karthiksing05/robot-as-a-verifier/docs/README.md

# Docs

| Page | Read it when |
|---|---|
| [Product](product.md) | You want what we're building and how the demo goes |
| [System 1 and System 2](system-boundary.md) | **You're about to add code.** Which system it belongs to, and what may cross between them |
| [Architecture](architecture.md) | You want how the parts fit, and the words we use for them |
| [Integration](integration.md) | You're connecting two parts, especially Joseph's sim to the server |
| [Hotspot and Vultr deployment](../deploy/vultr/README.md) | You're setting up the robot, Arduino readouts, remote harness, or hosted console |
| [Appliance sensor setup](appliance-sensor-setup.md) | You want the MC-6 and MW-1 readings in System 1, step by step |
| [Decisions](decisions.md) | Two sources disagree, or you want to know what's still open |
| [Sources](sources.md) | You want to know what's in the Google Doc, Kanban and artifacts |

Docs about one system stay with its code: [`system-1/sim/docs`](../system-1/sim/docs), and each folder's README. The pitch is in [`pitch`](pitch).
