karthiksing05/robot-as-a-verifier/docs/pitch/README.md

# Pitch

Owner: Karthik. The story and the claims are in [`docs/product.md`](../product.md).

| Here | What it is |
|---|---|
| `demo-script.md` | The three-minute script. To write (Kanban: Write the 3-minute demo script) |
| [`films/`](films) | Two 2-minute sim films, safe to show as backup. Label them as simulated |

Numbers to quote, as of Nov 6: 119 of 122 tests passed on 16 devices the sim wasn't tuned on, 0 false failures, simulation only. [Limits to state with them](../../system-1/sim/README.md#the-3-minute-version).

Sponsor angles: Midcentury Labs (labeled failure data), BotBlox (a reliable network for cameras and sensors), Clarapath (documented, repeatable procedures).
