karthiksing05/robot-as-a-verifier/docs/decisions.md

# Decisions

Where our sources disagreed, what this repo goes with, and why. Sources: the [Google Doc](https://docs.google.com/document/d/1fRen3rUlAyUSO0AACiKA1Zz-LrHpg4sqn350Y-rfYi0/edit), [Kanban](https://claude.ai/artifact/9Dm3x26boTyvHhrqAyEpaV), Joseph's code (`system-1/sim`), the [mockup](https://claude.ai/artifact/2wY8eCvh5VkNb8QSE98Sum), and the Nov 6 product brief.

**Rule used:** a newer source beats an older one, and tested code beats a plan. Anything that needed a judgment call is marked *please confirm*. Reopen any of these by editing this file and telling the team.

## Needs a team decision

| # | Question | Why it matters | Default until decided | Who |
|---|---|---|---|---|
| Q1 | How does the real survey get depth? See R1 | Blocks real perception | None yet | Joseph, Bayan |
| Q2 | What does a real verdict read: the Pico only, or camera too? See D10 | Sets what the pitch can claim | Pico for the demo | Joseph, Karthik |
| Q3 | What stack for the Console? See D14 | Frontend started on the default; the only server so far is the local sim bridge | FastAPI plus a Vite React app | Karthik, Bayan |
| Q5 | Does MakeCU allow pre-printed parts and pre-written code? | This repo is pre-written code | Assume yes, and confirm before hacking starts | Karthik (Kanban `l-rules`) |
| Q6 | Which track, healthcare or environmental? | Sets the pitch | Decide once tracks are posted | Karthik |
| Q7 | Which model does System 2 use, and which of the tools in D28 does it see? See D27 | Sets what the trace records and what can be rejected as the model's error | The trace logs any tool name. The sim logs `robot.run_step`, `perception.*`, `touch.*` and `plan.rules` | Karthik |

## Open risks

| # | Risk | Detail | Next step |
|---|---|---|---|
| R1 | **The real survey has no depth path on a Mac** (closed: the team dropped the iPhone, and `rgbperceive.survey_wrist` surveys with the wrist camera) | Joseph's survey uses iPhone LiDAR. The Doc's stack uses Continuity Camera, which is color only, and dropped Record3D because it has no macOS wheel. Nov 6: PyPI has no macOS wheel, but `record3d` 1.4.1 builds from source and imports on an Apple Silicon Mac (Python 3.12, CMake). `real_cameras.PhoneCamera` reads it. Not yet tried with a phone plugged in | Run `tools/cam_check.py lidar` with the iPhone on USB. If it fails: Record3D on the Windows laptop, or the panel plane from the ChArUco board plus a wrist scan. Kanban: *Decide the real survey's depth source* |
| R2 | Nothing has run on the real arm | Every number is from simulation. Glare and real plastic are the largest unknowns | The [bench tests](../system-1/sim/docs/sim-vs-real.md#first-things-to-measure-on-the-real-arm), first thing |
| R3 | Catching a real fault is only proven in sim | `system-1/sim/faults.py` jams `button_2`, and the run correctly fails it as stuck (Nov 6, depth route). Nothing has been tried on the printed Rev A | Rig Rev A and repeat on the real arm |
| R4 | Knobs are never tested | Turning one needs a pinch, so they are always refused | Fine for the demo: our appliance has no knob |
| R5 | Onshape parameter updates are unconfirmed | D23 depends on changing parameters through Onshape's API. Its docs cover Part Studio glTF export, but updating parameters hasn't been tested, and it adds setup risk at the event | **Mostly retired Nov 7.** `system-2/cad/tools/onshape_spike.py --scratch --public` passed 19 of 19 on a throwaway document: create one, add a variable, a sketch and an extrude, branch from a version, change a variable (the parts grew from 10 to 15 mm in the branch's assembly STEP), update, add and delete features, FeatureScript, a shaded view, STEP and glTF export, a version, and the assembly STEP loaded by our checks with its part names. Calls are recorded in `system-2/tests/fixtures/onshape/spike/`. Left: the same run on a copy of the real appliance. **Free Onshape accounts can only create public documents**, so the team's model, the analyst's branches and Rev B are public unless someone has an Education or paid account |

## Resolved

| # | Topic | Sources said | We go with | Why |
|---|---|---|---|---|
| D1 | Framing | Doc Overview: usability documentation on a Keurig. Doc Oct 31 and mockup: self-evolving hardware. Joseph: robot product tester. Brief: verifier for hardware R&D | The brief. Self-evolving is the fix loop, usability is the pitch story | Newest, and it includes the others |
| D2 | Force sensor | Doc stack: tip load cell + HX711. Doc Touch tab: FSRs and a load cell under the product. Joseph: SensX 25 pad + servos, "the team's". Kanban: borrowed sensors, load cell "if needed" | **SensX 25 pad**; load cell is the fallback. *Please confirm* | Tested: 119 of 122 with the pad, 120 of 122 with a load cell. The pads are in hand |
| D3 | Depth for the scan | Doc: Depth-Anything-V2-Small at 14 to 18 cm. Joseph: plane sweep over photo pairs 15 mm apart, at about 12 cm. Kanban: test Depth-Anything | **Plane sweep.** D405 stays the fallback (`--depth`). *Please confirm* | It's what's built and measured. No Depth-Anything code exists |
| D4 | Detector | Doc: OWLv2 or Grounding DINO, plus DINOv3. Joseph: OWLv2 + SAM 2.1 tiny | OWLv2 + SAM 2.1 tiny | Built and measured |
| D5 | Classifying parts | Doc and mockup: the model says what each part is. Joseph: rules on measured shape | Rules first. The model may add labels and manual matching | Works without a network, and keeps System 2 out of the measurements |
| D6 | IK | Doc: own `ik.py` on placo 0.10.2 | **Drop placo.** Use `robot.IK` | Tested Nov 6: `lerobot==0.6.1` and `placo==0.10.2` can't install together (numpy `<2.3` against `>=2.3,<2.4`). `robot.IK` exists and is what the results used |
| D7 | Install | Doc's command fails on D6 | `uv sync` extras in each system's `pyproject.toml`, one lockfile per system (D28). Only `opencv-contrib-python` is installed | Tested on Apple Silicon. lerobot's headless OpenCV would overwrite the `cv2` that has ChArUco |
| D8 | Skills | Doc: press, press_hold, push_latch, hook_pull. Older tab: press, turn, pull, lift and others. Joseph: press, flip, slide, turn, push_latch | Joseph's five are the closed list today. `press_hold` and `hook_pull` are planned | Built |
| D9 | Verdict words | Joseph: PASS, FAIL, MISSED, REFUSED, ABORTED. Mockup: passed, failed, observed, skipped, plus nine failure labels | Contract uses the mockup's. [Mapping](integration.md#units-and-vocabulary) | The sim's words stay in the sim. MISSED is kept apart from FAIL, so the robot's failures aren't blamed on the device |
| D10 | What decides a verdict | Mockup: camera and force only, wires are an independent check. Joseph and Kanban: the device's readout. Sim docs: reading a real device isn't built | Demo: the Pico readout decides, with force as evidence. Camera reading is the path to unwired products. *See Q2* | Most recent and matches the code |
| D11 | Concept memory thresholds | Older Doc tab and part of the mockup: 5 interactions. Doc stack: ancestor with at least 20 | 20 for expectations; below that, use the ranges table | The stack tab records a tested reason: small leaves gave biased means |
| D12 | Size check | Doc loop tab and Joseph's page: from depth. Doc stack and mockup: CAD kernel | CAD kernel bounding box | Stack tab is later, and it's exact |
| D13 | CAD format | Mockup: `testbox.scad`. Doc: OpenSCAD or CadQuery, then CadQuery | A JSON parameter patch behind `CadBackend`. The engine is now Onshape, see D23 | Patch format settled Oct 31. CadQuery was the engine until D23 |
| D14 | Front end | Doc: Rerun plus a static Jinja report; Streamlit and Gradio dropped. Kanban: editable graph, approvals. Brief: chat and steering | A web Console. Rerun stays for live force traces and the report stays HTML | A static page can't do chat or steering. *Stack is Q3* |
| D15 | Steering | Brief: steer at any time. Doc: model calls only between steps | Commands apply at the next step boundary. E-stop is immediate | Meets both |
| D16 | Owners | Doc tabs differ from each other. Kanban updated Nov 6 | Kanban | Newest |
| D17 | Demo machine | Doc: Karthik's MacBook. Kanban: Bayan's device. Joseph develops on Windows with an NVIDIA GPU | **System 1 runs on Joseph's Windows laptop. System 2 runs there too, or on Karthik's Mac.** Code stays cross-platform, except the wrist camera driver: `real_wrist.py` is the only one, as Joseph's PR #5 proposed | Karthik, Nov 6. The arm, cameras and GPU are on one machine, and System 2 may reach them over the network. `real_wrist.py` is Windows only, which fits |
| D18 | Localization route | Doc and mockup: unfamiliar device is the headline, CAD is the backup. Brief: CAD optional | The same. `register_cad` isn't built, so the backup today is taught poses | Consistent across sources |
| D19 | Demo length | Mockup check page: 90 seconds. Kanban and Doc: 3 minutes | 3 minutes | Newer |
| D20 | Servo voltage | Doc: open, 7.4 V or 12 V. Sim docs: the team's RobiServo-01, a 12 V clone | 12 V. *Please confirm* | Joseph's scripts assume it |
| D21 | Force caps | Mockup examples: 8 N. Code: 5 to 6 N per skill, 14 N the most a step may ask for, 15 N hard cap | Code values, until the day-1 scale test | Tested in sim |
| D22 | Console style | Mockup: Barlow Condensed and IBM Plex. Karthik, Nov 6: industrial, minimalist, serif plus technical fonts | Graphite and amber in a dark theme that isn't too dark, with a light theme available. Source Serif, JetBrains Mono, and Michroma for high-level moments only, with seamless motion leading. [Style study](https://claude.ai/artifact/Wmmtfsv3LoUoZ2ENZ3Dup7) | Karthik's choice. The Coverage Console mockup is dropped |
| D23 | CAD in the Console | Brief and D13: CadQuery, MCP optional. Karthik, Nov 6: Onshape, all within the application | Onshape as the engine, shown in our own viewer with parameters and an agent activity feed. Whether CadQuery stays as a fallback is undecided. See R5 | Confirmed by Karthik, Nov 6. Onshape's headers block iframes from our app, checked Nov 6 |
| D24 | Who approves | Plan: a teammate approves. Brief: a person approves before the arm moves or a patch prints | Karthik, Joseph, Max and Bayan approve. Judges can steer but can't approve or enter Prod. A CAD patch needs someone other than its author | Confirmed by Karthik, Nov 6. The Console applies this in the browser until a server does. With D25 anyone can change who they're acting as, so it's a courtesy for now |
| D25 | Entering the Console | Karthik, Nov 6 first asked for a light account and password system, then for a Go button replacing all logins | No login. Choose Demo or Prod, then GO. The top bar sets who you're acting as. Staging is dropped | Karthik's choice. Demo is the sim. Prod is where we do real interfacing, with the real arm and real CAD, and it's empty until those connect. Local only: real accounts belong on a server before this leaves localhost |
| D26 | Watching a run | Doc: Rerun for live force traces. Karthik, Nov 6: cameras and flowchart updating in real time, inside the Console, from Joseph's MuJoCo code. Revisit a run in one click, no tabs | `system-2/console/server/live_sim.py` runs `explore.py` unchanged, 4x by default. The browser draws the main view from streamed body poses, and the other cameras stream as pictures. Each run saves its poses, the other cameras and a timeline, and replays in the same 3D view. One page per run | Server-rendered pictures looked slow and capped at 30 fps, though the physics alone runs at 36x real time. Speed changes the pace of sim time on screen, not the physics. Stdlib HTTP for now, see Q3 |
| D27 | Diagnosing a run | Karthik, Nov 6: a frontier model will operate the robot as if it were an MCP server, with tool calls throughout, so logs must separate LLM failures from pipeline failures | `model_turn` and `tool_call` events in the run log, shown in the stage pane. Each failure is filed under Model, Pipeline, Robot or Device. [How it works](integration.md#the-model-trace) | The kind of error is recorded where it happens. Sensors still decide verdicts: a model's claim is only checked against them. See Q7 |
| D28 | System 1 and System 2 | Earlier docs: System 2 is only the model, and packages share contracts. Karthik, Nov 6: two root folders, one for the robot and one for the harness and Console, with as little traffic between them as possible, MCP-style by default and open to alternatives | [`system-1/`, `system-2/` and a shared `docs/`](system-boundary.md). MCP for control, with no motor or joint tool; separate one-way telemetry for the Console. A clean FAIL always wakes System 2. Start with frequent deferral and scale back from measurements. Amended plans get [priority levels](system-boundary.md#approving-an-amended-plan), so not every one needs a person | Karthik chose these Nov 6, including routines-only writes, so low-level control stays in System 1 |
| D29 | How the analyst fixes the CAD | D13 and the Doc: a one-parameter JSON patch. Bayan, Nov 7: the analyst has the robot's evidence, so it should CAD the fix itself, in Onshape, where the team's models are | The analyst edits the real Onshape model on a **branch of its own** made from the tested version, through the `rav-cad` MCP tools (features, variables, measure, render, check, submit). Generic robot-centred checks judge the exported STEP: scope (one control's reprintable parts), no overlap, free motion, fit clearance, fingertip reach and a hookable pull. A person approves; the backend makes the Rev B version and exports only the changed parts. CadQuery stays as the offline fallback (settles D23's open question) | Branches keep the tested version untouched, and checks on any product's geometry, not our parametric code, make it work beyond the planted faults. Waits on R5. Built by Bayan, Nov 7 |
| D30 | Who can run the sim | Karthik, Nov 7: optimize the SO-101 sim so anyone can work on it, kept to the front end | `sample-sim`, a real recorded run, replays in 3D with only `npm install`. A `live-depth` install runs the bridge without PyTorch. The viewer lowers its own quality to keep up | Read as: any teammate, on any laptop, with no sim setup. System 1 is untouched. Results were identical with the server's render on and off, at 1x, 4x and 8x. Tried on one Mac only, so Windows and Linux are unproven |
| D31 | System 1 for an outside caller | `system-1/HANDOFF.md`'s suggestions, Karthik's to Joseph, Nov 7. Joseph hasn't answered yet, so **each is a default Joseph can overrule** | A new device means restarting the server, with no reset tool. Plans are validated from the contract alone (`check_steps`), so no robot or worker thread is involved, and what depends on where a part will be stays a refusal at run time. A failed `Step.check` is reported beside the verdict and wakes System 2 as `unexpected_response`, without changing the verdict. The force limit a step may ask for is 14 N, and above that it's rejected rather than clamped. Test devices: preset C and generated seeds | Built by Karthik's side, Nov 7, because the model integration needed it. Verdict rules and `plan_tests` are unchanged |
| D32 | Force sensing with servos only, at stretched poses. **For Joseph to review and measure** | The real arm is a stock SO-101 with nothing added, so force comes only from the servos' own estimate (`sensing="current"`). In the sim, low and far poses near the test devices' dials and toggles (tip z about 20–30 mm, about 250 mm out) read 6–13 N with about 0–4 N really on the tip, always along one direction | **The 15 N hard cap is unchanged and still reads the plain estimate.** Skills only stop trusting it where it can't be right: a descent needs the pad to stall before it counts as landed, and the side-force and pushed-off checks scale the estimate by how well the joints feel each direction (`ArmBase.weighted_force_vec`). Two cap changes were tried and **backed out**: a free-air baseline pass (the drift appears with contact, not in free air: 1.5 N in the pass, 12 N in the push) and fitting the force at the fingertip's contact point (no change). Stock-gripper turns there still stop at the cap, so they're reported as not working rather than worked around | The cap protects the arm and devices, so it isn't changed without a measurement. The errors lie along the Jacobian's weakest direction: its smallest singular value falls to 0.045–0.06 m there, against 0.11–0.13 m on the default rig, and that direction is about the probe's own axis on the slanted panels. **Whether this is real or a sim artifact can't be told from the sim.** The sim's estimator ignores the gear friction the sim itself models (Rhoban BAM fit, about 0.28–0.43 × load), and friction divided by a small singular value would give this pattern. A real rig's estimator has the same blind spot unless it models friction. To measure on the raw arm: hold the tip over a dial at the centrifuge pose (tip about 250 mm out, 20–30 mm up, tool 45° down), move 15 mm slowly in free air, then press a kitchen scale with about 3 N, and log the estimate both times. Under about 2 N of error means it's the sim |
| D33 | Free-form geometry offline | D29: Onshape is the only path where the model designs new geometry; CadQuery only changes built-in parameters. Bayan, Nov 7: let the model generate new geometry with CadQuery too | The analyst writes CadQuery code that makes a new solid for a reprintable part, in a local workspace per finding (`rav-cad-local` tools), run in a separate process with an import allowlist and a time limit. The same generic checks judge it, and `apply` writes the changed parts' STLs, the assembly and the code. Works on any product we have as a STEP assembly, and on our box | No Onshape quota (we hit a 20-hour per-endpoint lock; free accounts get 2,500 calls a year), no network, and the blind centrifuge test can be repeated for comparison. The sandbox guards against mistakes, not attacks. Built by Bayan, Nov 7 |
| D34 | Merging main (PRs #4–#10) into the frontier branch. **Joseph can overrule any of it** | Both sides changed the same lines in `affordances.py`, `main.py`, `sim_rig.py` and `HANDOFF.md`, and both added a D31 | Joseph's toggle fix, lost-readout back-off and counted-steps rule are kept as he wrote them. `turned_deg` comes from the skill's `turned` (the swept angle where the turn measures it, else travel over radius), which already agrees with his. `rav-server --robot real` gets telemetry like the sim, served after the torque gate; shutdown is engine, then torque off, then telemetry. Our `pipeline_error` stop wraps a scan's unknown errors, but an error raised once the real arm's torque is off (Ctrl+C) stays a `safety_abort`, as Joseph's `test_real_backend.py` requires. `make_rig` takes `device`, `rev`, `effector`, `mounts` and `driver` together; `effector="stock"` through `driver="real"` is untested. `HANDOFF.md` stays deleted and its real-arm list, with Joseph's Pico and hand-eye updates, is in the [server README](../system-1/server/README.md). A new, dated [`HANDOFF.md`](../system-1/HANDOFF.md) covers what changed since. Bayan's D31 is now D33 | Keep both sides' features, and leave verdict and safety logic as Joseph has it. The 15 N cap is unchanged |
| D35 | How a pinch-turn knows how far the dial went. **For Joseph to review** | The stock gripper's pinch-turn holds the knob at about 18 N, well inside friction, yet in the sim the knob lags the wrist in proportion to the dial's friction. On centrifuge v7's 0.015 N·m pot it turned 50° for 59° of the wrist; at 0 N·m it turned 54.6° for 55.9°. That is MuJoCo's soft-contact creep, and printed jaws on a real knob may creep or slip too | **The fix is in the skill, not the sim.** impratio, cones and noslip are unchanged; noslip made it worse because it also stiffens the knob joint's own friction. `_pinch_turn` grips again for whatever is left, up to 6 grips, until it is within 4° of the request. It does this too when the wrist roll's range ends a grip, so large turns reach the end stops. Each grip's angle comes from the robot's own measure. With a wrist camera, that is the fin's line seen before and after the grip (`perceive.refine` now sets `meta.seen_x`); without one, it is the wrist's turn while the jaws held the knob. **Never the device's reading:** a dead pot or a wrong mapping must still show as a fault | Open: from the pinch's look poses, the camera route doesn't find these dials (the gripper hides them), so the loop falls back to the wrist and still misses the creep. The next step is a look pose that sees the fin, or a dial rule that works through the jaws |
| D36 | Closing the CAD loop from a real run, and retesting a fix in the sim | The CAD analyst only ran from `rav mock` or from a recorded run whose findings already used CAD names; the Snowflake agent's runs ended at the report, and the sim set a button's travel from the revision letter, so no CAD change could reach a retest. | `rav fix` / `rav eval --fix`: a run's findings are matched to CAD controls by place (the device's pose from where its controls are, `match.py`), go to the local CadQuery analyst with tags generated from the device file (`rav_cad/appliance.py`), are applied when approved (automatic and recorded in the sim, `--approve NAME` otherwise), and on an authored appliance the same model reruns on a patched device. **Fit model:** a sliding fit under 0.3 mm per side binds and travels 0.1 mm, else its full travel; it reproduces every authored button travel (interval timer, label printer, wall thermostat, Rev A and B), so a patched device derives travel from its geometry. One line in `cad_device.py`: a device file's own `params` win over its revision's. Sliding buttons only so far. | Bayan, Nov 8 |
| D37 | Current physical appliance firmware | Earlier MC-6/MW-1 snapshots are stored beside each appliance | The standalone Uno R4 WiFi project lives in [`firmware/`](../firmware/README.md), with PlatformIO targets, operator tools and calibration records. Older snapshots and simulation definitions remain in place; the two systems' imports and control interfaces are unchanged | Max requested this top-level folder on Nov 8 |

## Not updated, on purpose

The mockup and Joseph's page are still accurate as what they are: a vision walkthrough and a results page. They mention older choices (Depth-Anything, load cell, `testbox.scad` in the mockup; "fits its size from depth" on Joseph's page). This table overrides them.
