karthiksing05/robot-as-a-verifier/docs/sources.md

# Sources

## The living ones

| Source | Use it for | Keep it current by |
|---|---|---|
| [Kanban](https://claude.ai/artifact/9Dm3x26boTyvHhrqAyEpaV) | Tasks, owners, status | Moving your card |
| [System 1 and System 2](https://claude.ai/artifact/6d9gQhE7LqDb9xUeMPYPDa) | The split, to share with people outside the code | Republishing it when [the design](system-boundary.md) changes |
| This repo | Architecture, interfaces, decisions | Changing it in the same commit as the code |

## The references

| Source | What's in it |
|---|---|
| [Google Doc: MakeCU-2026 Prep](https://docs.google.com/document/d/1fRen3rUlAyUSO0AACiKA1Zz-LrHpg4sqn350Y-rfYi0/edit) | Why decisions were made. Start at its **Current State** tab |
| [Self-Evolving Hardware mockup](https://claude.ai/artifact/2wY8eCvh5VkNb8QSE98Sum) | The end-product vision: case studies, fix loop, data objects, stage-by-stage check |
| [Self-Evolving Robots](https://claude.ai/artifact/VxmRPoiAXK3pCHxKmjgRv6) | Karthik's harness development in simulation, and the lessons for MakeCU |
| [Robot Product Tester](https://claude.ai/artifact/Fia1Xqk11wDS5uwNQLh3ci) | Joseph's results page |

## Google Doc tabs still worth reading

| You want | Tab |
|---|---|
| Parts and prices | Hardware > Parts and BOM, Sensors and Add-ons |
| Arm build, printing | Hardware > Arm and Mount, CAD Scope |
| Reasons for the stack | Final Plan > Software Stack (final), with the changes in [decisions](decisions.md) |
| Posture and budgets | Final Plan > Software Stack (final), sections 7 and 8 |
| Self-evolving tool ideas | Final Plan > Self-Evolving Robot (concept) |
| Concept memory data | Final Plan > Concept Memory (Cobweb) |
| Related work | Lit Review, Vibe-CAD and CAD Agents |
| CAD MCP options | Vibe-CAD and CAD Agents, section 5 |

The Overview, Software, Pitch and Planning tabs record the earlier usability framing and are kept for history.
