karthiksing05/robot-as-a-verifier/appliances/centrifuge/source/electronics/grove_ports.png

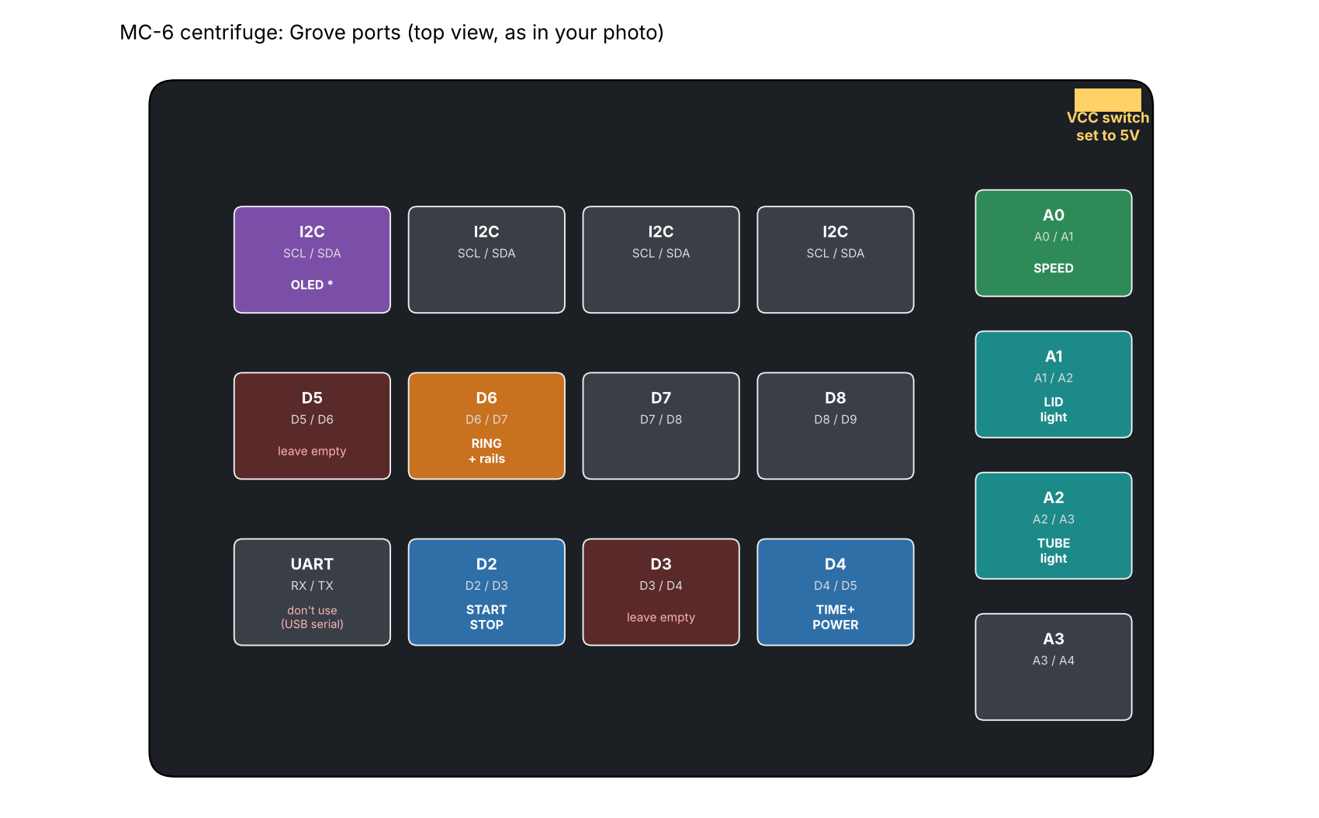
appliances/centrifuge/source/electronics/grove_ports.png
