karthiksing05/robot-as-a-verifier/appliances/centrifuge/source/electronics/schematic.png

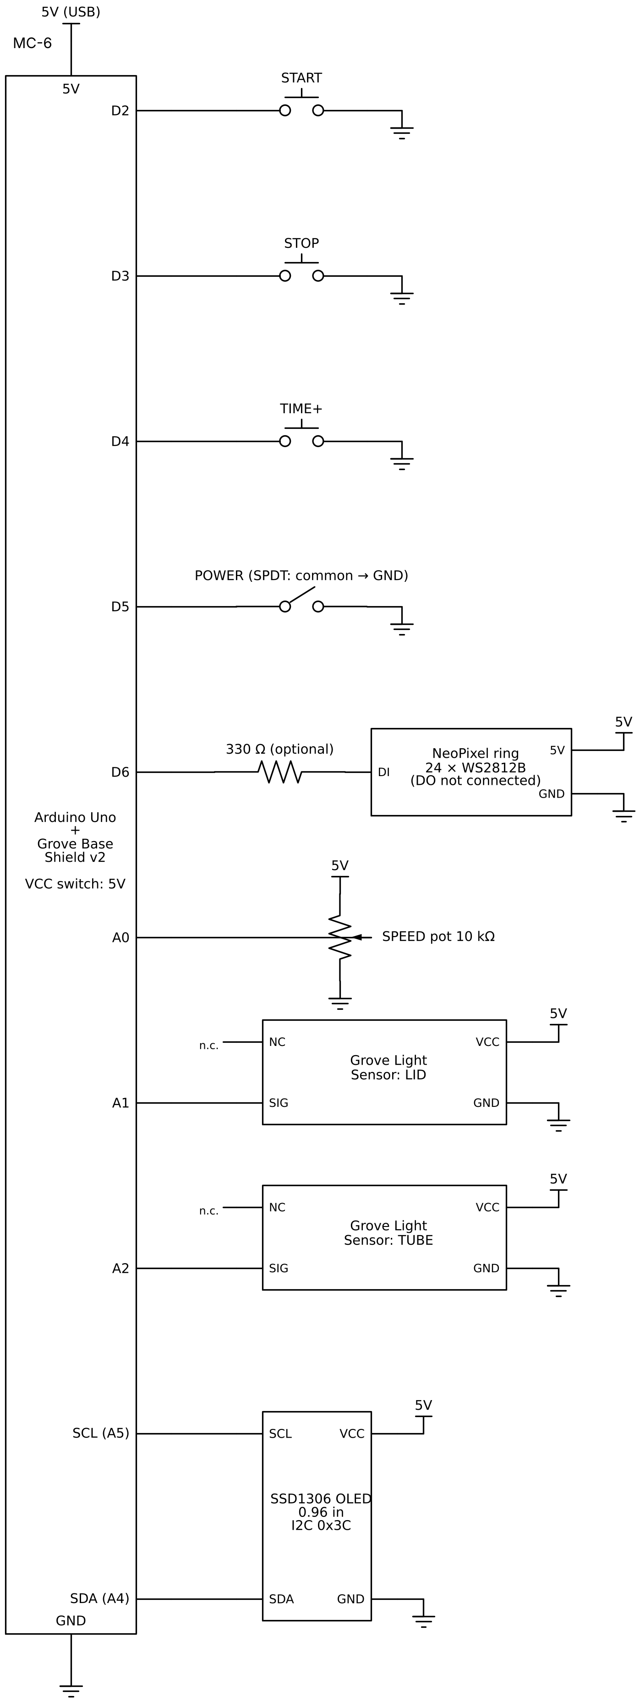
appliances/centrifuge/source/electronics/schematic.png
