karthiksing05/robot-as-a-verifier/appliances/centrifuge/source/laser/2_nested_sheets_kerf_applied/acrylic_3mm_clear_sheet1_600x300_preview.png

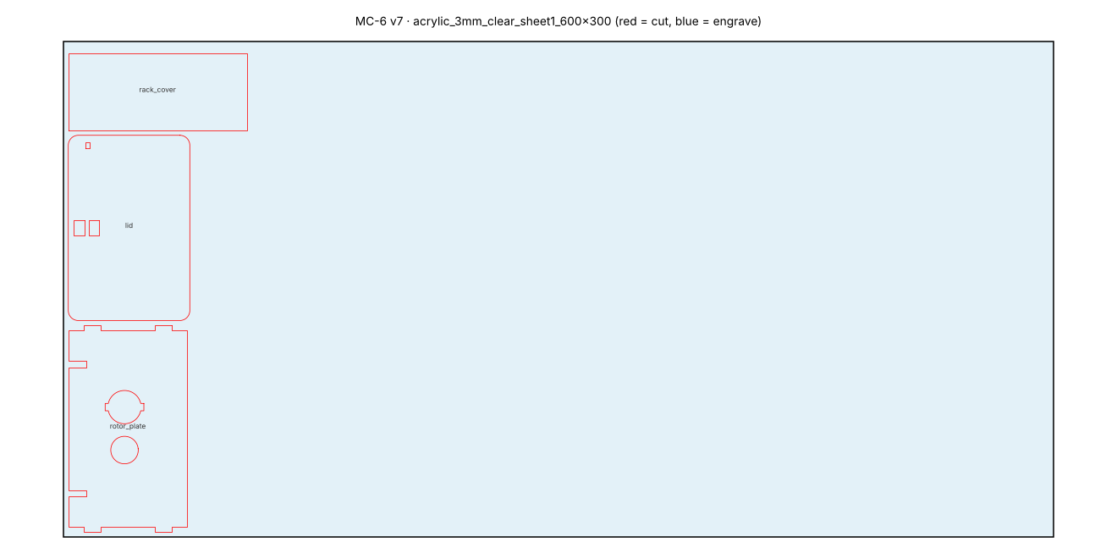
appliances/centrifuge/source/laser/2_nested_sheets_kerf_applied/acrylic_3mm_clear_sheet1_600x300_preview.png
