karthiksing05/robot-as-a-verifier/appliances/centrifuge/source/photos/control_face_panel16_preview.png

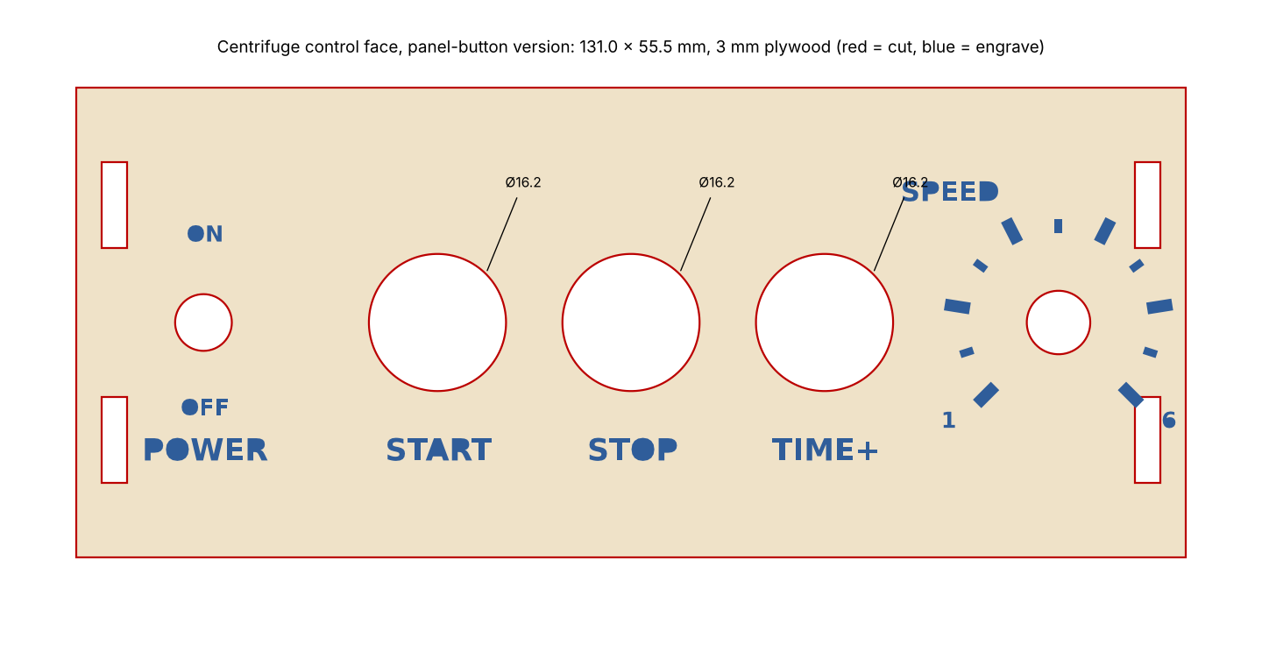
appliances/centrifuge/source/photos/control_face_panel16_preview.png
