karthiksing05/robot-as-a-verifier/appliances/centrifuge/source/photos/fig_centrifuge.png

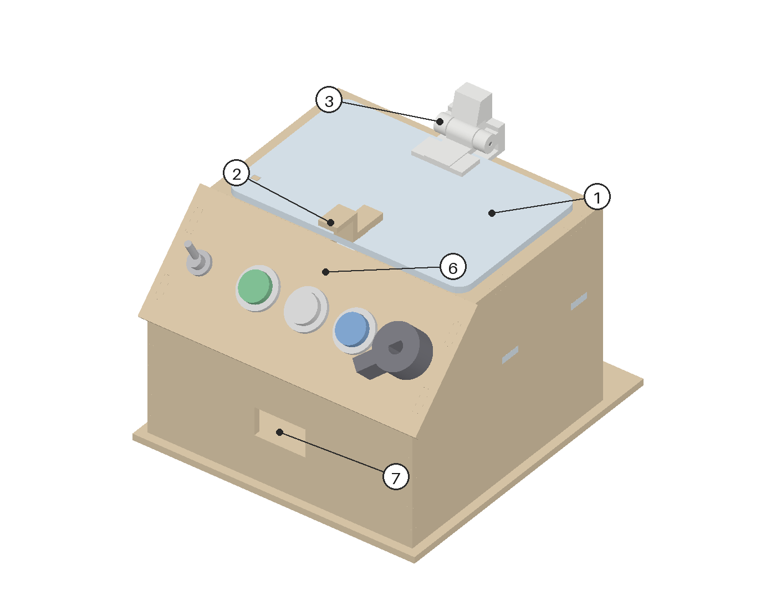
appliances/centrifuge/source/photos/fig_centrifuge.png
