karthiksing05/robot-as-a-verifier/appliances/centrifuge/source/photos/fig_panel.png

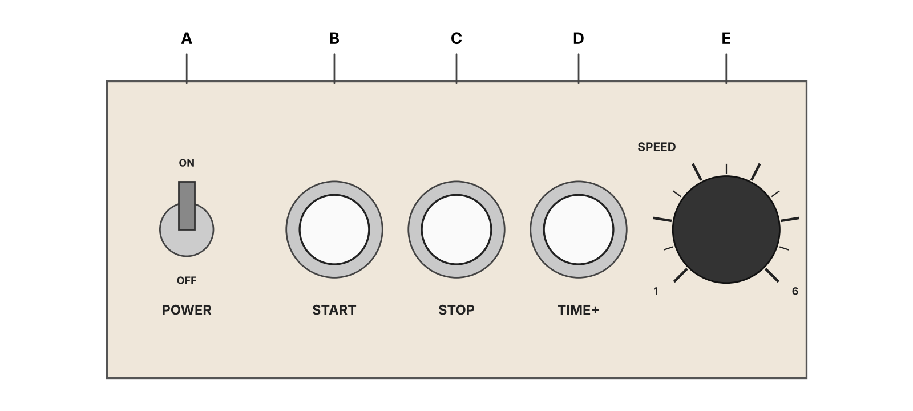
appliances/centrifuge/source/photos/fig_panel.png
