karthiksing05/robot-as-a-verifier/appliances/centrifuge/source/photos/fig_rack.png

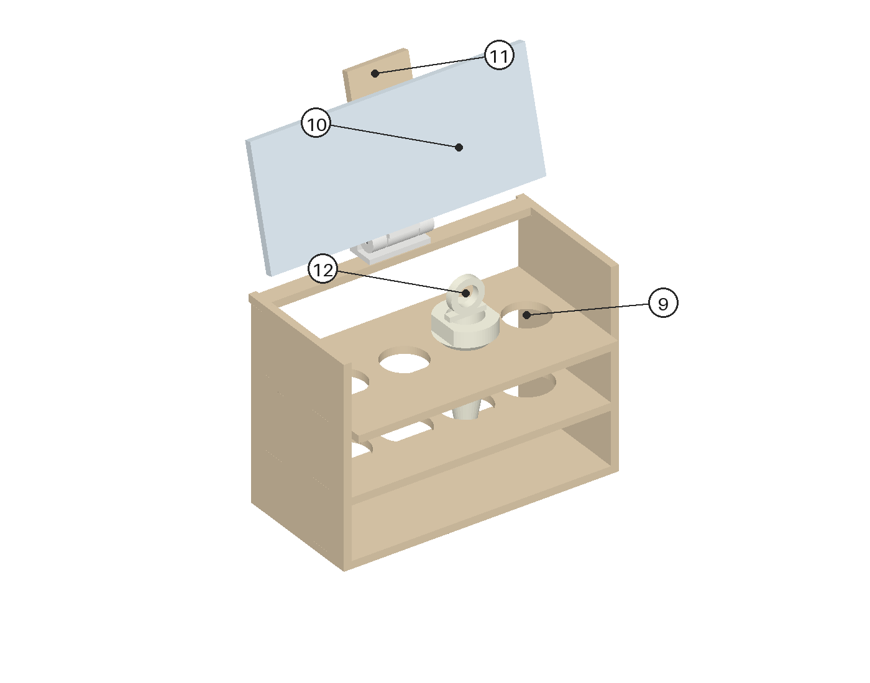
appliances/centrifuge/source/photos/fig_rack.png
