karthiksing05/robot-as-a-verifier/appliances/centrifuge/source/photos/fig_wells.png

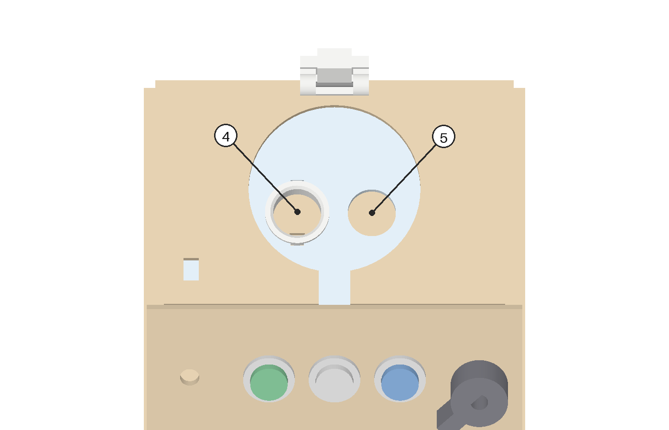
appliances/centrifuge/source/photos/fig_wells.png
