karthiksing05/robot-as-a-verifier/appliances/microwave/source/electronics/grove_ports.png

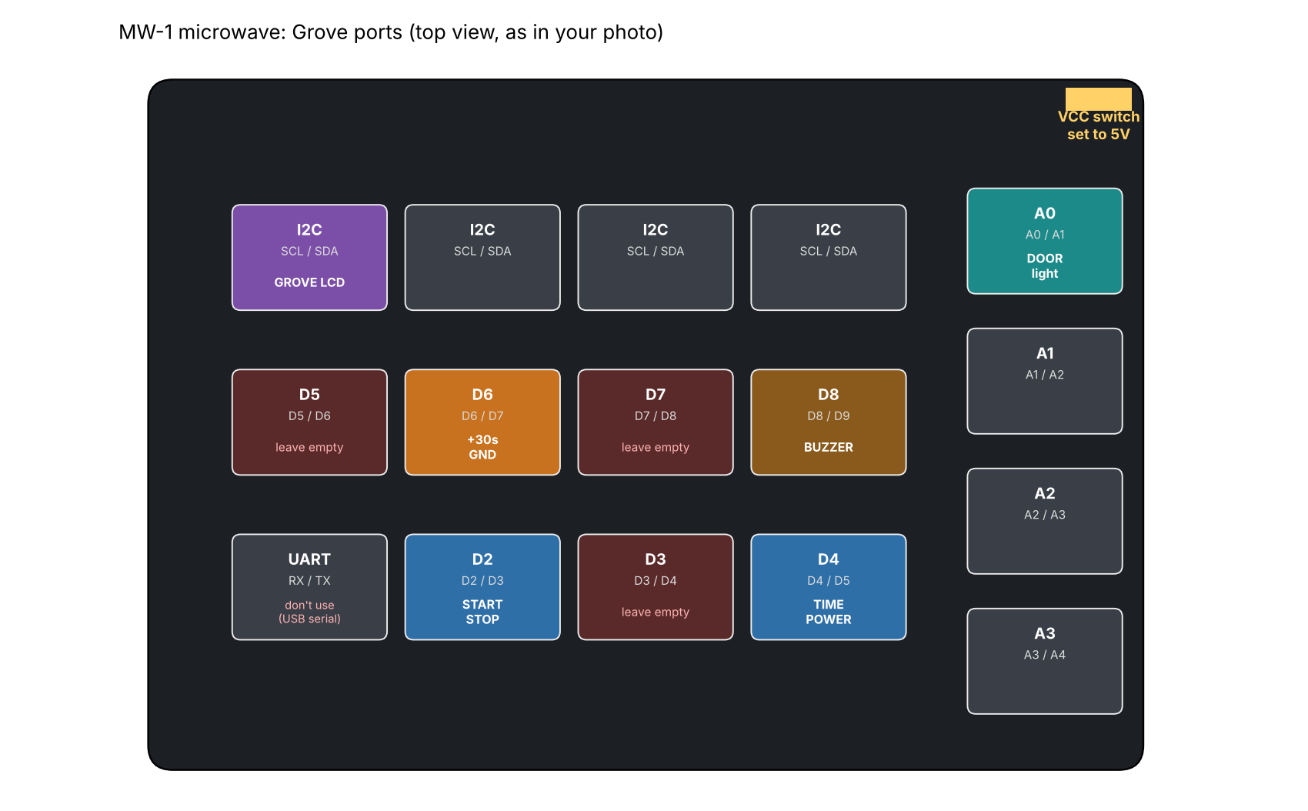
appliances/microwave/source/electronics/grove_ports.png
