karthiksing05/robot-as-a-verifier/appliances/microwave/source/electronics/schematic.png

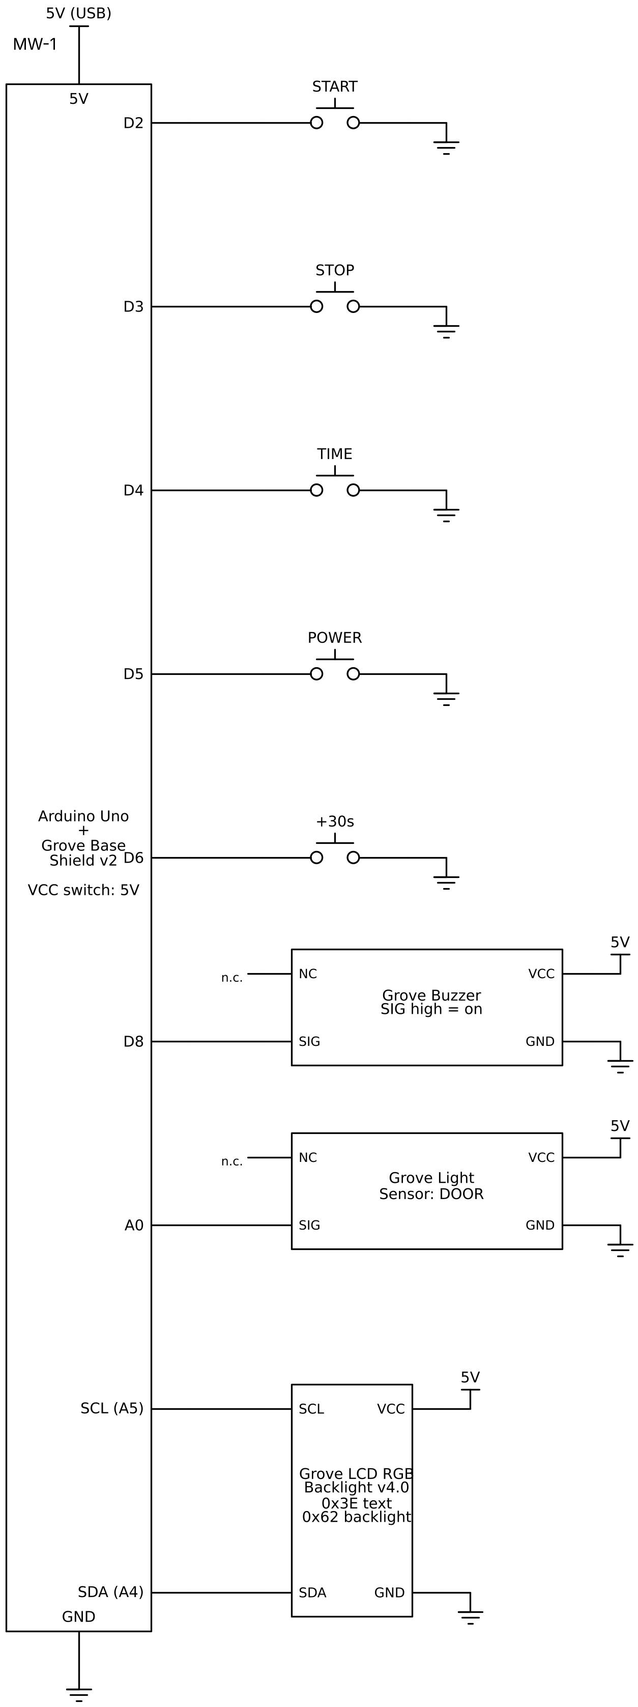
appliances/microwave/source/electronics/schematic.png
