karthiksing05/robot-as-a-verifier/appliances/microwave/source/laser/2_nested_sheets_kerf_applied/plywood_3mm_sheet2_600x300_preview.png

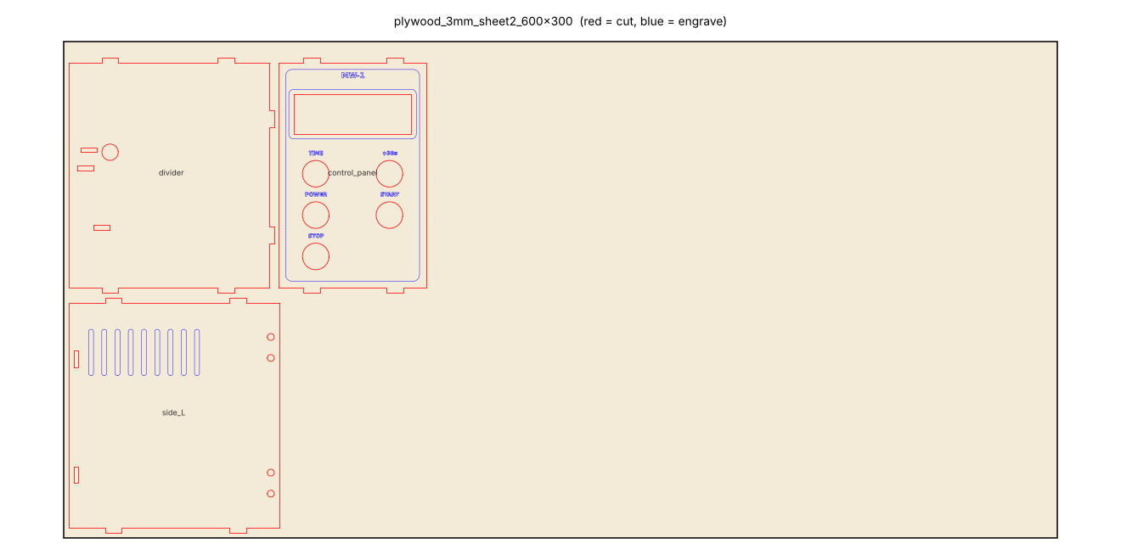
appliances/microwave/source/laser/2_nested_sheets_kerf_applied/plywood_3mm_sheet2_600x300_preview.png
