karthiksing05/robot-as-a-verifier/appliances/microwave/source/photos/01_closed.png

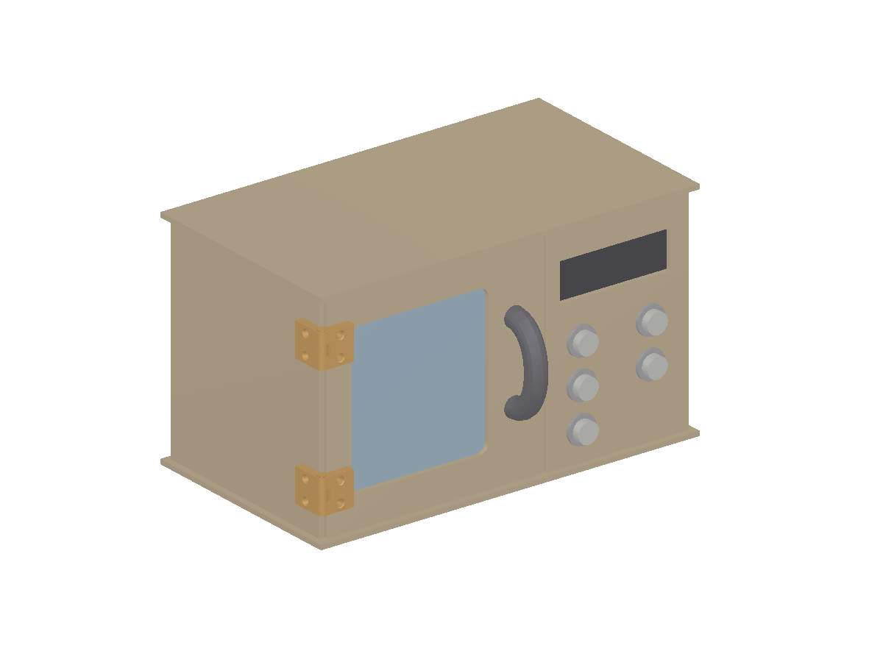
appliances/microwave/source/photos/01_closed.png
