karthiksing05/robot-as-a-verifier/appliances/microwave/source/photos/02_door_open.png

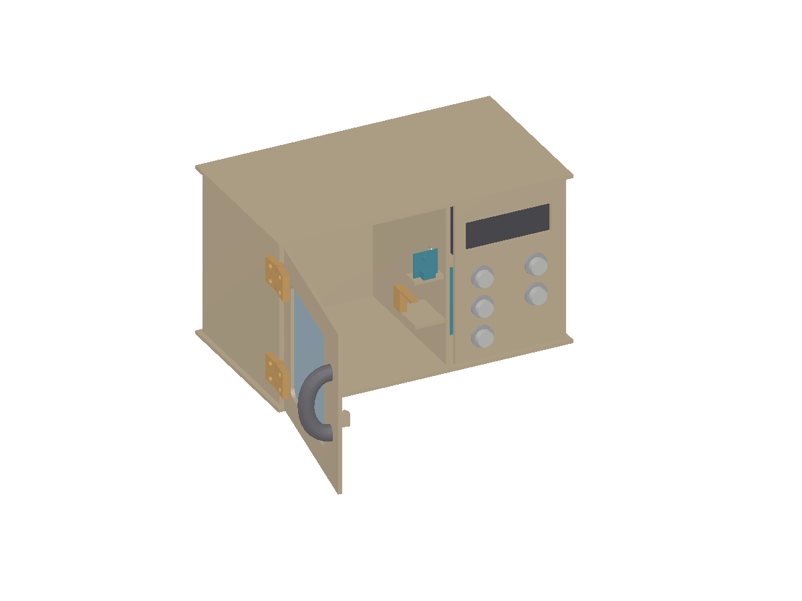
appliances/microwave/source/photos/02_door_open.png
