karthiksing05/robot-as-a-verifier/appliances/microwave/source/photos/03_inside.png

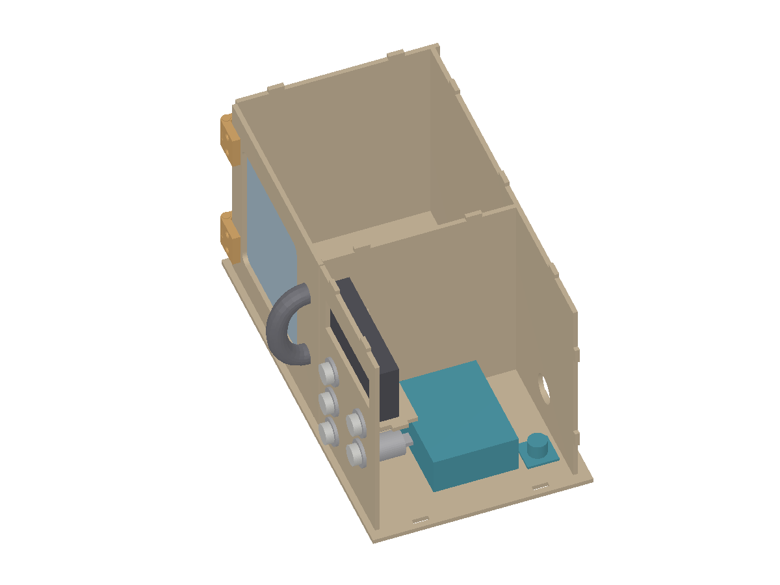
appliances/microwave/source/photos/03_inside.png
