karthiksing05/robot-as-a-verifier/appliances/microwave/source/photos/04_bay_and_latch.png

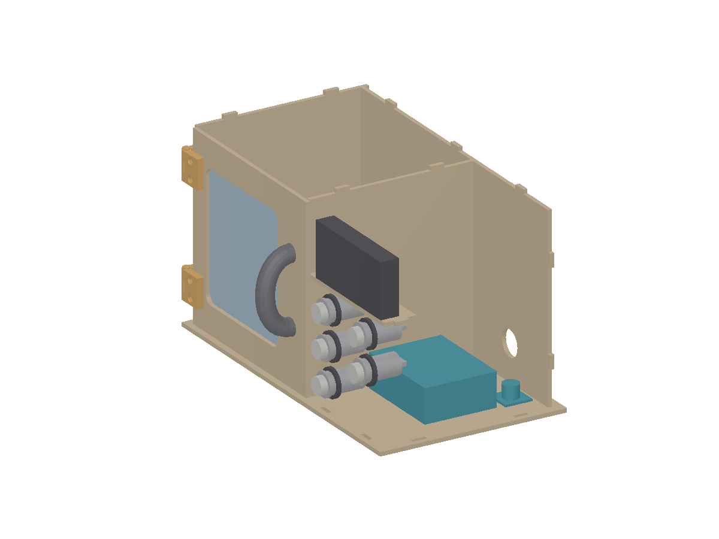
appliances/microwave/source/photos/04_bay_and_latch.png
