karthiksing05/robot-as-a-verifier/appliances/microwave/source/photos/05_front.png

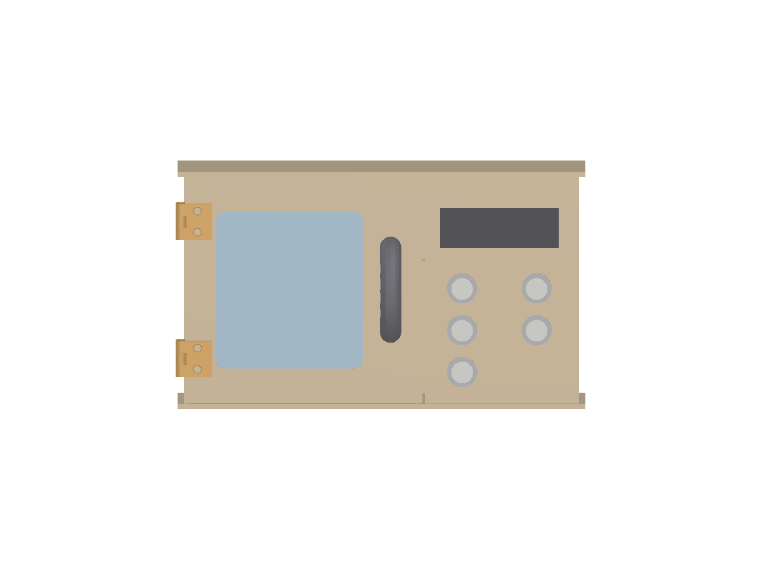
appliances/microwave/source/photos/05_front.png
