karthiksing05/robot-as-a-verifier/appliances/microwave/source/photos/06_front_engraving.png

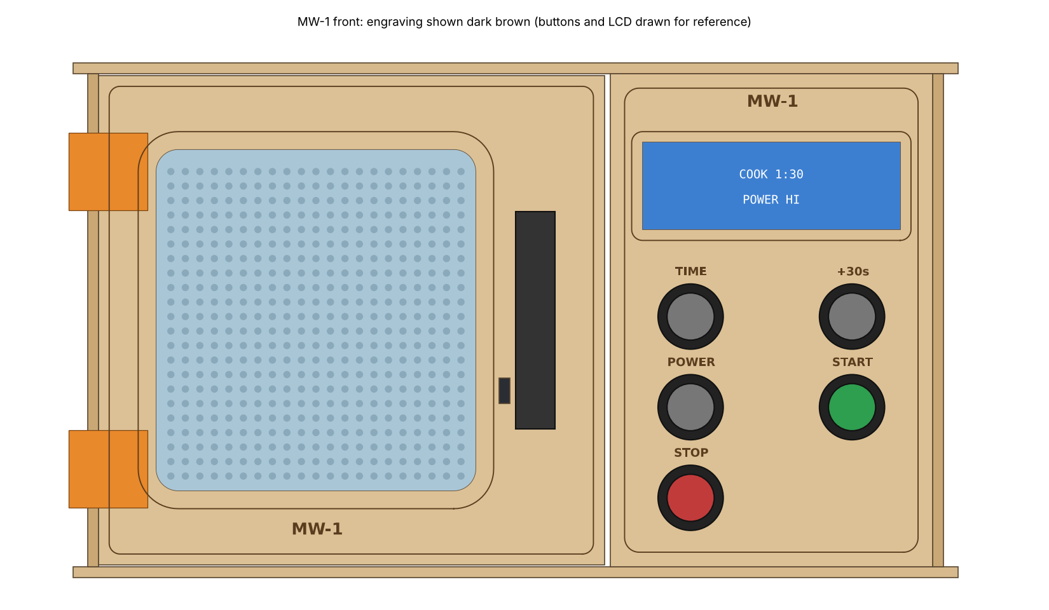
appliances/microwave/source/photos/06_front_engraving.png
