karthiksing05/robot-as-a-verifier/docs/pitch/slides/img/raav_hand.png

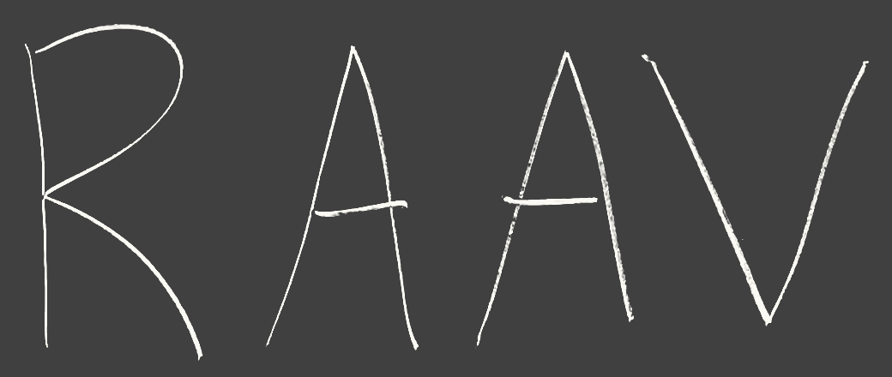
docs/pitch/slides/img/raav_hand.png
