karthiksing05/robot-as-a-verifier/docs/pitch/slides/slide_01.png

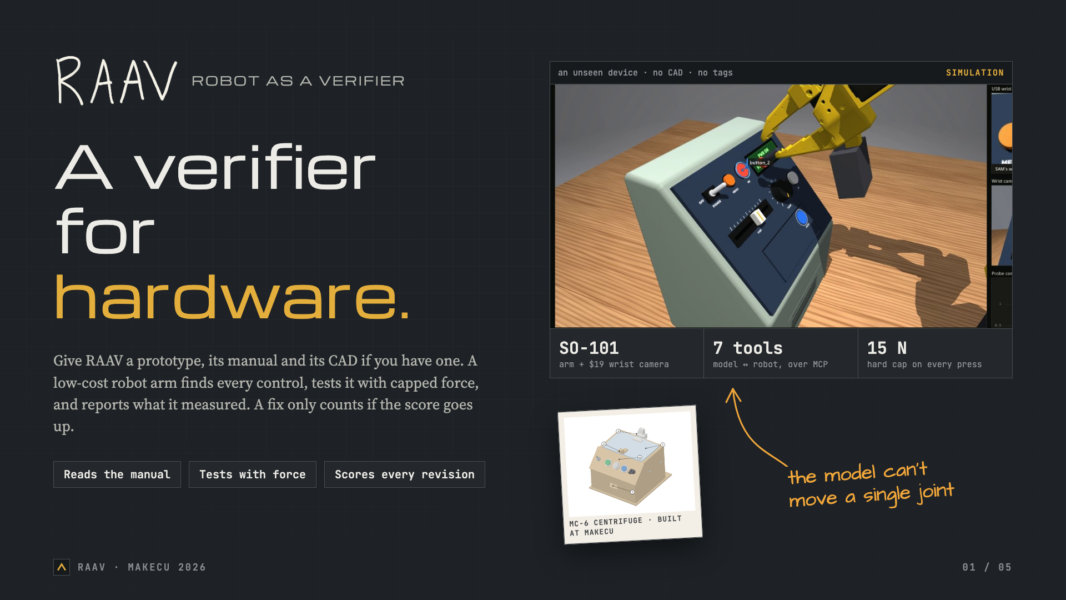
docs/pitch/slides/slide_01.png
