karthiksing05/robot-as-a-verifier/docs/pitch/slides/slide_02.png

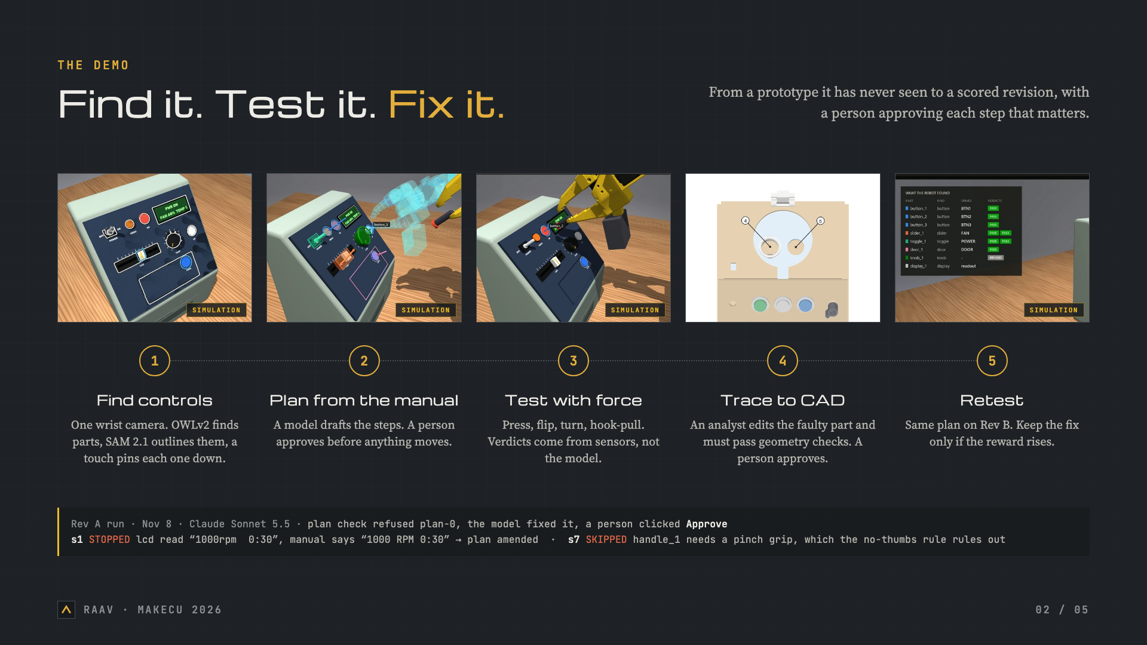
docs/pitch/slides/slide_02.png
