karthiksing05/robot-as-a-verifier/docs/pitch/slides/slide_03.png

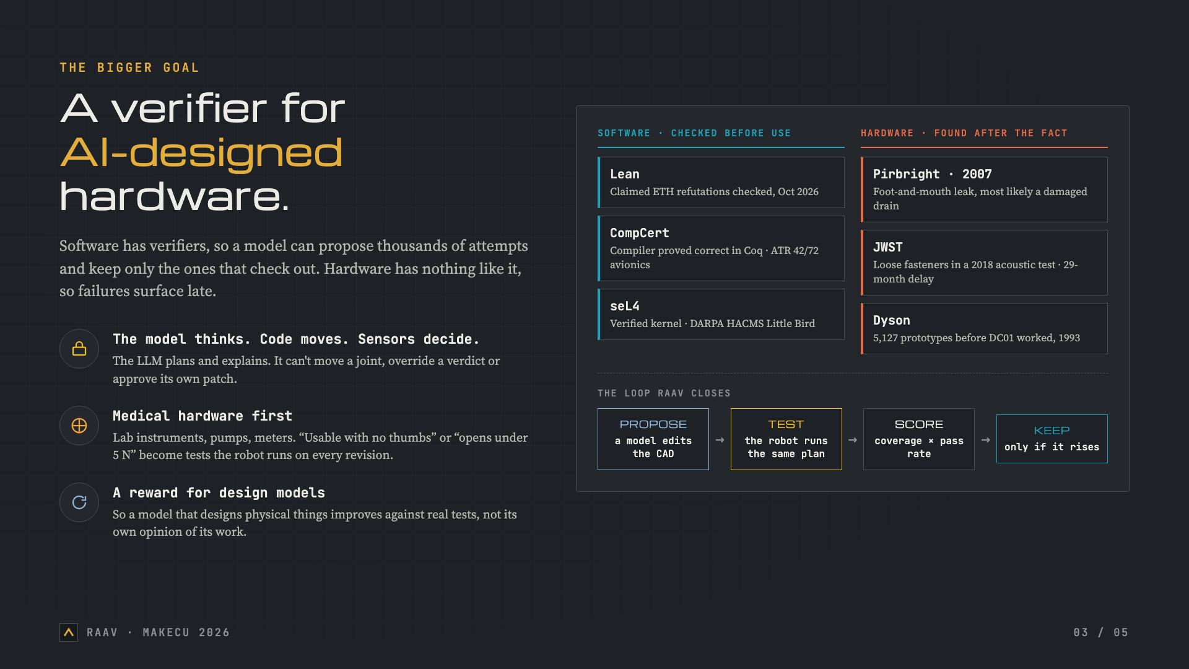
docs/pitch/slides/slide_03.png
