karthiksing05/robot-as-a-verifier/docs/pitch/slides/slide_04.png

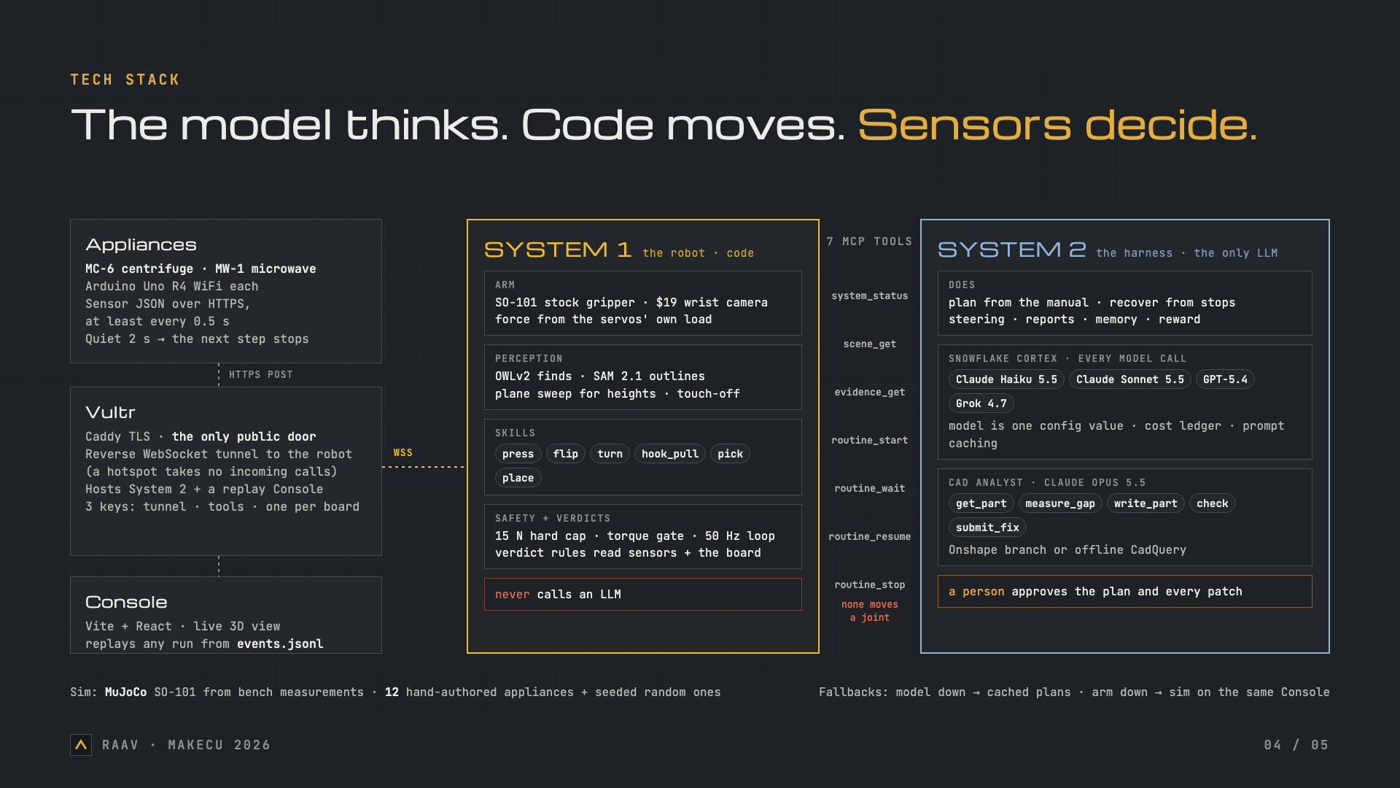
docs/pitch/slides/slide_04.png
