karthiksing05/robot-as-a-verifier/docs/pitch/slides/slide_05.png

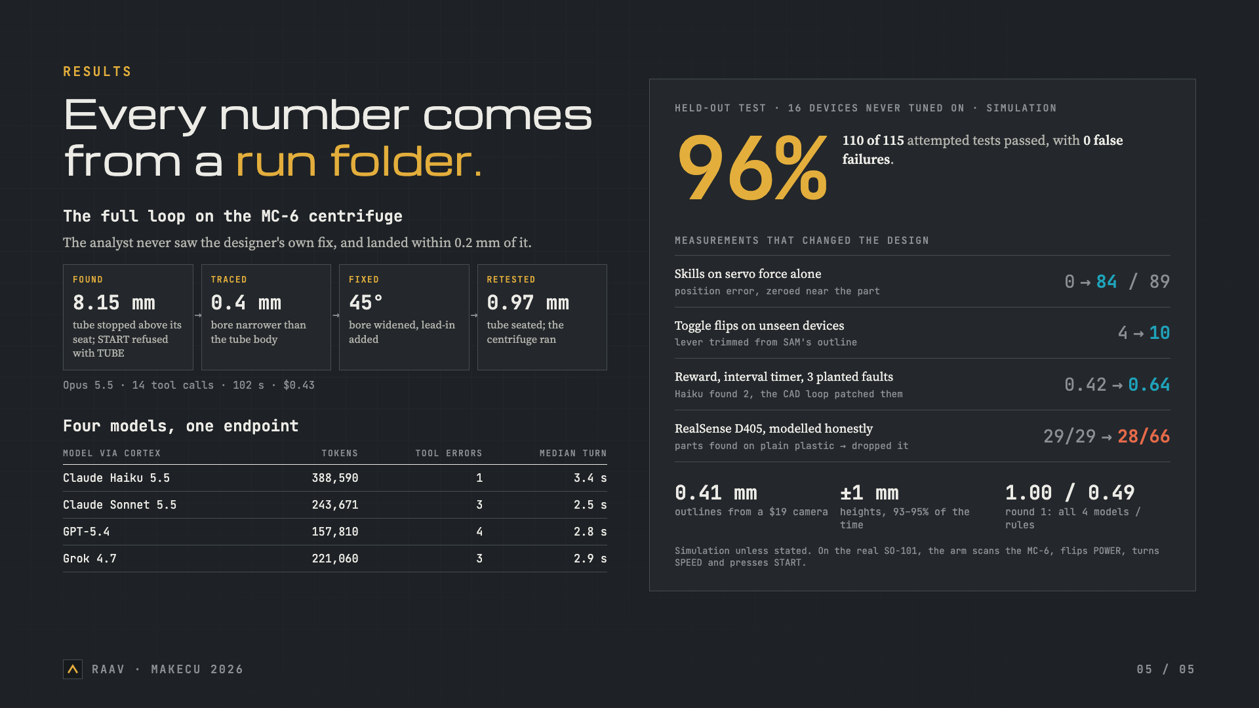
docs/pitch/slides/slide_05.png
