karthiksing05/robot-as-a-verifier/system-1/arm/camera/hand_eye_board_tab_s9fe.png

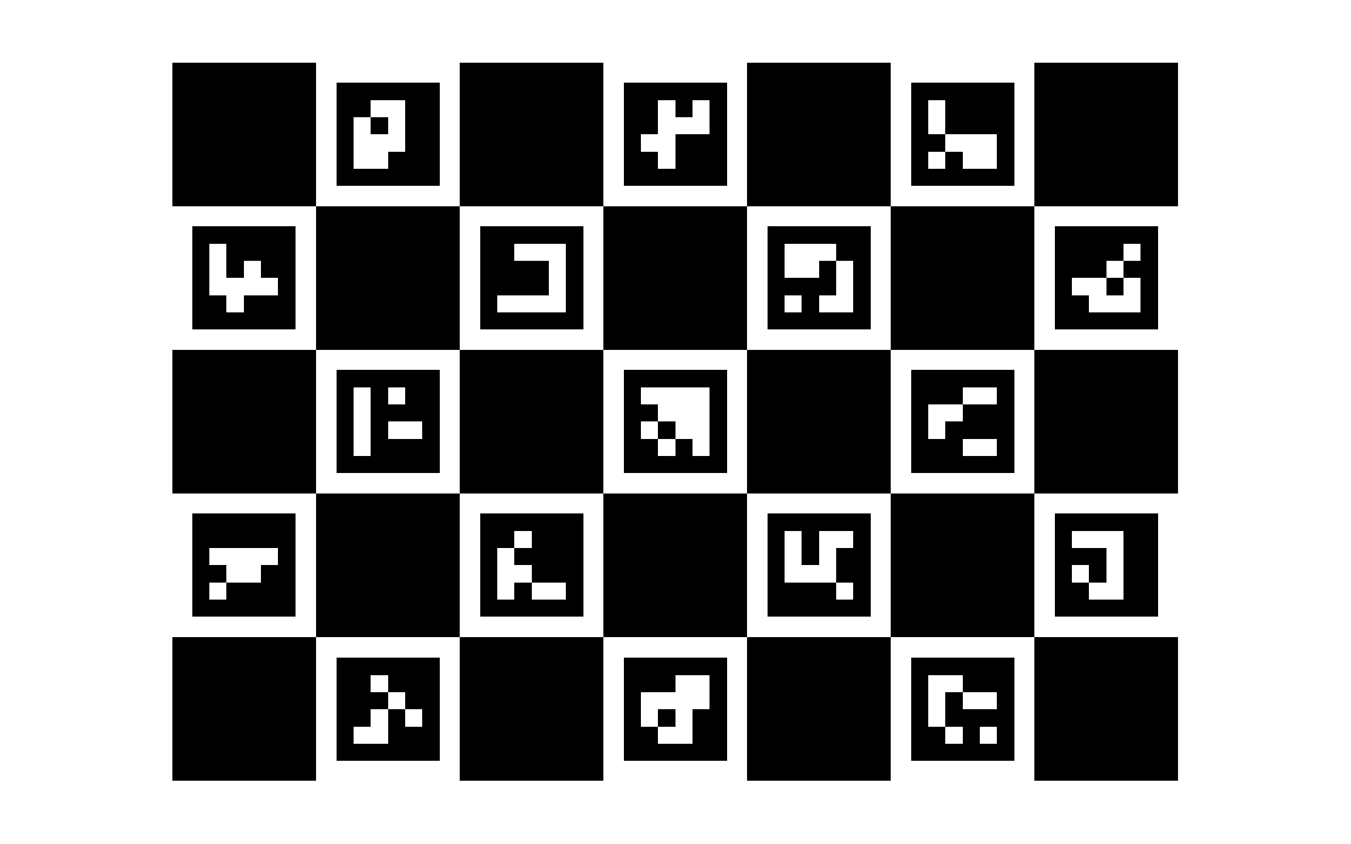
system-1/arm/camera/hand_eye_board_tab_s9fe.png
