karthiksing05/robot-as-a-verifier/system-1/arm/camera/img/calib_report.png

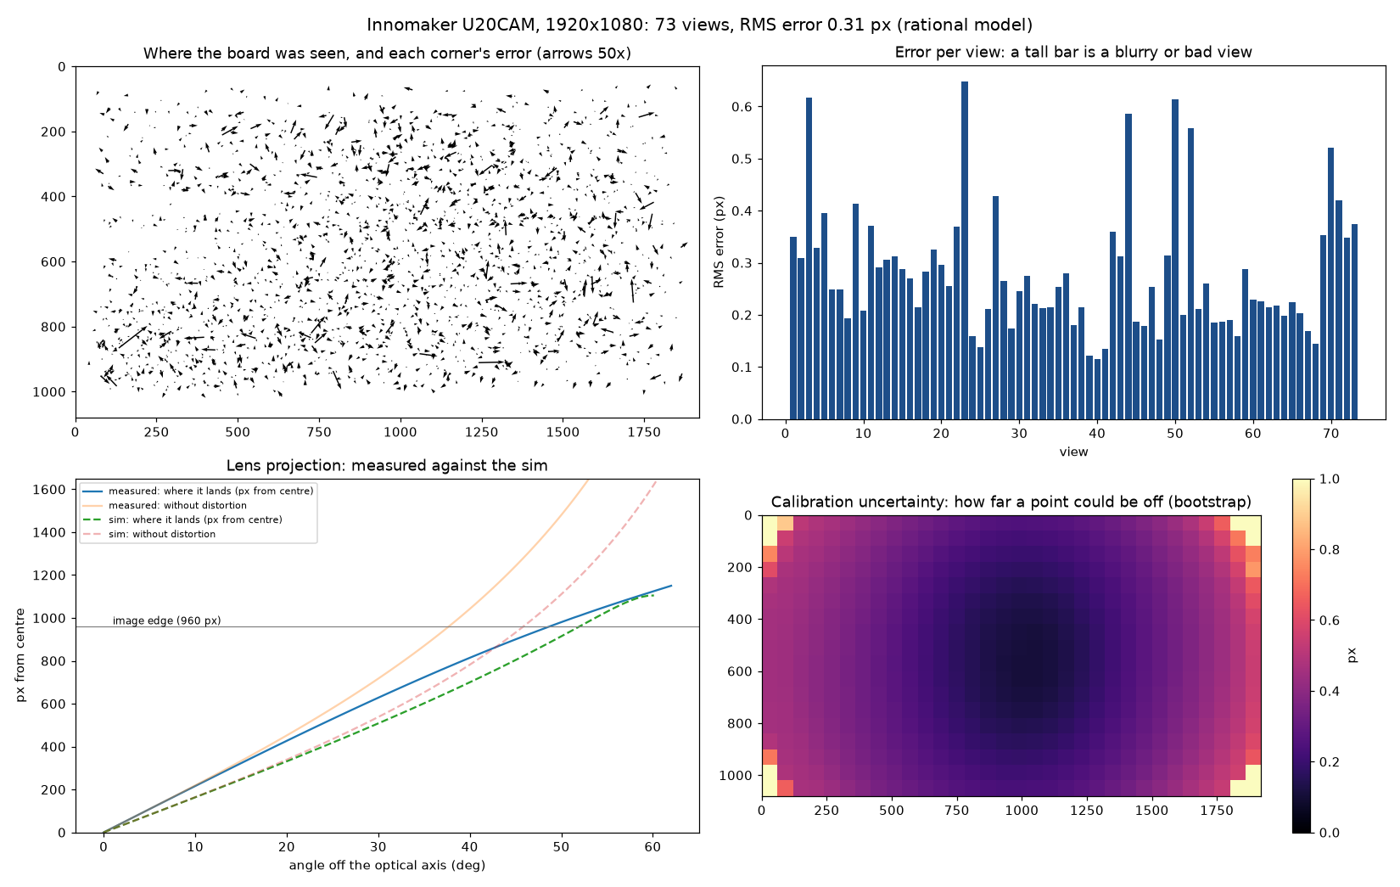
system-1/arm/camera/img/calib_report.png
