karthiksing05/robot-as-a-verifier/system-1/arm/camera/img/calib_report_laptop_attempt1.png

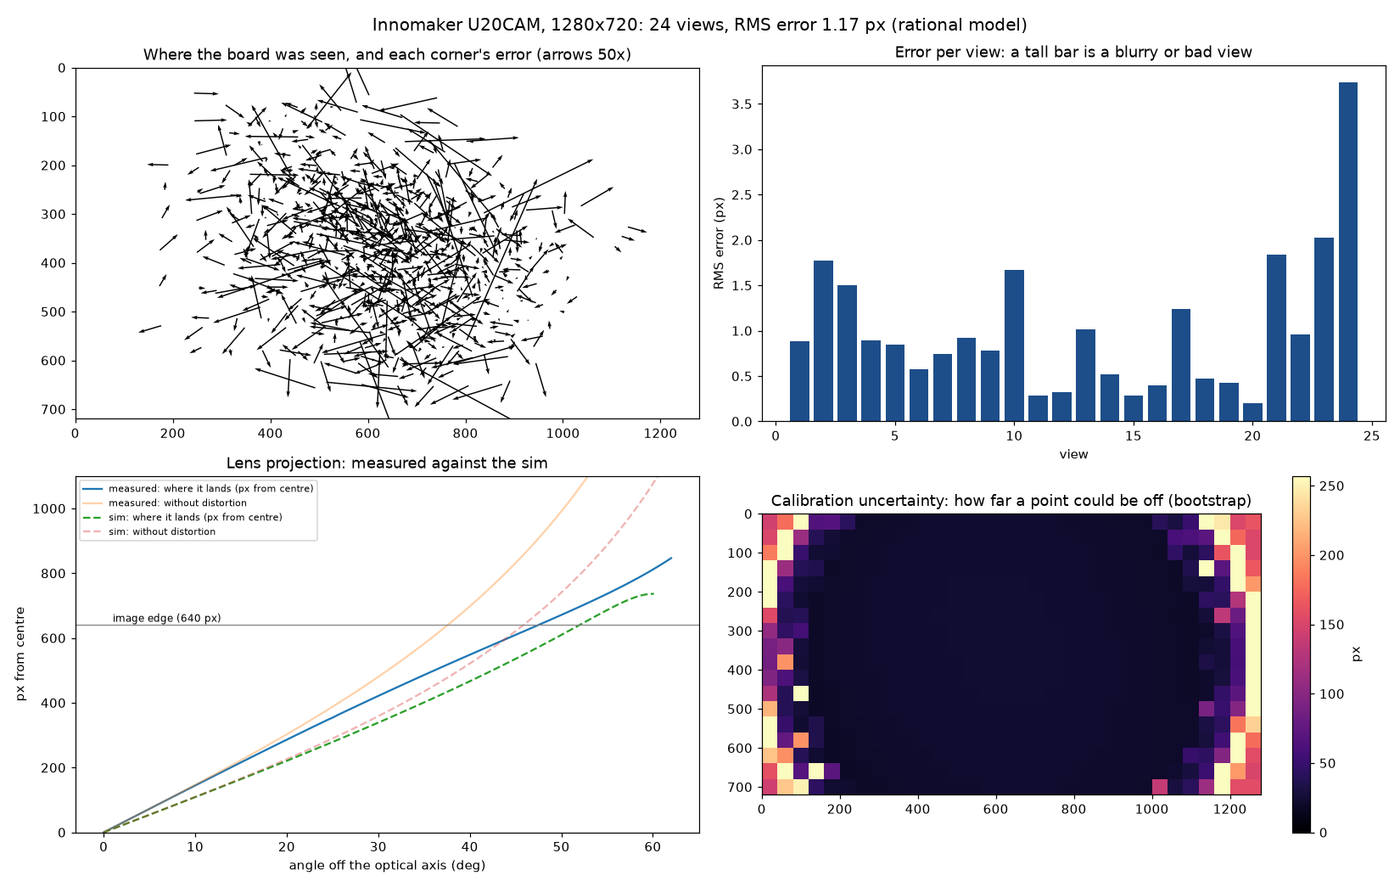
system-1/arm/camera/img/calib_report_laptop_attempt1.png
