karthiksing05/robot-as-a-verifier/system-1/sim/docs/img/stage_1_survey.jpg

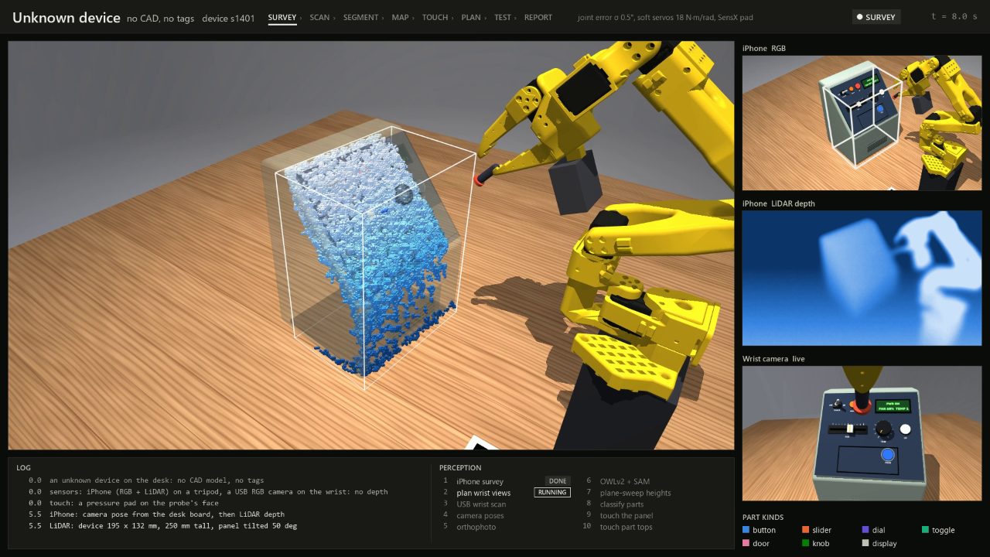
system-1/sim/docs/img/stage_1_survey.jpg
