karthiksing05/robot-as-a-verifier/system-2/fixtures/sample_run/sample-sim/scene/tex/2.jpg

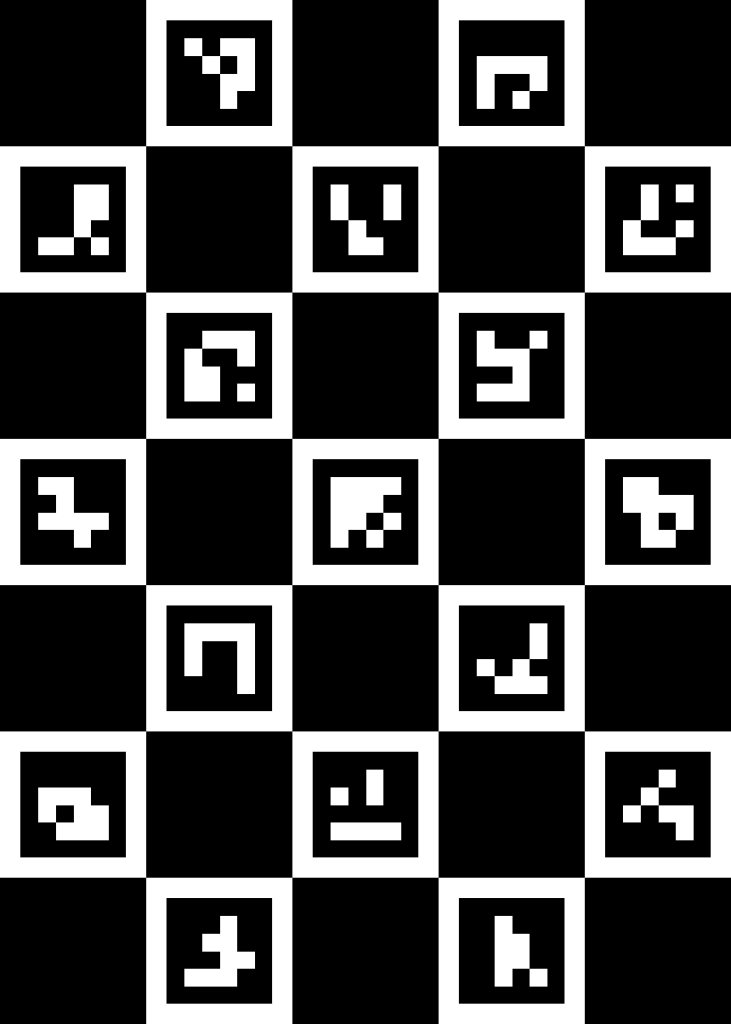
system-2/fixtures/sample_run/sample-sim/scene/tex/2.jpg
