karthiksing05/robot-as-a-verifier/system-2/subjects/appliance/preview.jpg

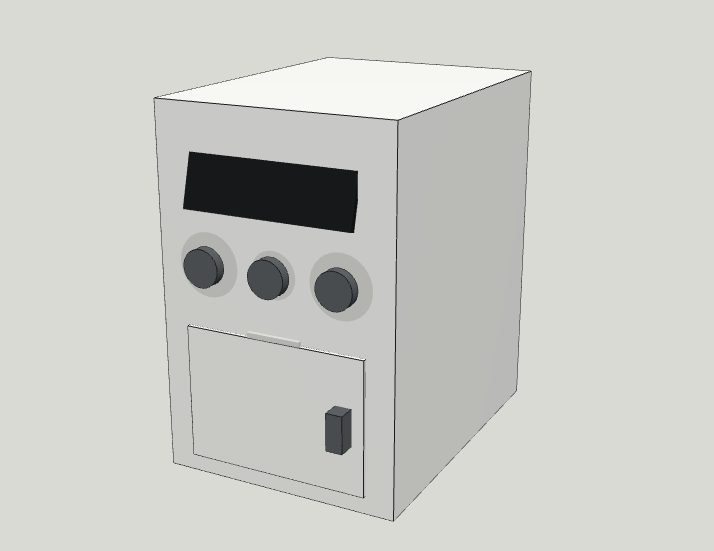
system-2/subjects/appliance/preview.jpg
