karthiksing05/robot-as-a-verifier/system-2/subjects/centrifuge/preview.jpg

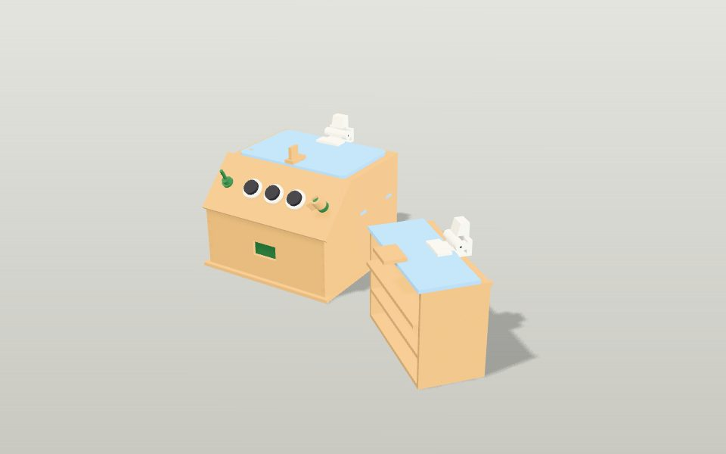
system-2/subjects/centrifuge/preview.jpg
