karthiksing05/robot-as-a-verifier/system-2/subjects/coffee-grinder/preview.jpg

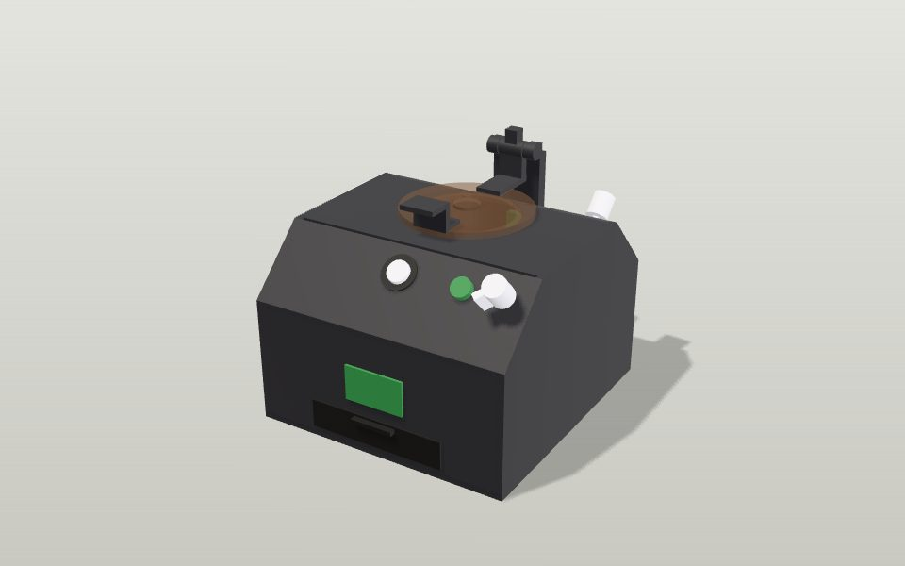
system-2/subjects/coffee-grinder/preview.jpg
