karthiksing05/robot-as-a-verifier/system-2/subjects/cuvette-reader/preview.jpg

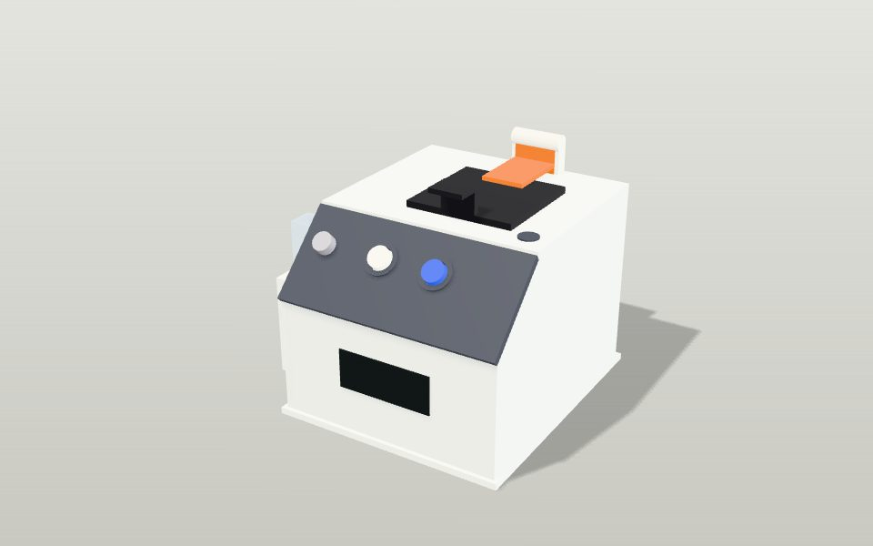
system-2/subjects/cuvette-reader/preview.jpg
