karthiksing05/robot-as-a-verifier/system-2/subjects/hotplate-stirrer/preview.jpg

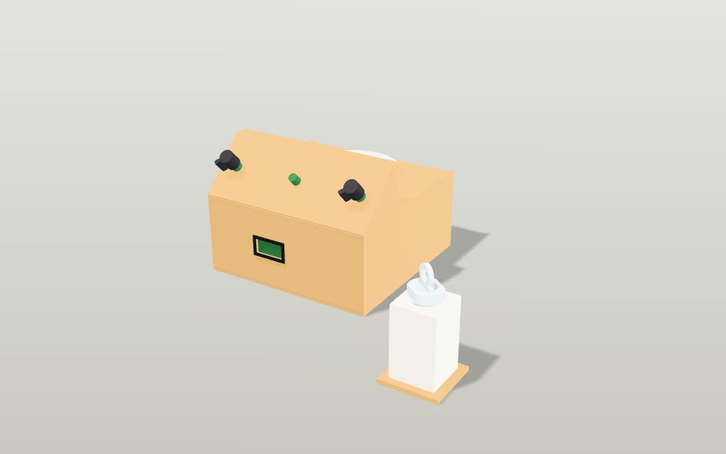
system-2/subjects/hotplate-stirrer/preview.jpg
