karthiksing05/robot-as-a-verifier/system-2/subjects/incubator/preview.jpg

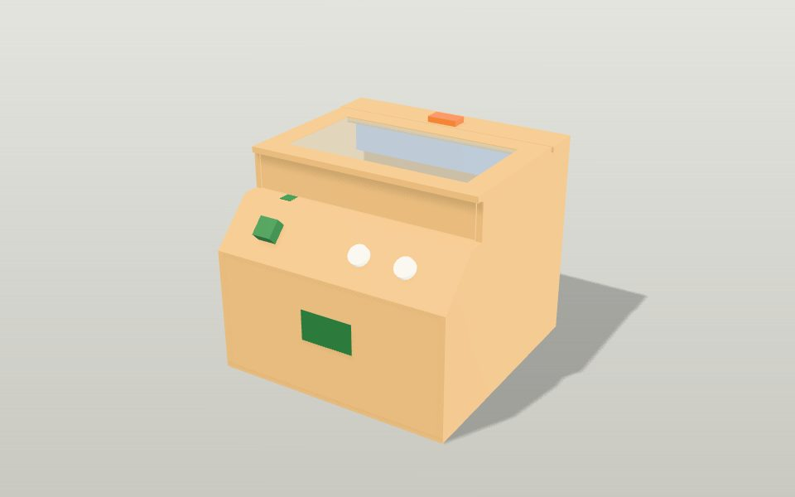
system-2/subjects/incubator/preview.jpg
