karthiksing05/robot-as-a-verifier/system-2/subjects/interval-timer/preview.jpg

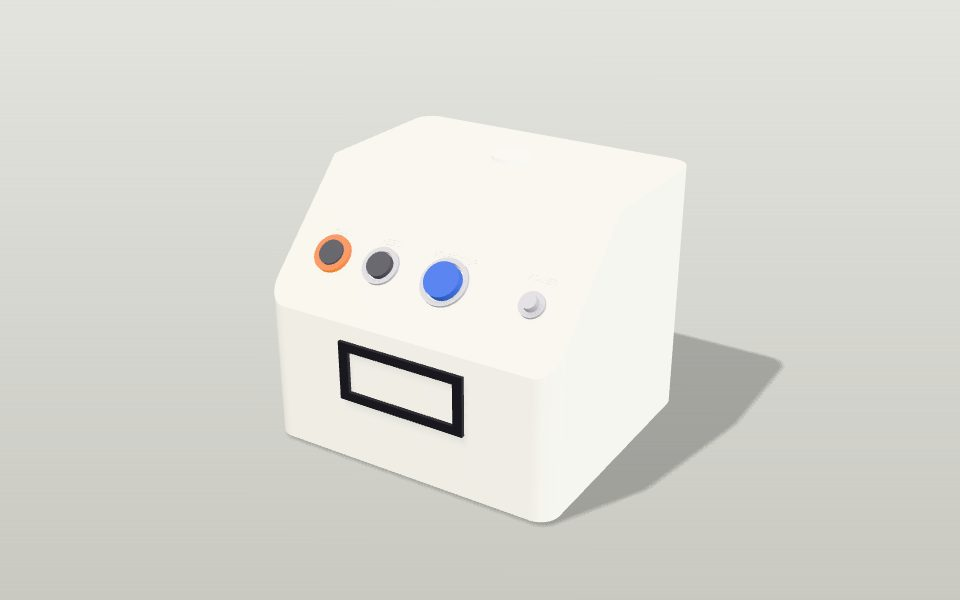
system-2/subjects/interval-timer/preview.jpg
