karthiksing05/robot-as-a-verifier/system-2/subjects/kettle-base/preview.jpg

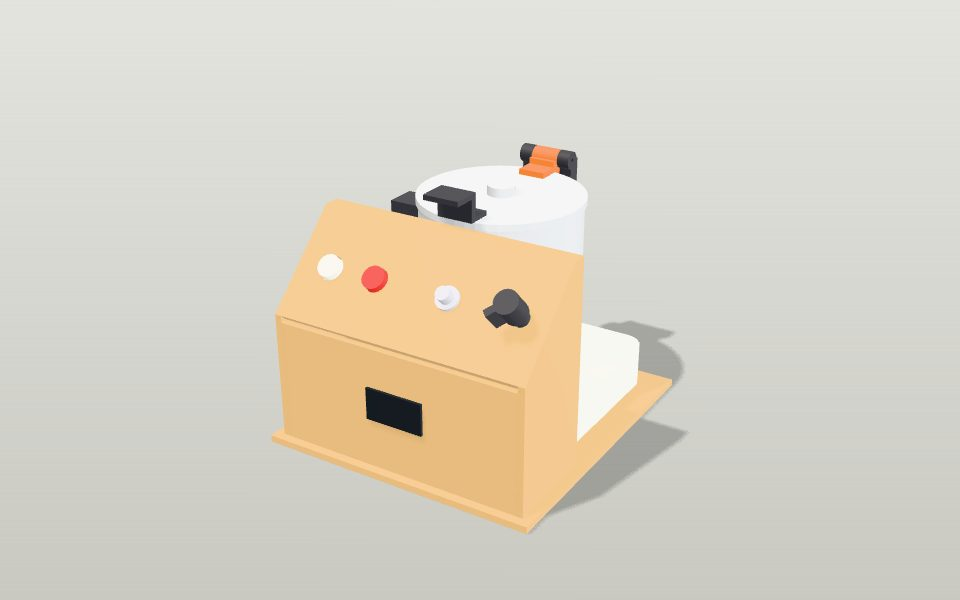
system-2/subjects/kettle-base/preview.jpg
