karthiksing05/robot-as-a-verifier/system-2/subjects/microwave/preview.jpg

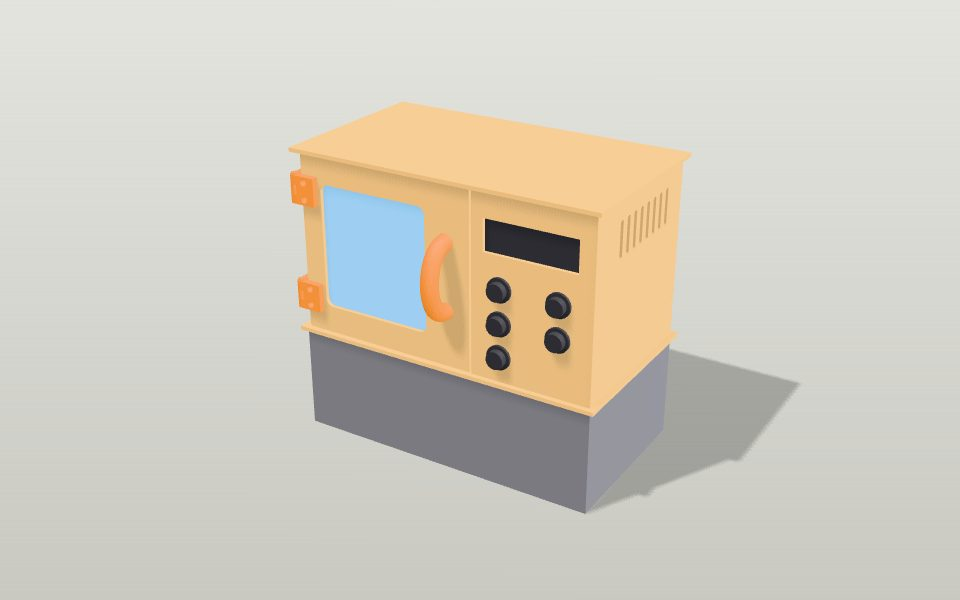
system-2/subjects/microwave/preview.jpg
