karthiksing05/robot-as-a-verifier/system-2/subjects/sim-preset-c/preview.jpg

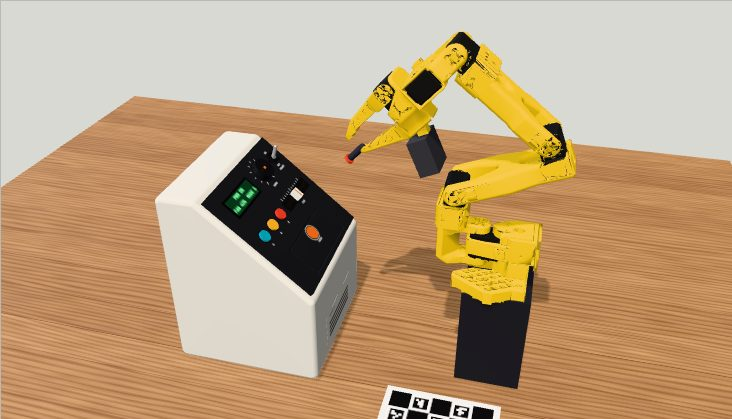
system-2/subjects/sim-preset-c/preview.jpg
