karthiksing05/robot-as-a-verifier/system-2/subjects/tube-sealer/preview.jpg

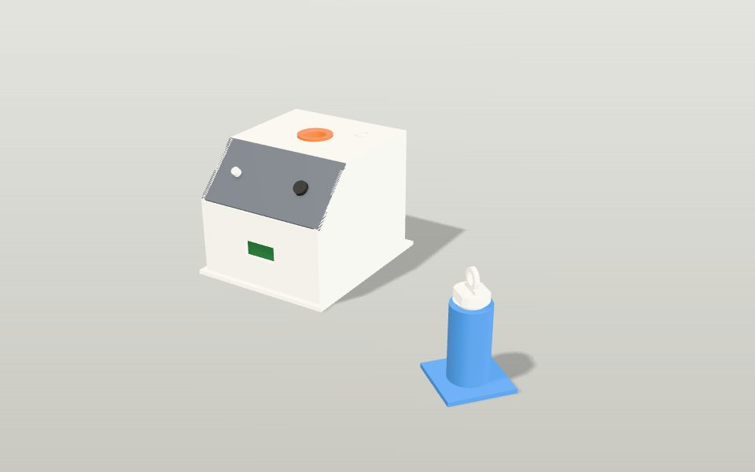
system-2/subjects/tube-sealer/preview.jpg
