karthiksing05/robot-as-a-verifier/system-2/subjects/vortex-mixer/preview.jpg

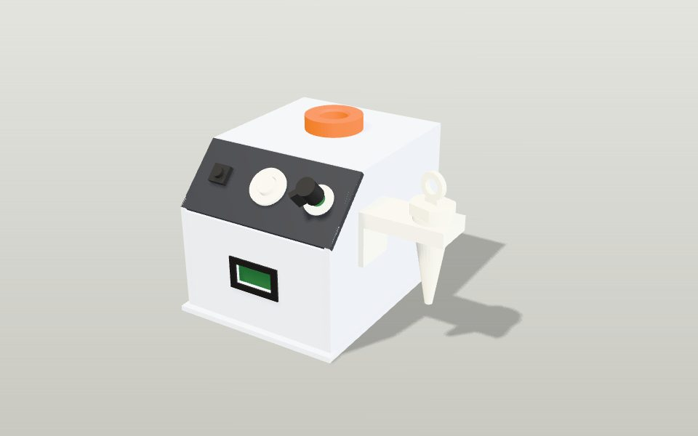
system-2/subjects/vortex-mixer/preview.jpg
