karthiksing05/robot-as-a-verifier/system-2/subjects/wall-thermostat/preview.jpg

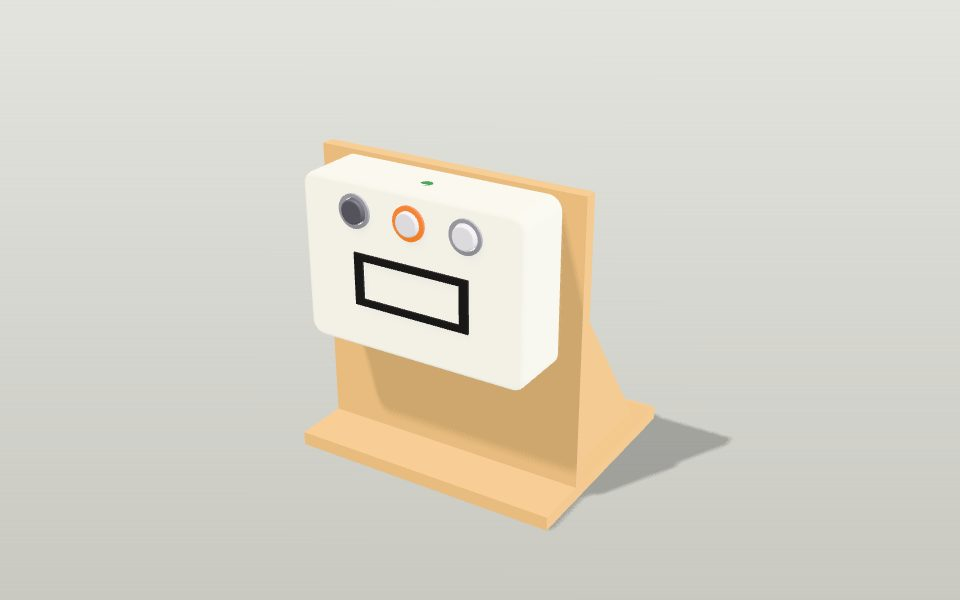
system-2/subjects/wall-thermostat/preview.jpg
