karthiksing05/robot-as-a-verifier/appliances/centrifuge/source/laser/1_single_parts_nominal/acrylic_3mm_clear/centrifuge/rotor_plate.dxf

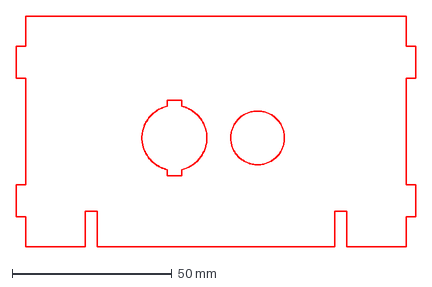
[picture p60: CAD file, 2026-11-08]
appliances/centrifuge/source/laser/1_single_parts_nominal/acrylic_3mm_clear/centrifuge/rotor_plate.dxf
125.0 x 72.0 mm
