karthiksing05/robot-as-a-verifier/appliances/centrifuge/source/laser/1_single_parts_nominal/acrylic_3mm_clear/tube_rack/rack_cover.dxf

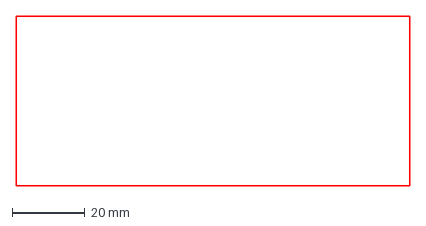
[picture p61: CAD file, 2026-11-08]
appliances/centrifuge/source/laser/1_single_parts_nominal/acrylic_3mm_clear/tube_rack/rack_cover.dxf
108.0 x 46.5 mm
