karthiksing05/robot-as-a-verifier/appliances/centrifuge/source/laser/1_single_parts_nominal/plywood_3mm/centrifuge/gusset_R.dxf

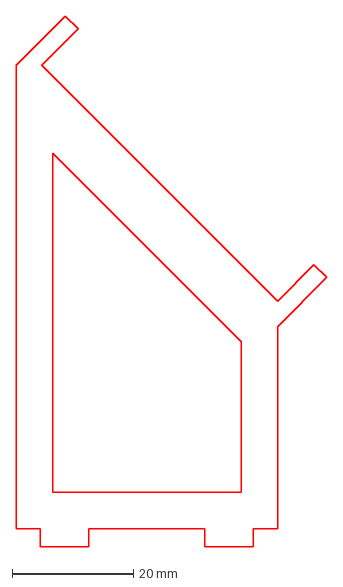
[picture p62: CAD file, 2026-11-08]
appliances/centrifuge/source/laser/1_single_parts_nominal/plywood_3mm/centrifuge/gusset_R.dxf
51.3 x 87.6 mm
