karthiksing05/robot-as-a-verifier/appliances/centrifuge/source/laser/1_single_parts_nominal/plywood_3mm/tube_rack/rack_middle.dxf

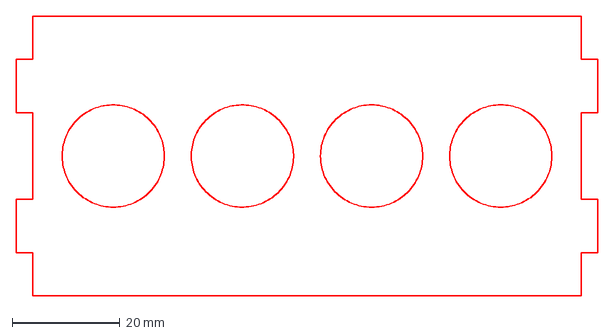
[picture p63: CAD file, 2026-11-08]
appliances/centrifuge/source/laser/1_single_parts_nominal/plywood_3mm/tube_rack/rack_middle.dxf
108.0 x 52.0 mm
