karthiksing05/robot-as-a-verifier/appliances/centrifuge/source/laser/2_nested_sheets_kerf_applied/plywood_3mm_sheet1_600x300.dxf

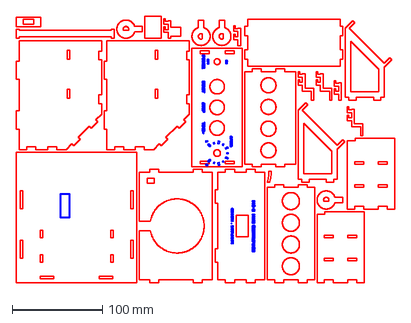
[picture p64: CAD file, 2026-11-08]
appliances/centrifuge/source/laser/2_nested_sheets_kerf_applied/plywood_3mm_sheet1_600x300.dxf
417.9 x 294.1 mm
