karthiksing05/robot-as-a-verifier/appliances/centrifuge/source/print/tube__x2.stl

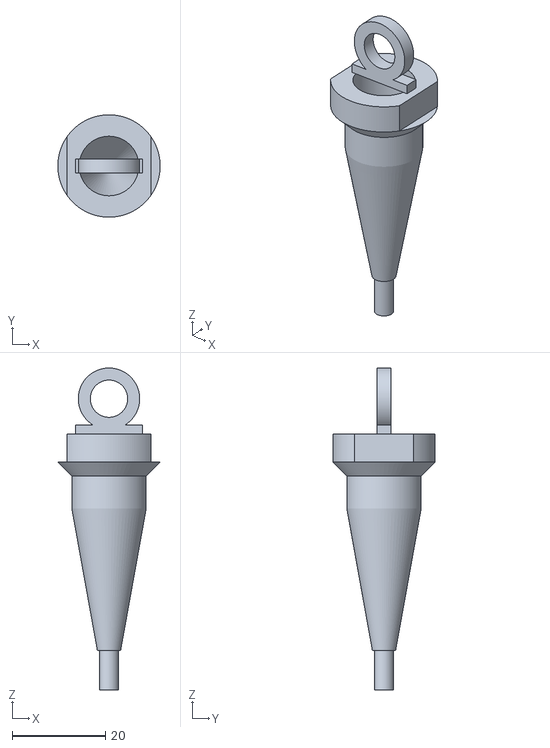
[picture p65: CAD file, 2026-11-08]
appliances/centrifuge/source/print/tube__x2.stl
22.0 x 22.0 x 69.2
