karthiksing05/robot-as-a-verifier/appliances/microwave/source/laser/1_single_parts_nominal/acrylic_3mm_clear/door_window.dxf

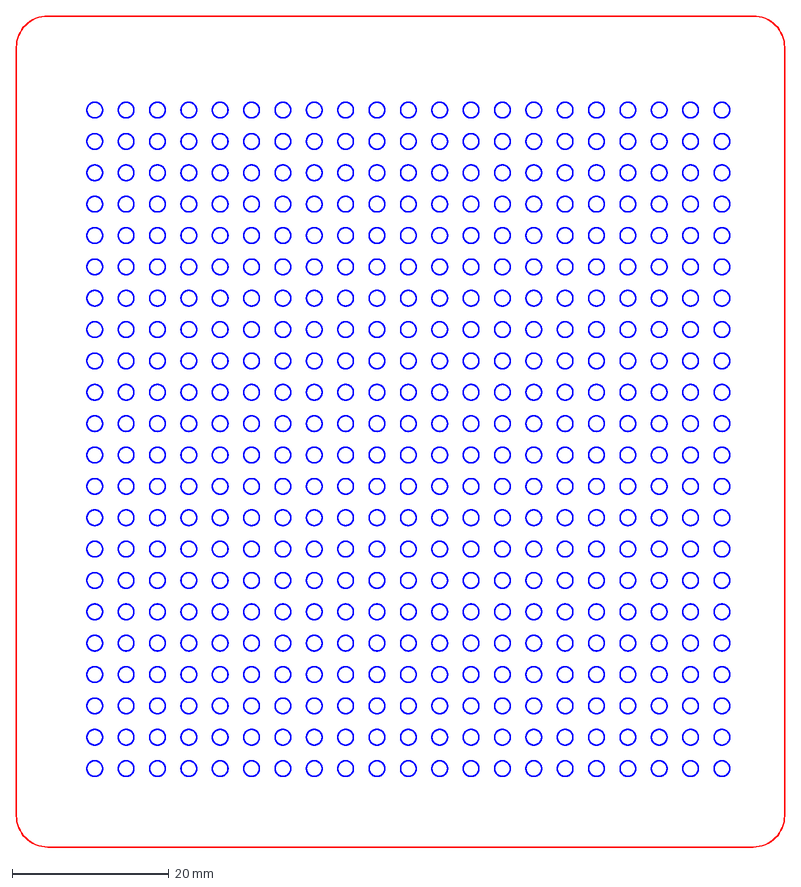
[picture p66: CAD file, 2026-11-08]
appliances/microwave/source/laser/1_single_parts_nominal/acrylic_3mm_clear/door_window.dxf
98.0 x 106.0 mm
