karthiksing05/robot-as-a-verifier/appliances/microwave/source/laser/1_single_parts_nominal/plywood_3mm/back.dxf

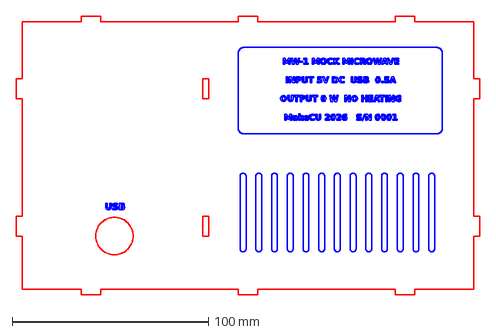
[picture p67: CAD file, 2026-11-08]
appliances/microwave/source/laser/1_single_parts_nominal/plywood_3mm/back.dxf
236.0 x 142.0 mm
