karthiksing05/robot-as-a-verifier/appliances/microwave/source/laser/2_nested_sheets_kerf_applied/plywood_3mm_sheet2_600x300.dxf

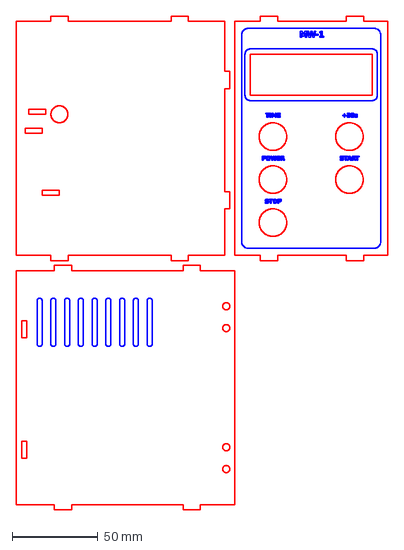
[picture p68: CAD file, 2026-11-08]
appliances/microwave/source/laser/2_nested_sheets_kerf_applied/plywood_3mm_sheet2_600x300.dxf
216.0 x 287.1 mm
