karthiksing05/robot-as-a-verifier/appliances/microwave/source/print/handle.stl

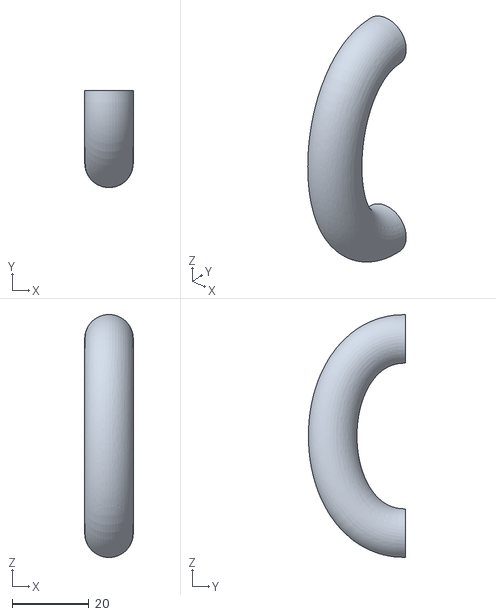
[picture p69: CAD file, 2026-11-08]
appliances/microwave/source/print/handle.stl
12.7 x 25.4 x 63.5
