karthiksing05/robot-as-a-verifier/appliances/microwave/source/step/originals_onshape/Frame.step

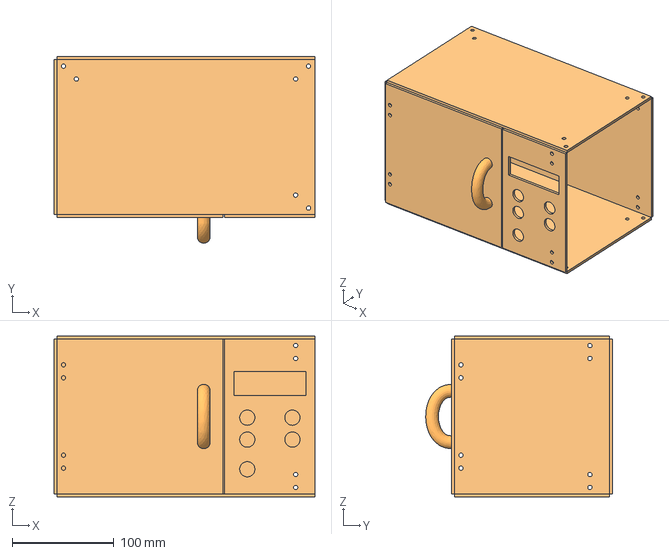
[picture p70: CAD file, 2026-11-08]
appliances/microwave/source/step/originals_onshape/Frame.step
257.0 x 183.8 x 158.4 mm
