karthiksing05/robot-as-a-verifier/system-1/sim/assets/so101/assets/moving_jaw_so101_v1.stl

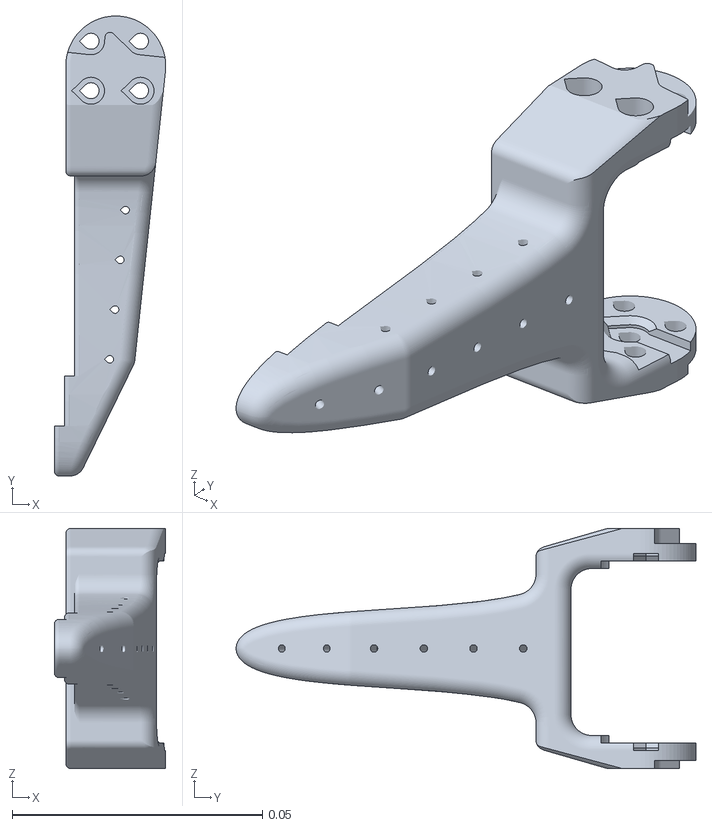
[picture p71: CAD file, 2026-11-07]
system-1/sim/assets/so101/assets/moving_jaw_so101_v1.stl
0.0223 x 0.092 x 0.048
