karthiksing05/robot-as-a-verifier/system-1/sim/assets/so101/jaw_pieces/moving_jaw_so101_v1__c0.stl

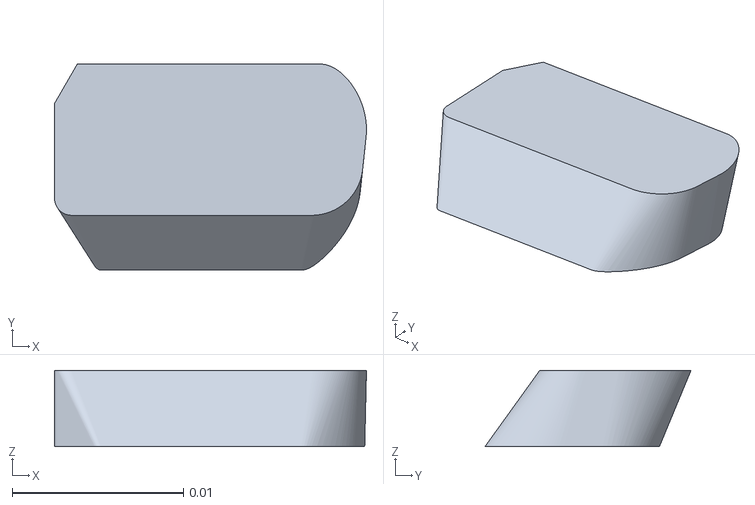
[picture p72: CAD file, 2026-11-08]
system-1/sim/assets/so101/jaw_pieces/moving_jaw_so101_v1__c0.stl
0.0182 x 0.012 x 0.00445
