karthiksing05/robot-as-a-verifier/system-2/subjects/centrifuge/revA.step

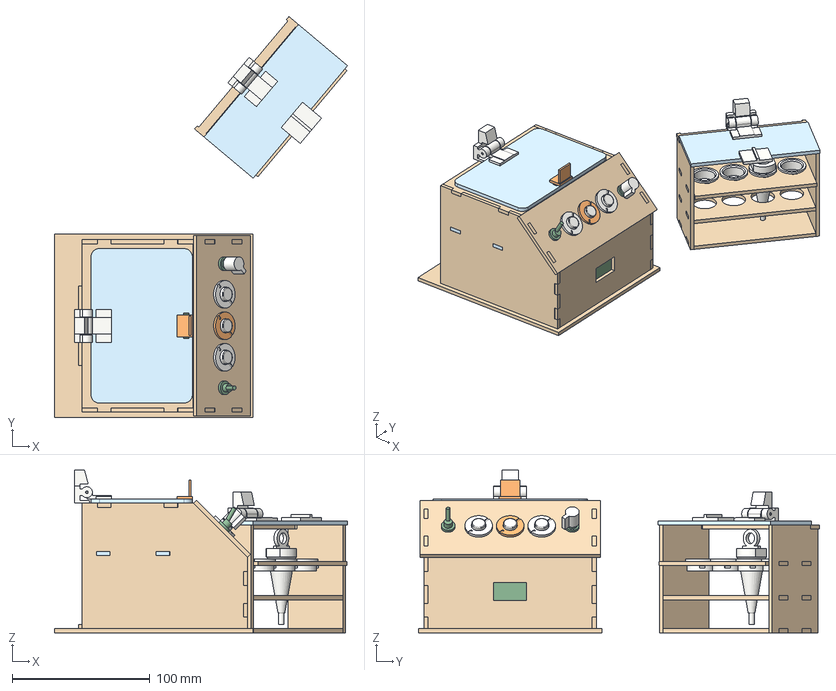
[picture p73: CAD file, 2026-11-08]
system-2/subjects/centrifuge/revA.step
212.5 x 290.8 x 118.0 mm
cap_start
front_panel
well_insert_B
gusset_R
rack_top
control_face
well_insert_A_revA
rack_end_L
side_panel_L
pico_frame
bezel_start
rack_hinge_base
base_plate
lid_sensor_cradle
side_panel_R
rack_insert_4
lid_hinge_leaf
rack_cover
rack_insert_1
top_panel
tube_2
rack_middle
lid_hinge_pin
tube_sensor_stand
bezel_time
lid_hinge_base
cap_time
rotor_plate
rack_end_R
bezel_stop_revA
dial_knob
gusset_L
rack_back_strip
lid_handle_revA
lid
cap_stop
rack_base
lid_sensor_tab
ref_switch_stop
ref_moc_tube
ref_ring
ref_breadboard
ref_switch_start
ref_moc_lid
ref_pot
ref_pico
ref_switch_time
ref_toggle
ref_oled
tube_1
rack_insert_2
rack_cover_lip
rack_insert_3
rack_hinge_pin
rack_hinge_leaf
