karthiksing05/robot-as-a-verifier/appliances/centrifuge/source/laser/1_single_parts_nominal/acrylic_3mm_clear/centrifuge/lid.dxf

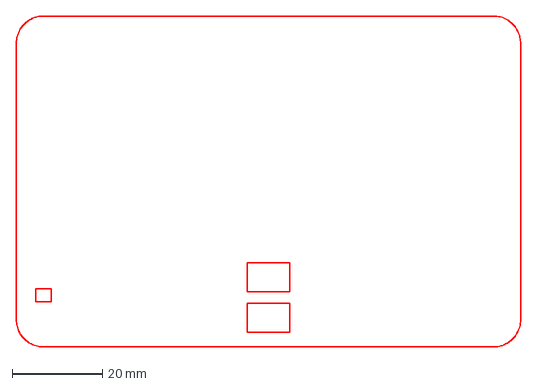
[picture p74: CAD file, 2026-11-08]
appliances/centrifuge/source/laser/1_single_parts_nominal/acrylic_3mm_clear/centrifuge/lid.dxf
112.0 x 73.5 mm
