karthiksing05/robot-as-a-verifier/appliances/centrifuge/source/laser/1_single_parts_nominal/plywood_3mm/centrifuge/base_plate.dxf

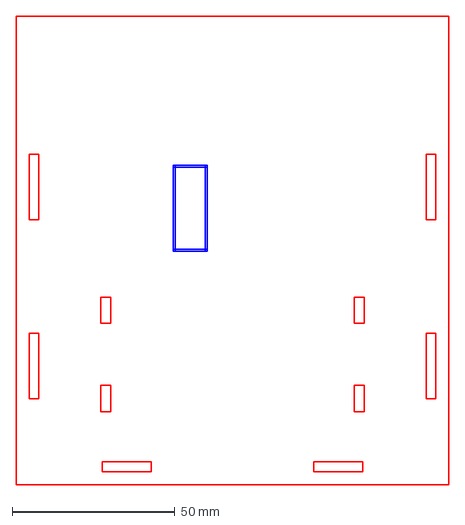
[picture p75: CAD file, 2026-11-08]
appliances/centrifuge/source/laser/1_single_parts_nominal/plywood_3mm/centrifuge/base_plate.dxf
133.0 x 144.0 mm
