karthiksing05/robot-as-a-verifier/appliances/centrifuge/source/laser/1_single_parts_nominal/plywood_3mm/tube_rack/rack_cover_lip.dxf

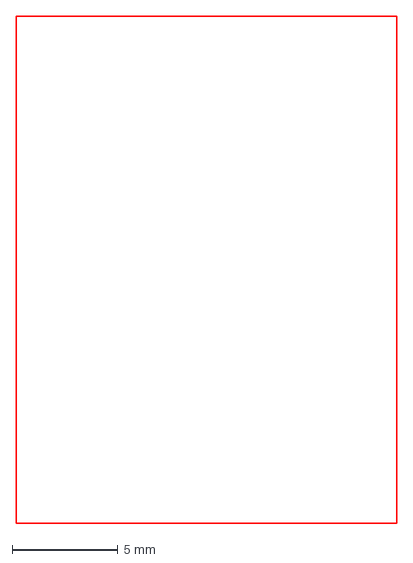
[picture p76: CAD file, 2026-11-08]
appliances/centrifuge/source/laser/1_single_parts_nominal/plywood_3mm/tube_rack/rack_cover_lip.dxf
18.0 x 24.0 mm
