karthiksing05/robot-as-a-verifier/appliances/centrifuge/source/laser/2_nested_sheets_kerf_applied/acrylic_3mm_clear_sheet1_600x300.dxf

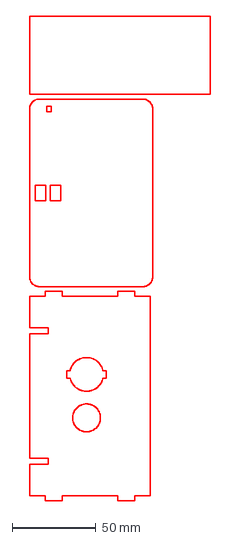
[picture p77: CAD file, 2026-11-08]
appliances/centrifuge/source/laser/2_nested_sheets_kerf_applied/acrylic_3mm_clear_sheet1_600x300.dxf
108.2 x 289.6 mm
