karthiksing05/robot-as-a-verifier/appliances/centrifuge/source/print/rack_hinge_base__x1.stl

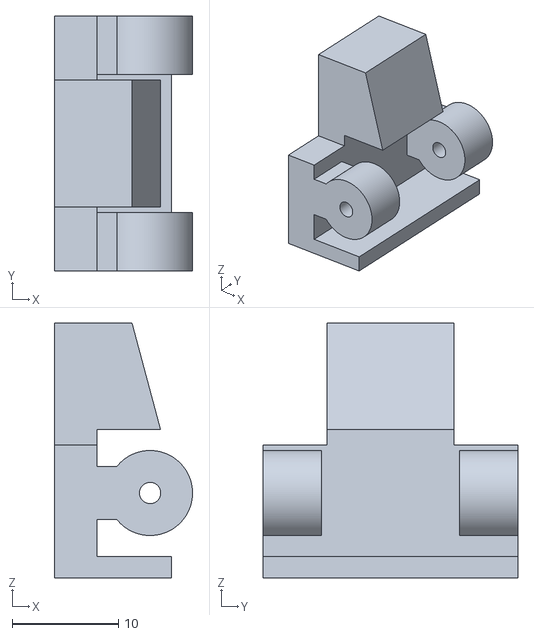
[picture p78: CAD file, 2026-11-08]
appliances/centrifuge/source/print/rack_hinge_base__x1.stl
13.0 x 24.0 x 24.0
