karthiksing05/robot-as-a-verifier/appliances/centrifuge/source/step/mc6_revB.step

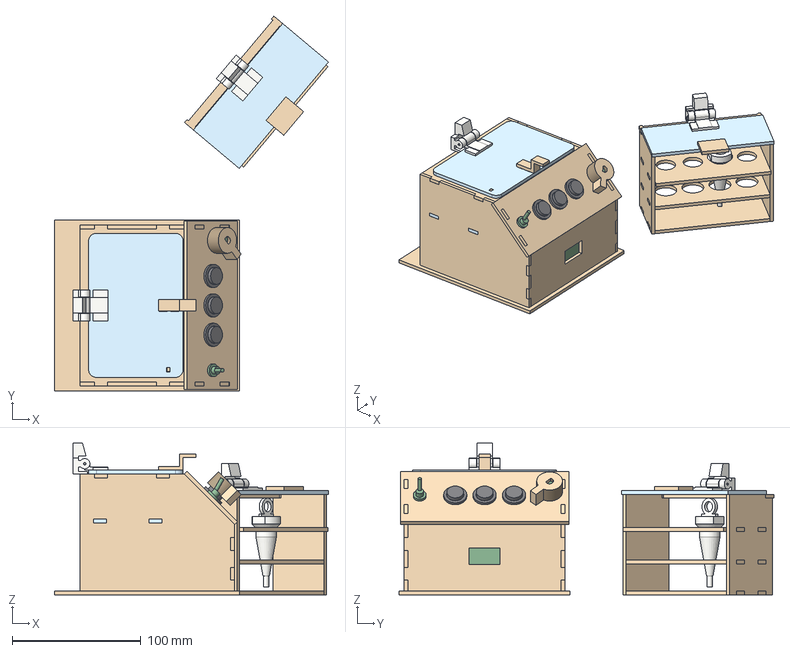
[picture p79: CAD file, 2026-11-08]
appliances/centrifuge/source/step/mc6_revB.step
213.0 x 291.4 x 118.0 mm
front_panel
control_face
top_panel
rotor_plate
side_panel_L
side_panel_R
base_plate
button_start
cap_start
button_stop
cap_stop
button_time
cap_time
dial_knob
well_insert_A_revB
lid_hinge_base
lid_hinge_pin
lid
lid_hinge_leaf
lid_handle_revB
lid_sensor_fin
tube_sensor_riser_1
gusset_L
gusset_R
tube_1_revB
tube_2
rack_base
rack_middle
rack_top
rack_back_strip
rack_end_L
rack_end_R
rack_cover
rack_hinge_base
rack_hinge_leaf
rack_hinge_pin
rack_cover_lip
ref_toggle
ref_toggle_lever
ref_pot
ref_oled
ref_ring
ref_light_lid
ref_light_tube
