karthiksing05/robot-as-a-verifier/appliances/microwave/source/laser/1_single_parts_nominal/plywood_3mm/sensor_shelf.dxf

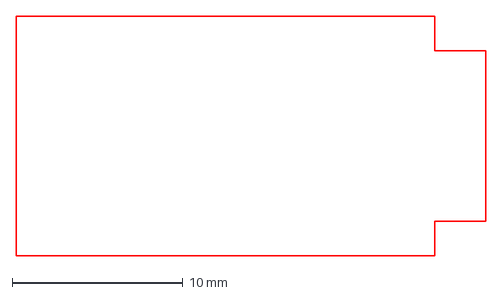
[picture p80: CAD file, 2026-11-08]
appliances/microwave/source/laser/1_single_parts_nominal/plywood_3mm/sensor_shelf.dxf
27.5 x 14.0 mm
