karthiksing05/robot-as-a-verifier/appliances/microwave/source/laser/2_nested_sheets_kerf_applied/plywood_3mm_sheet1_600x300.dxf

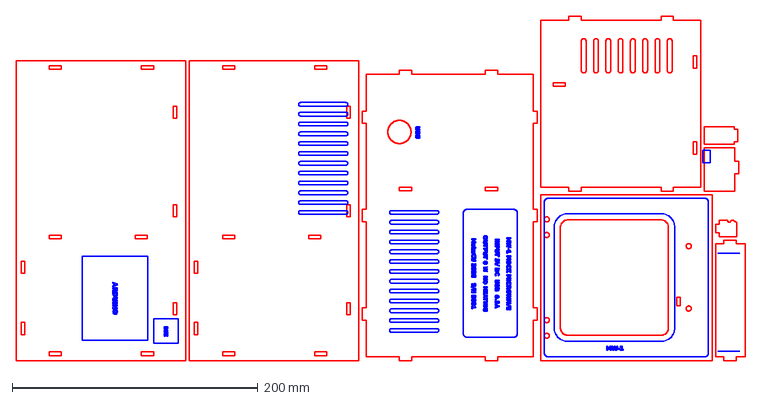
[picture p81: CAD file, 2026-11-08]
appliances/microwave/source/laser/2_nested_sheets_kerf_applied/plywood_3mm_sheet1_600x300.dxf
593.4 x 280.1 mm
