karthiksing05/robot-as-a-verifier/appliances/microwave/source/step/mw1_revB.step

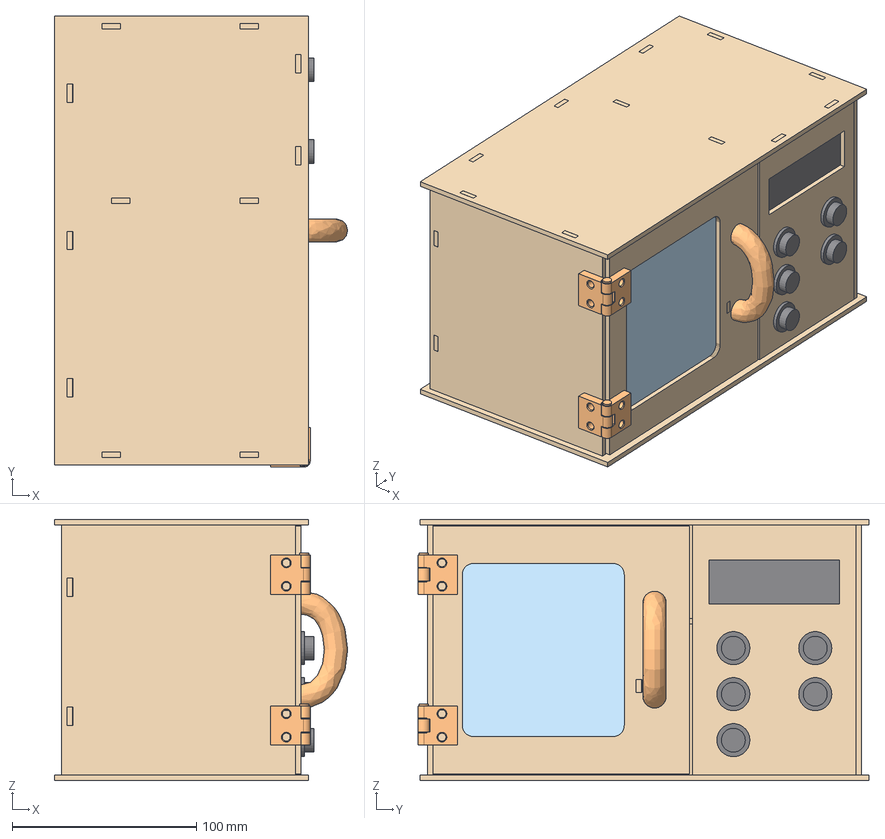
[picture p82: CAD file, 2026-11-08]
appliances/microwave/source/step/mw1_revB.step
159.4 x 245.1 x 142.0 mm
side_L
side_R
back
divider
control_panel
lcd_shelf
base
top
sensor_shelf
catch_shelf
door
door_window
door_strike
hinge1_wall_leaf_revB
hinge1_door_leaf_revB
hinge1_pin_revB
hinge2_wall_leaf_revB
hinge2_door_leaf_revB
hinge2_pin_revB
handle
door_catch
ref_lcd_grove
ref_button_TIME
ref_cap_TIME
ref_nut_TIME
ref_button_POWER
ref_cap_POWER
ref_nut_POWER
ref_button_STOP
ref_cap_STOP
ref_nut_STOP
ref_button_+30s
ref_cap_+30s
ref_nut_+30s
ref_button_START
ref_cap_START
ref_nut_START
ref_light_door
ref_arduino
ref_buzzer
