karthiksing05/robot-as-a-verifier/appliances/microwave/source/step/originals_onshape/Hinge.step

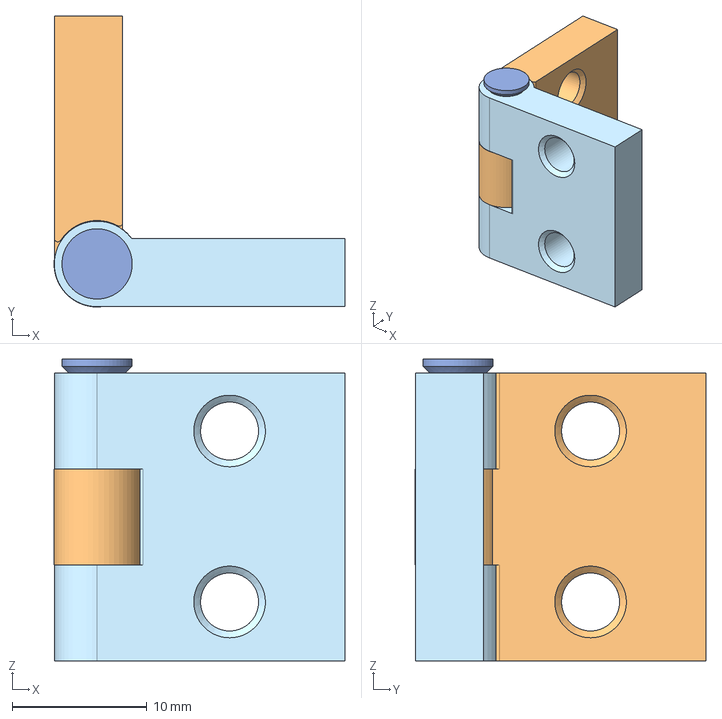
[picture p83: CAD file, 2026-11-08]
appliances/microwave/source/step/originals_onshape/Hinge.step
21.6 x 21.6 x 22.4 mm
