karthiksing05/robot-as-a-verifier/system-1/sim/assets/so101/jaw_pieces/wrist_roll_follower_so101_v1__c7.stl

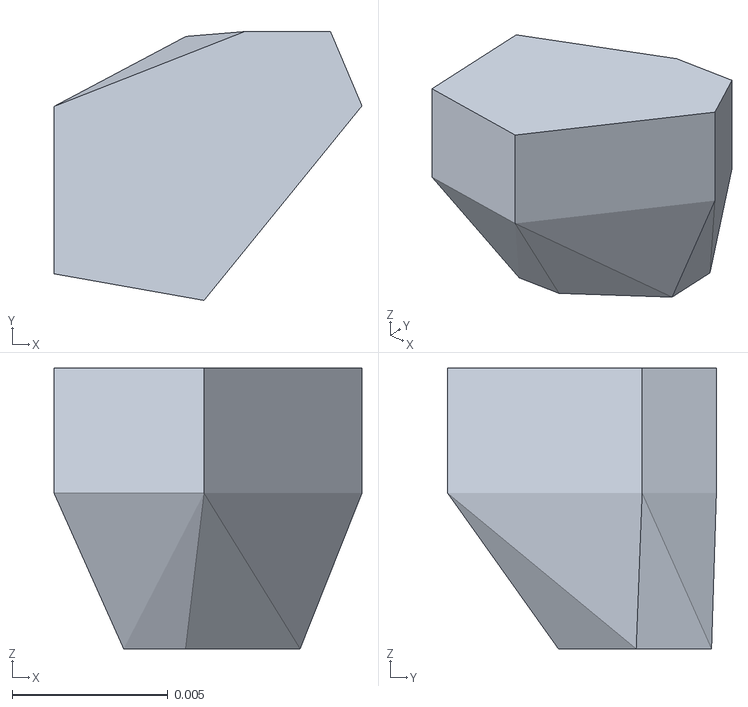
[picture p85: CAD file, 2026-11-08]
system-1/sim/assets/so101/jaw_pieces/wrist_roll_follower_so101_v1__c7.stl
0.00988 x 0.00862 x 0.009
