karthiksing05/robot-as-a-verifier/appliances/centrifuge/source/laser/1_single_parts_nominal/plywood_3mm/centrifuge/control_face.dxf

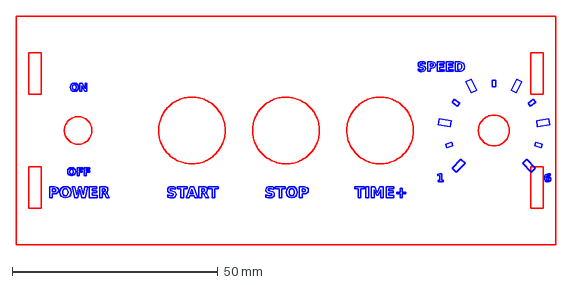
[picture p86: CAD file, 2026-11-08]
appliances/centrifuge/source/laser/1_single_parts_nominal/plywood_3mm/centrifuge/control_face.dxf
131.0 x 55.5 mm
