karthiksing05/robot-as-a-verifier/appliances/centrifuge/source/print/well_insert_A_revB.stl

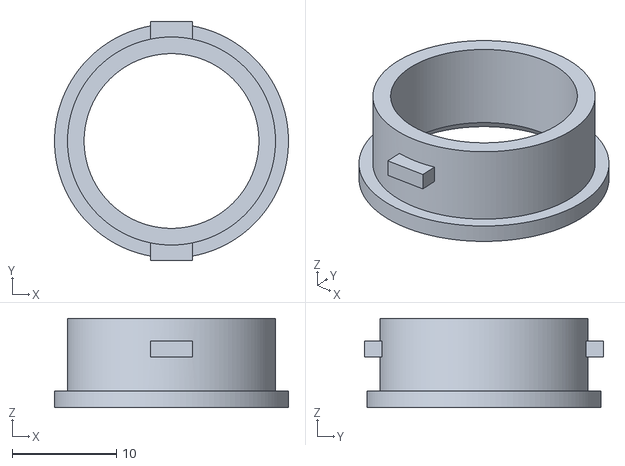
[picture p88: CAD file, 2026-11-08]
appliances/centrifuge/source/print/well_insert_A_revB.stl
22.5 x 23.0 x 8.60
