karthiksing05/robot-as-a-verifier/appliances/microwave/source/laser/1_single_parts_nominal/plywood_3mm/catch_shelf.dxf

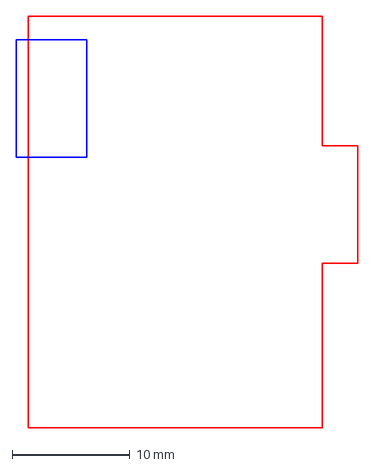
[picture p89: CAD file, 2026-11-08]
appliances/microwave/source/laser/1_single_parts_nominal/plywood_3mm/catch_shelf.dxf
29.0 x 35.0 mm
