karthiksing05/robot-as-a-verifier/appliances/microwave/source/laser/2_nested_sheets_kerf_applied/acrylic_3mm_clear_sheet1_600x300.dxf

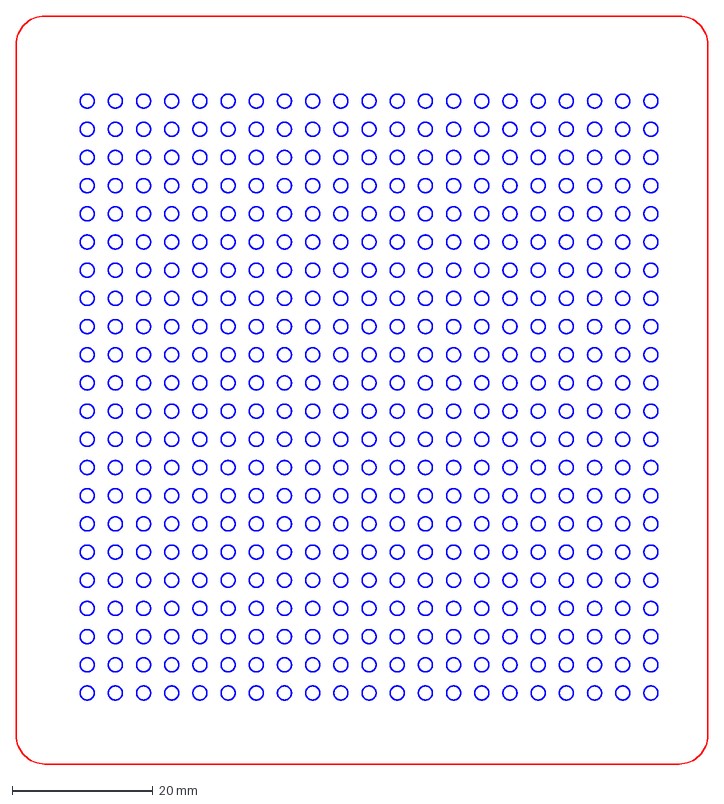
[picture p90: CAD file, 2026-11-08]
appliances/microwave/source/laser/2_nested_sheets_kerf_applied/acrylic_3mm_clear_sheet1_600x300.dxf
98.2 x 106.2 mm
