karthiksing05/robot-as-a-verifier/appliances/microwave/source/print/hinge_wall_leaf_revB__x2.stl

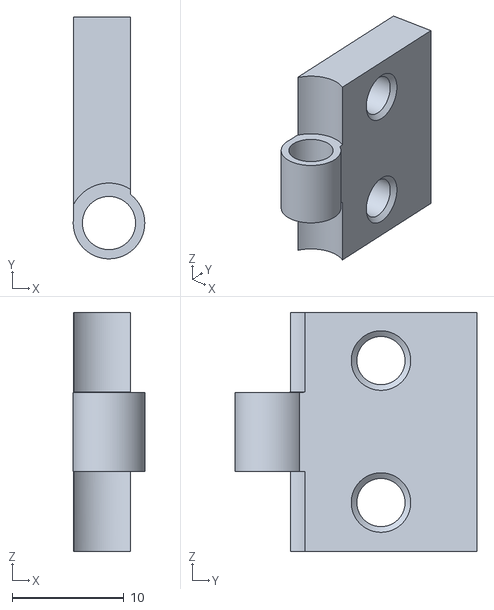
[picture p91: CAD file, 2026-11-08]
appliances/microwave/source/print/hinge_wall_leaf_revB__x2.stl
6.40 x 21.6 x 21.4
