karthiksing05/robot-as-a-verifier/system-1/sim/assets/so101/assets/wrist_roll_follower_so101_v1.stl

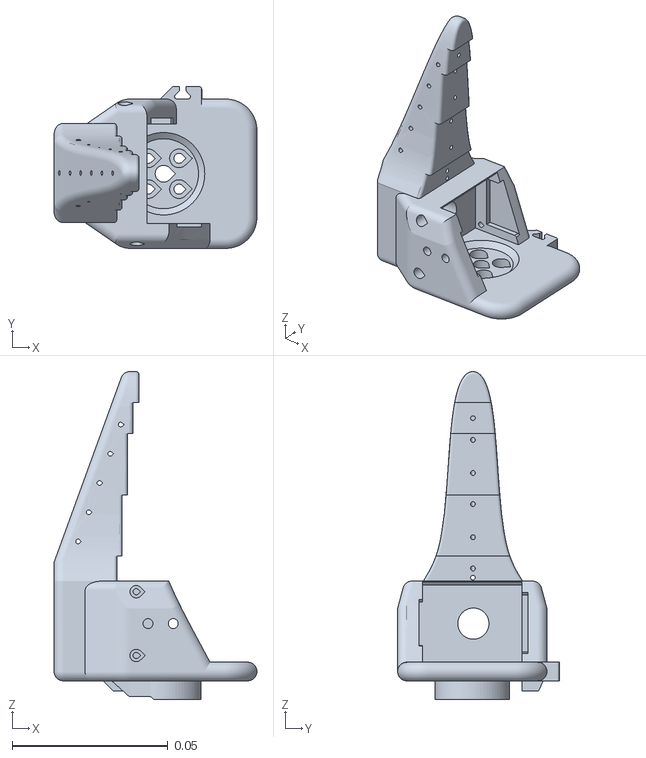
[picture p92: CAD file, 2026-11-07]
system-1/sim/assets/so101/assets/wrist_roll_follower_so101_v1.stl
0.0652 x 0.052 x 0.105
