karthiksing05/robot-as-a-verifier/system-1/sim/assets/so101/jaw_pieces/moving_jaw_so101_v1__c21.stl

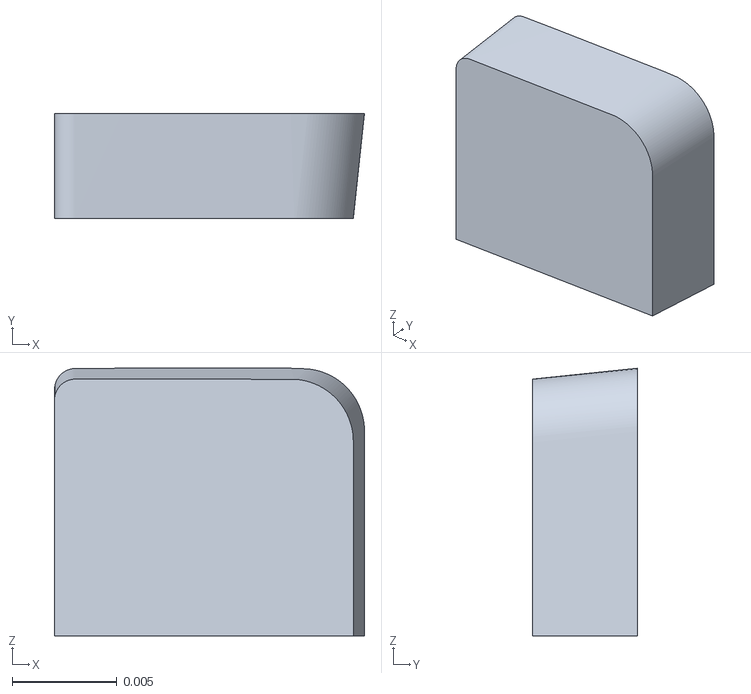
[picture p93: CAD file, 2026-11-08]
system-1/sim/assets/so101/jaw_pieces/moving_jaw_so101_v1__c21.stl
0.0148 x 0.00502 x 0.0128
