karthiksing05/robot-as-a-verifier/appliances/centrifuge/source/laser/1_single_parts_nominal/plywood_3mm/centrifuge/side_panel_R.dxf

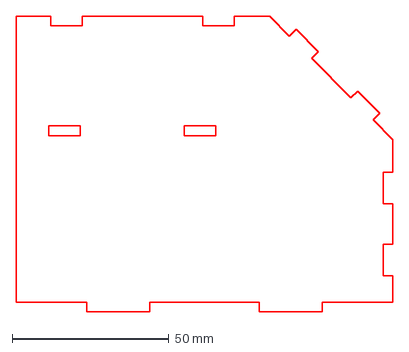
[picture p94: CAD file, 2026-11-08]
appliances/centrifuge/source/laser/1_single_parts_nominal/plywood_3mm/centrifuge/side_panel_R.dxf
120.0 x 94.0 mm
