karthiksing05/robot-as-a-verifier/appliances/microwave/source/laser/1_single_parts_nominal/plywood_3mm/base.dxf

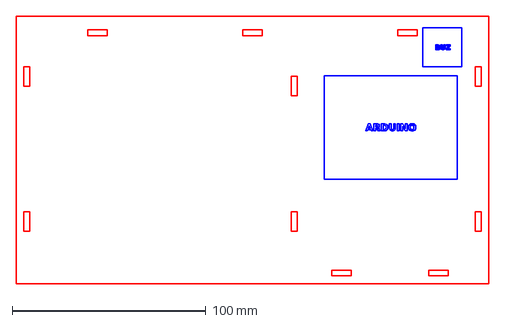
[picture p96: CAD file, 2026-11-08]
appliances/microwave/source/laser/1_single_parts_nominal/plywood_3mm/base.dxf
244.0 x 138.0 mm
