karthiksing05/robot-as-a-verifier/system-1/sim/assets/so101/assets/base_so101_v2.stl

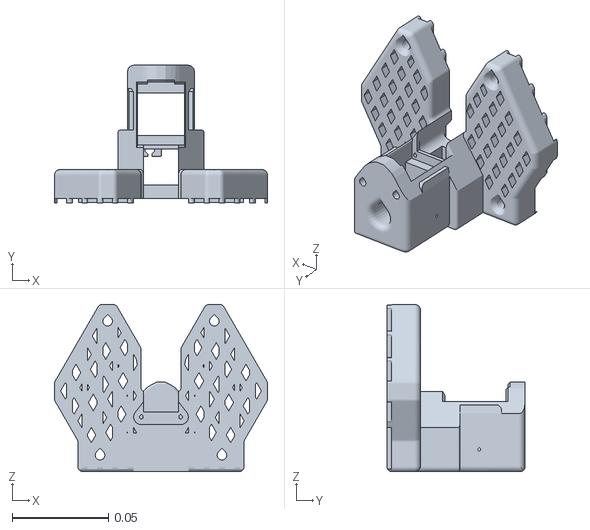
[picture p97: CAD file, 2026-11-07]
system-1/sim/assets/so101/assets/base_so101_v2.stl
0.111 x 0.072 x 0.087
