karthiksing05/robot-as-a-verifier/system-1/sim/assets/so101/jaw_pieces/wrist_roll_follower_so101_v1__c15.stl

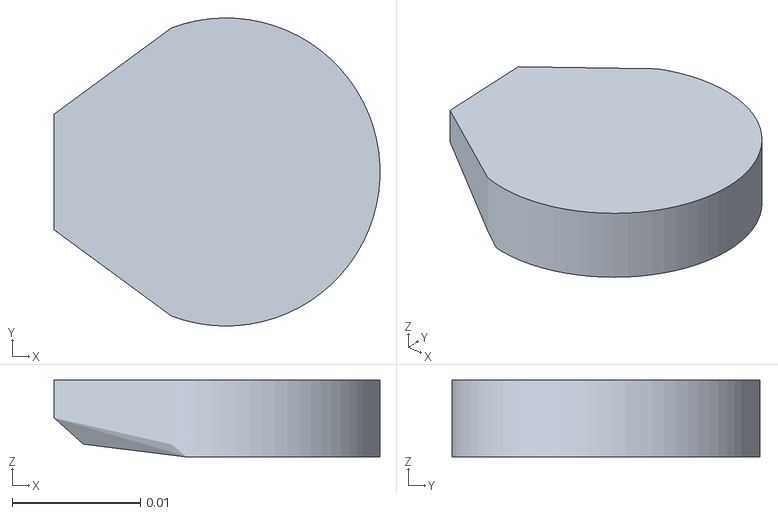
[picture p98: CAD file, 2026-11-08]
system-1/sim/assets/so101/jaw_pieces/wrist_roll_follower_so101_v1__c15.stl
0.0254 x 0.024 x 0.006
