karthiksing05/robot-as-a-verifier/appliances/centrifuge/source/laser/1_single_parts_nominal/plywood_3mm/centrifuge/lid_handle_revB_ply__x3.dxf

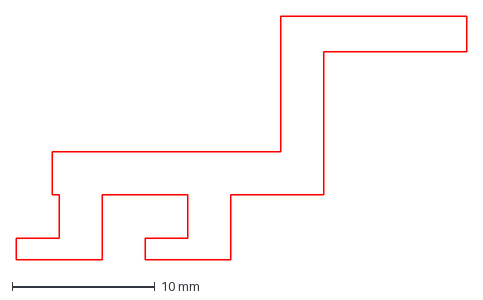
[picture p99: CAD file, 2026-11-08]
appliances/centrifuge/source/laser/1_single_parts_nominal/plywood_3mm/centrifuge/lid_handle_revB_ply__x3.dxf
31.5 x 17.1 mm
