karthiksing05/robot-as-a-verifier/appliances/centrifuge/source/laser/1_single_parts_nominal/plywood_3mm/tube_rack/rack_end_L.dxf

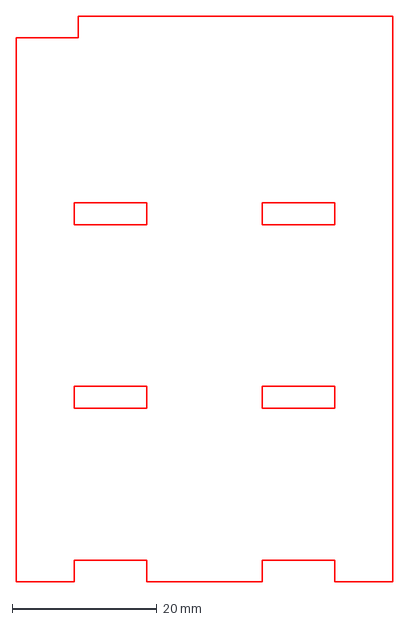
[picture p100: CAD file, 2026-11-08]
appliances/centrifuge/source/laser/1_single_parts_nominal/plywood_3mm/tube_rack/rack_end_L.dxf
52.0 x 78.2 mm
