karthiksing05/robot-as-a-verifier/appliances/centrifuge/source/print/lid_hinge_leaf__x1.stl

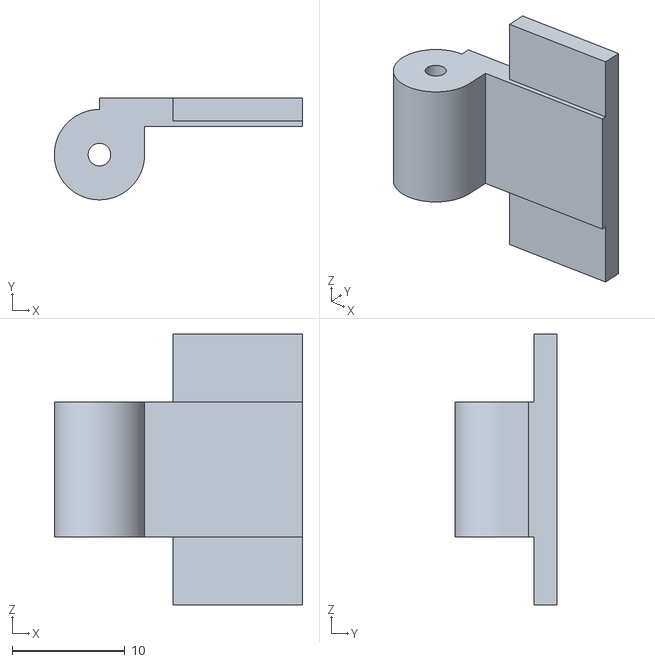
[picture p101: CAD file, 2026-11-08]
appliances/centrifuge/source/print/lid_hinge_leaf__x1.stl
22.0 x 9.00 x 24.0
