karthiksing05/robot-as-a-verifier/appliances/microwave/source/laser/1_single_parts_nominal/plywood_3mm/side_R.dxf

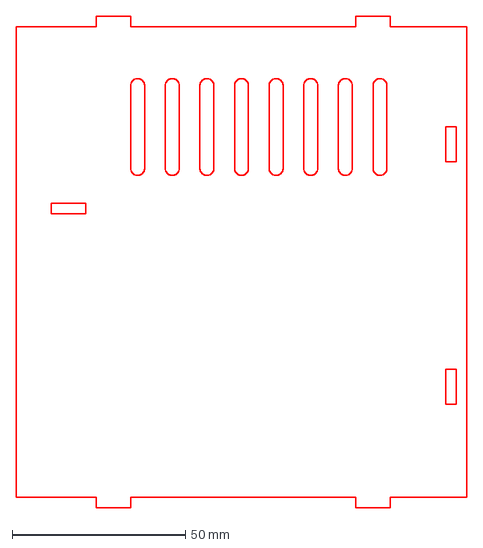
[picture p102: CAD file, 2026-11-08]
appliances/microwave/source/laser/1_single_parts_nominal/plywood_3mm/side_R.dxf
130.0 x 142.0 mm
