karthiksing05/robot-as-a-verifier/appliances/microwave/source/print/door_catch__print_on_its_side.stl

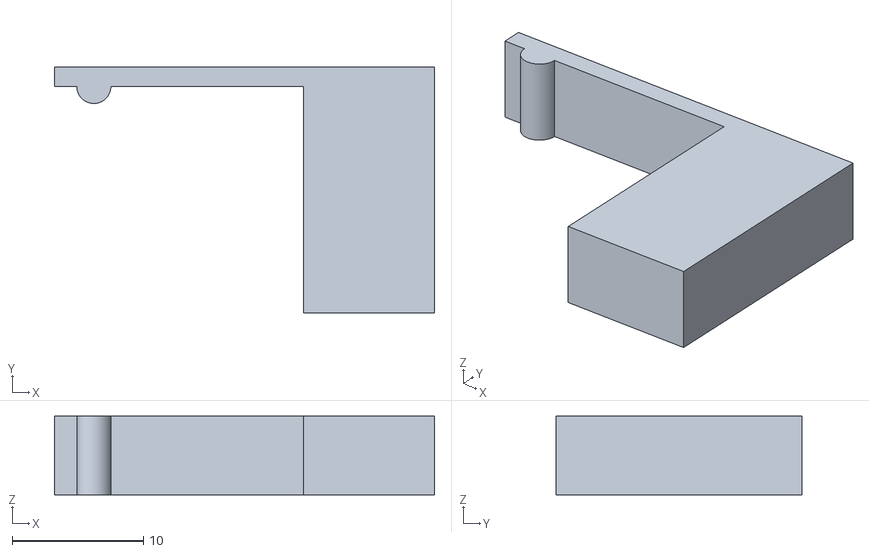
[picture p103: CAD file, 2026-11-08]
appliances/microwave/source/print/door_catch__print_on_its_side.stl
29.0 x 18.8 x 6.00
