karthiksing05/robot-as-a-verifier/system-1/sim/assets/so101/assets/base_motor_holder_so101_v1.stl

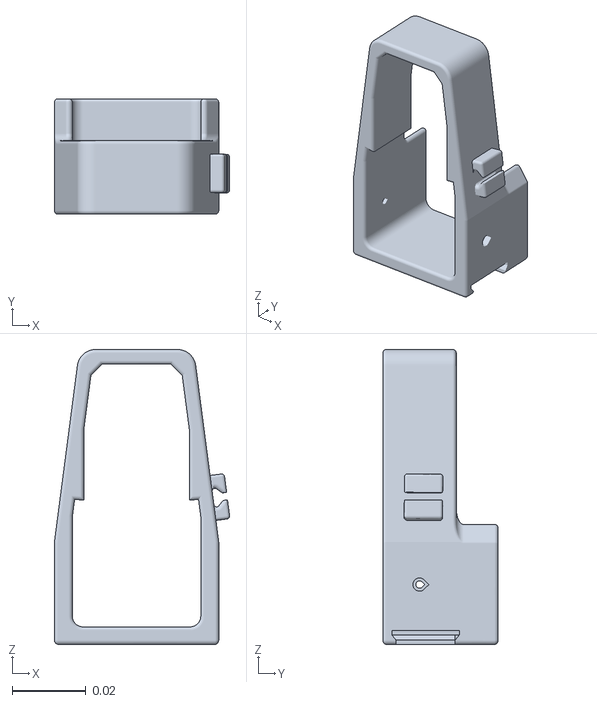
[picture p104: CAD file, 2026-11-07]
system-1/sim/assets/so101/assets/base_motor_holder_so101_v1.stl
0.0476 x 0.0314 x 0.0802
