karthiksing05/robot-as-a-verifier/system-1/sim/assets/so101/jaw_pieces/wrist_roll_follower_so101_v1__c0.stl

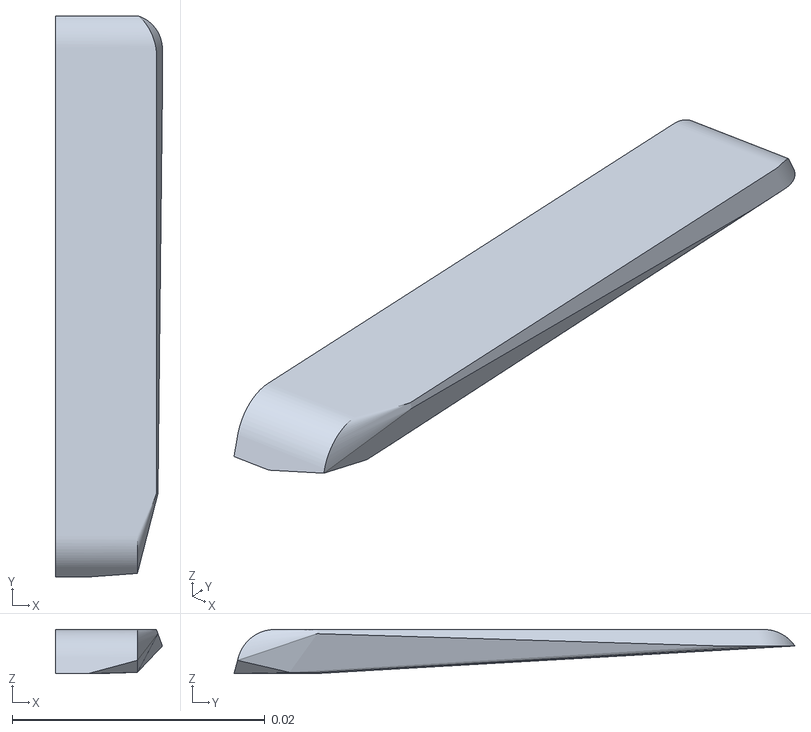
[picture p105: CAD file, 2026-11-08]
system-1/sim/assets/so101/jaw_pieces/wrist_roll_follower_so101_v1__c0.stl
0.00847 x 0.0444 x 0.00349
