karthiksing05/robot-as-a-verifier/appliances/centrifuge/source/laser/1_single_parts_nominal/plywood_3mm/centrifuge/dial_knob_ply__x4.dxf

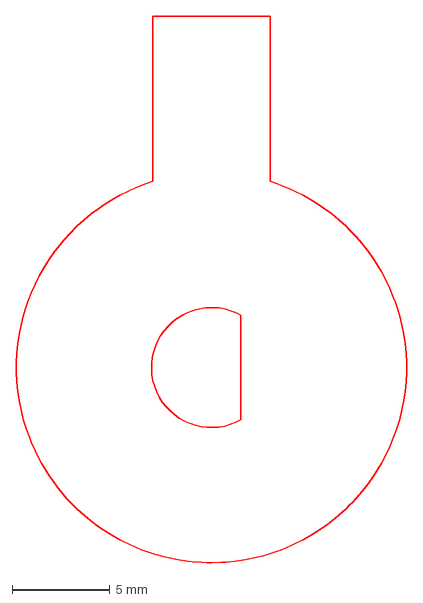
[picture p106: CAD file, 2026-11-08]
appliances/centrifuge/source/laser/1_single_parts_nominal/plywood_3mm/centrifuge/dial_knob_ply__x4.dxf
20.0 x 28.0 mm
