karthiksing05/robot-as-a-verifier/appliances/microwave/source/print/hinge_door_leaf_revB__x2.stl

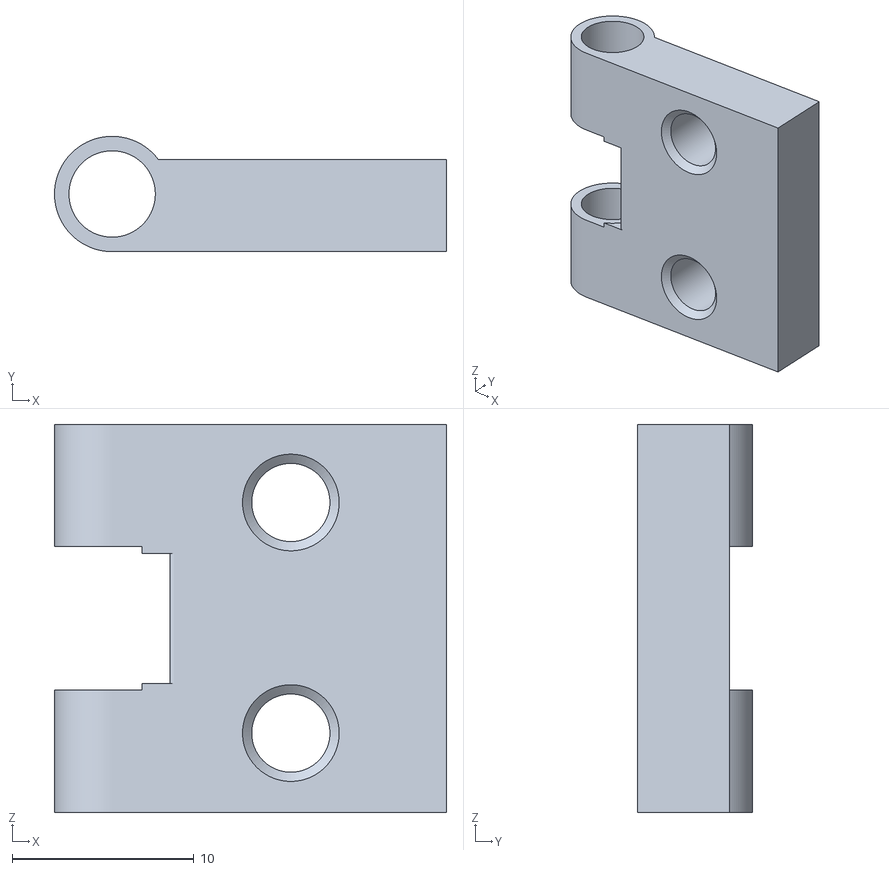
[picture p109: CAD file, 2026-11-08]
appliances/microwave/source/print/hinge_door_leaf_revB__x2.stl
21.6 x 6.35 x 21.4
