karthiksing05/robot-as-a-verifier/system-1/sim/assets/so101/assets/rotation_pitch_so101_v1.stl

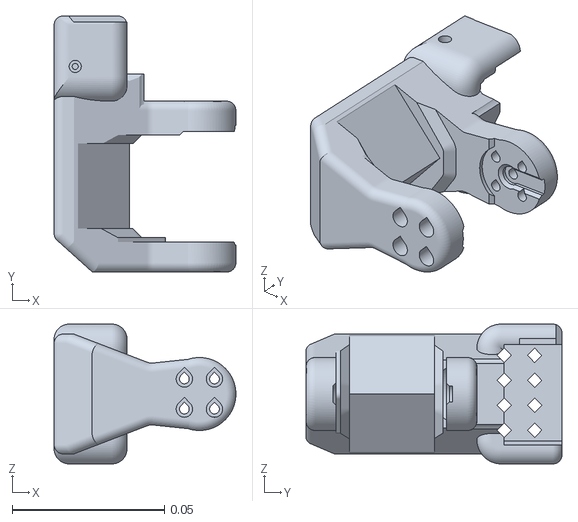
[picture p110: CAD file, 2026-11-07]
system-1/sim/assets/so101/assets/rotation_pitch_so101_v1.stl
0.0598 x 0.0842 x 0.046
