karthiksing05/robot-as-a-verifier/system-1/sim/assets/so101/jaw_pieces/moving_jaw_so101_v1__c9.stl

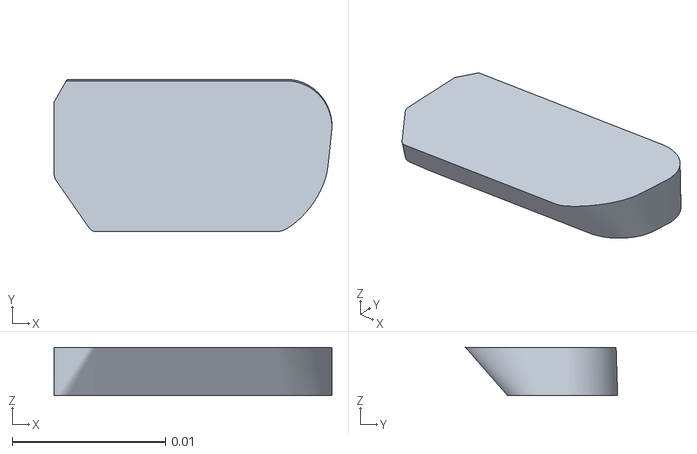
[picture p111: CAD file, 2026-11-08]
system-1/sim/assets/so101/jaw_pieces/moving_jaw_so101_v1__c9.stl
0.0181 x 0.00994 x 0.00316
