karthiksing05/robot-as-a-verifier/appliances/centrifuge/source/laser/1_single_parts_nominal/plywood_3mm/centrifuge/tube_sensor_riser_1.dxf

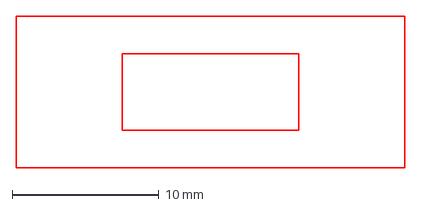
[picture p112: CAD file, 2026-11-08]
appliances/centrifuge/source/laser/1_single_parts_nominal/plywood_3mm/centrifuge/tube_sensor_riser_1.dxf
26.5 x 10.3 mm
