karthiksing05/robot-as-a-verifier/system-1/sim/assets/so101/assets/motor_holder_so101_base_v1.stl

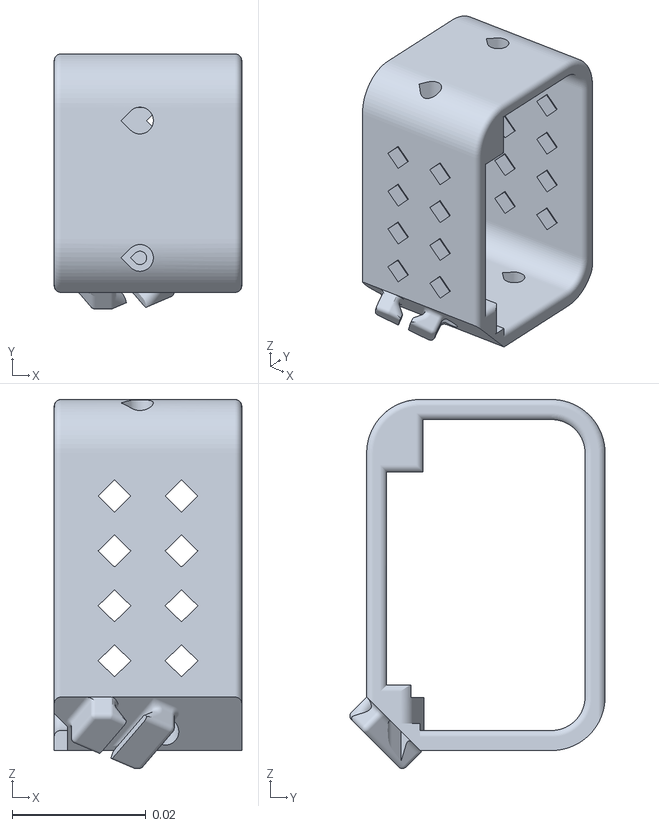
[picture p115: CAD file, 2026-11-07]
system-1/sim/assets/so101/assets/motor_holder_so101_base_v1.stl
0.028 x 0.0381 x 0.0551
