karthiksing05/robot-as-a-verifier/system-1/sim/assets/so101/jaw_pieces/wrist_roll_follower_so101_v1__c18.stl

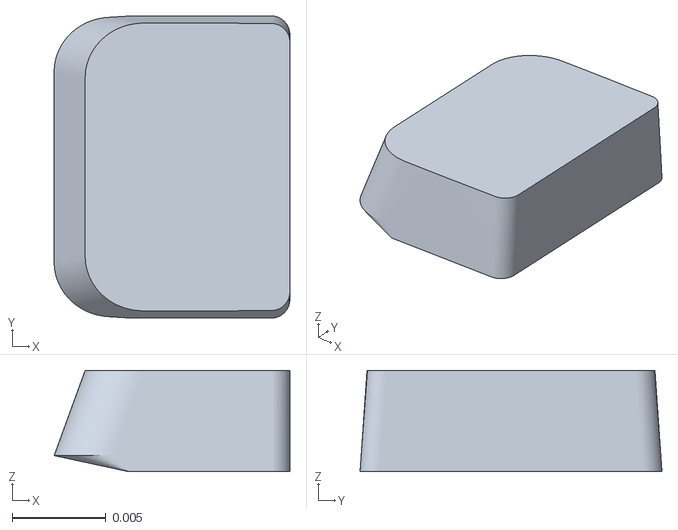
[picture p116: CAD file, 2026-11-08]
system-1/sim/assets/so101/jaw_pieces/wrist_roll_follower_so101_v1__c18.stl
0.0126 x 0.0161 x 0.00542
