karthiksing05/robot-as-a-verifier/appliances/microwave/source/print/hinge_pin_revB__x2.stl

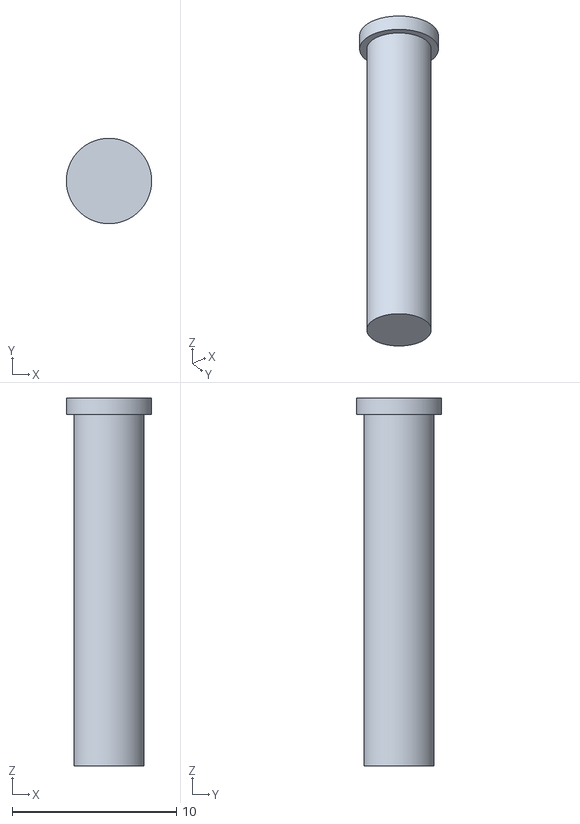
[picture p119: CAD file, 2026-11-08]
appliances/microwave/source/print/hinge_pin_revB__x2.stl
5.20 x 5.20 x 22.4
