karthiksing05/robot-as-a-verifier/system-1/sim/assets/so101/assets/sts3215_03a_no_horn_v1.stl

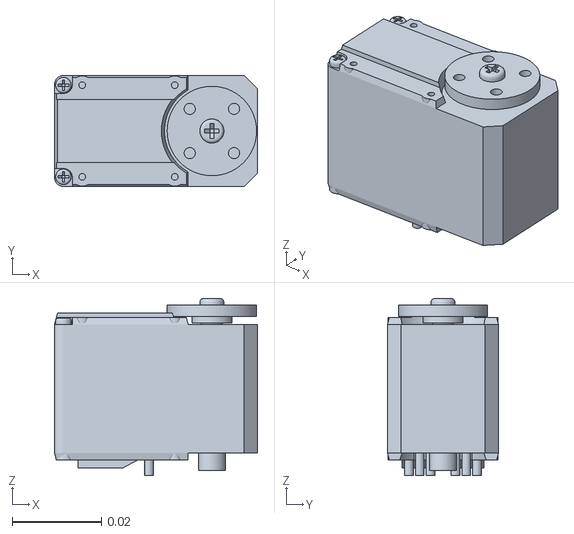
[picture p120: CAD file, 2026-11-07]
system-1/sim/assets/so101/assets/sts3215_03a_no_horn_v1.stl
0.0454 x 0.0248 x 0.0396
