karthiksing05/robot-as-a-verifier/system-1/sim/assets/so101/jaw_pieces/moving_jaw_so101_v1__c10.stl

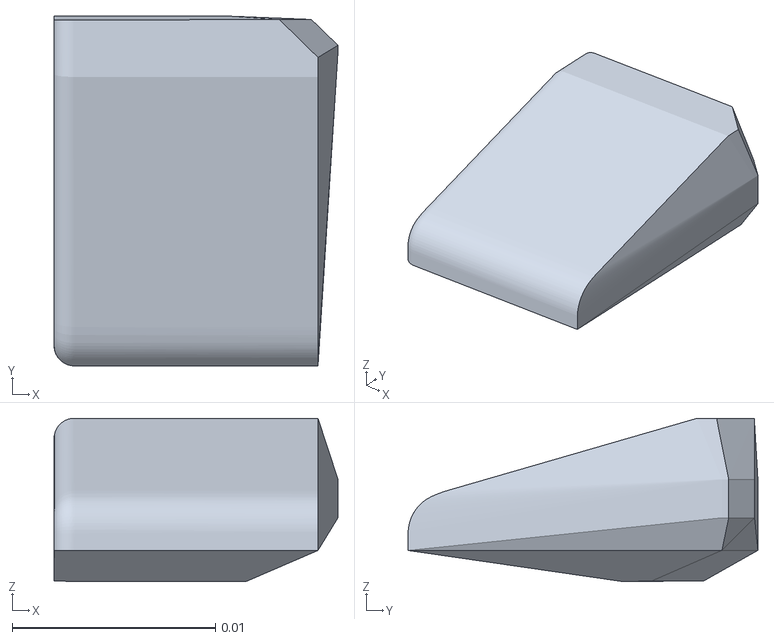
[picture p121: CAD file, 2026-11-08]
system-1/sim/assets/so101/jaw_pieces/moving_jaw_so101_v1__c10.stl
0.014 x 0.0172 x 0.00804
