karthiksing05/robot-as-a-verifier/appliances/centrifuge/source/laser/1_single_parts_nominal/plywood_3mm/centrifuge/lid_handle_revA_outer__x2.dxf

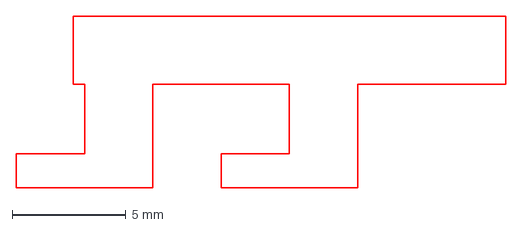
[picture p122: CAD file, 2026-11-08]
appliances/centrifuge/source/laser/1_single_parts_nominal/plywood_3mm/centrifuge/lid_handle_revA_outer__x2.dxf
21.5 x 7.55 mm
