karthiksing05/robot-as-a-verifier/appliances/microwave/source/laser/1_single_parts_nominal/plywood_3mm/lcd_shelf.dxf

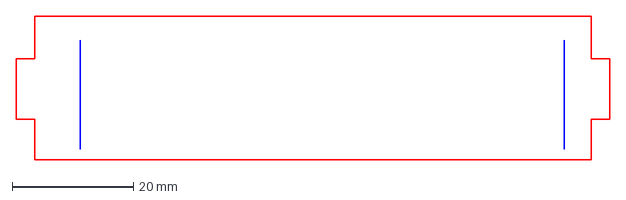
[picture p123: CAD file, 2026-11-08]
appliances/microwave/source/laser/1_single_parts_nominal/plywood_3mm/lcd_shelf.dxf
98.0 x 23.7 mm
