karthiksing05/robot-as-a-verifier/system-1/sim/assets/so101/assets/upper_arm_so101_v1.stl

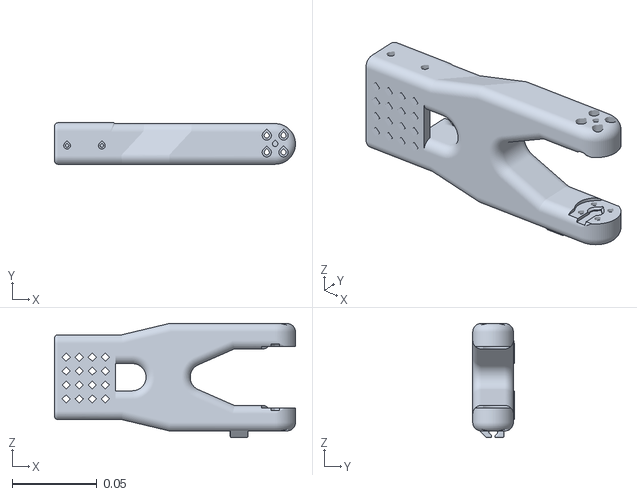
[picture p124: CAD file, 2026-11-07]
system-1/sim/assets/so101/assets/upper_arm_so101_v1.stl
0.142 x 0.0245 x 0.0673
