karthiksing05/robot-as-a-verifier/system-1/sim/assets/so101/jaw_pieces/moving_jaw_so101_v1__c13.stl

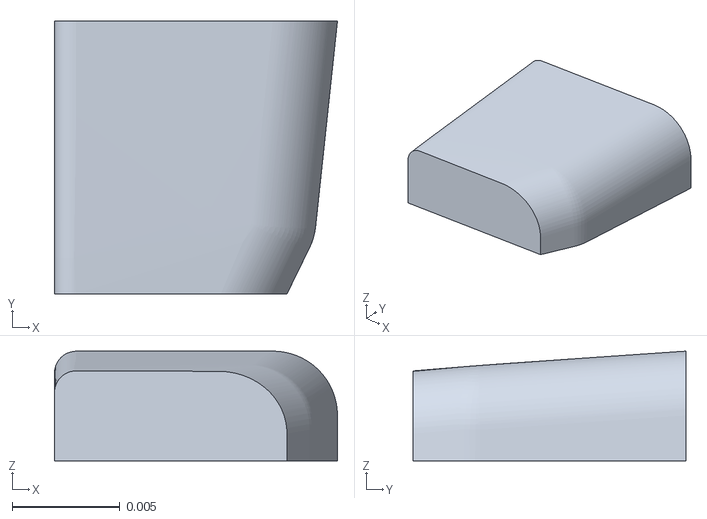
[picture p125: CAD file, 2026-11-08]
system-1/sim/assets/so101/jaw_pieces/moving_jaw_so101_v1__c13.stl
0.0131 x 0.0127 x 0.0051
