karthiksing05/robot-as-a-verifier/system-1/sim/assets/so101/assets/waveshare_mounting_plate_so101_v2.stl

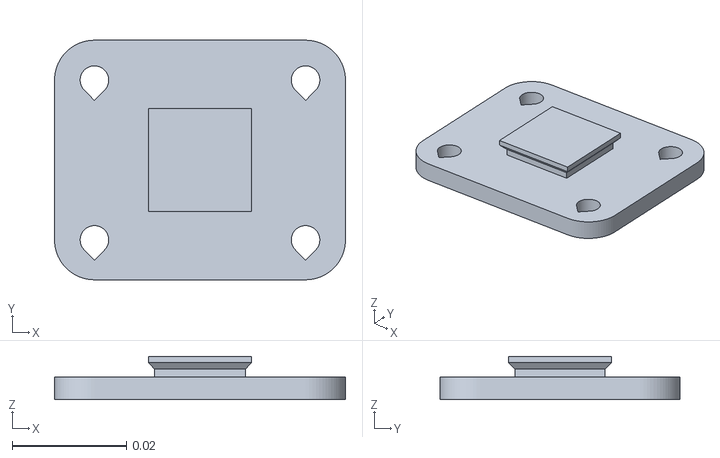
[picture p128: CAD file, 2026-11-07]
system-1/sim/assets/so101/assets/waveshare_mounting_plate_so101_v2.stl
0.051 x 0.042 x 0.0076
