karthiksing05/robot-as-a-verifier/system-1/sim/assets/so101/jaw_pieces/wrist_roll_follower_so101_v1__c4.stl

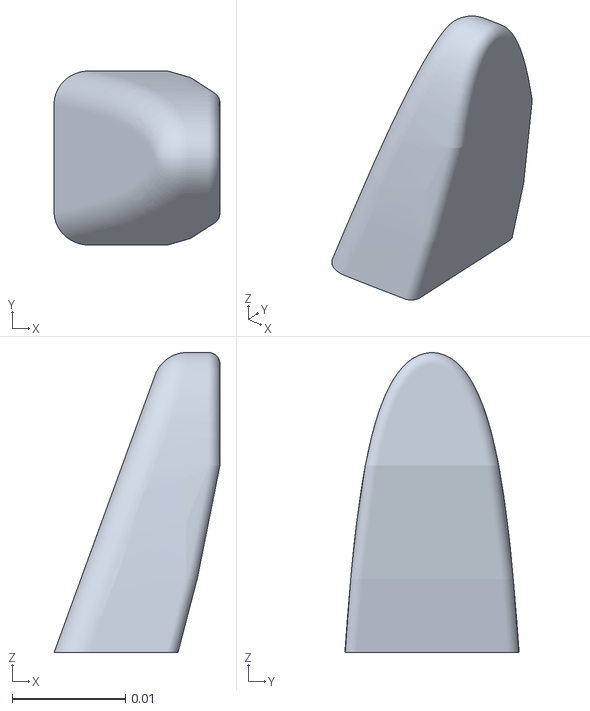
[picture p129: CAD file, 2026-11-08]
system-1/sim/assets/so101/jaw_pieces/wrist_roll_follower_so101_v1__c4.stl
0.0146 x 0.0154 x 0.0265
