karthiksing05/robot-as-a-verifier/system-1/sim/assets/so101/assets/under_arm_so101_v1.stl

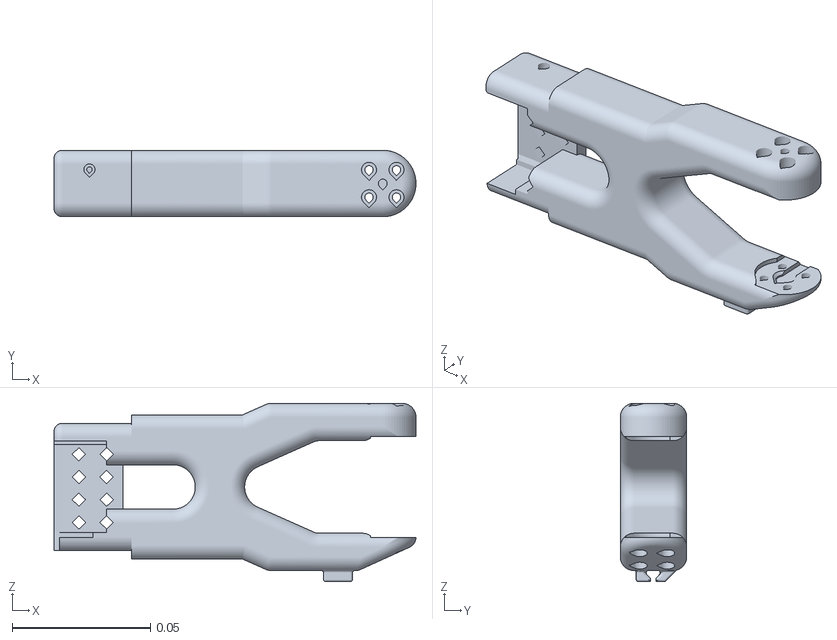
[picture p132: CAD file, 2026-11-07]
system-1/sim/assets/so101/assets/under_arm_so101_v1.stl
0.131 x 0.024 x 0.0644
