karthiksing05/robot-as-a-verifier/system-1/sim/assets/so101/assets/wrist_roll_pitch_so101_v2.stl

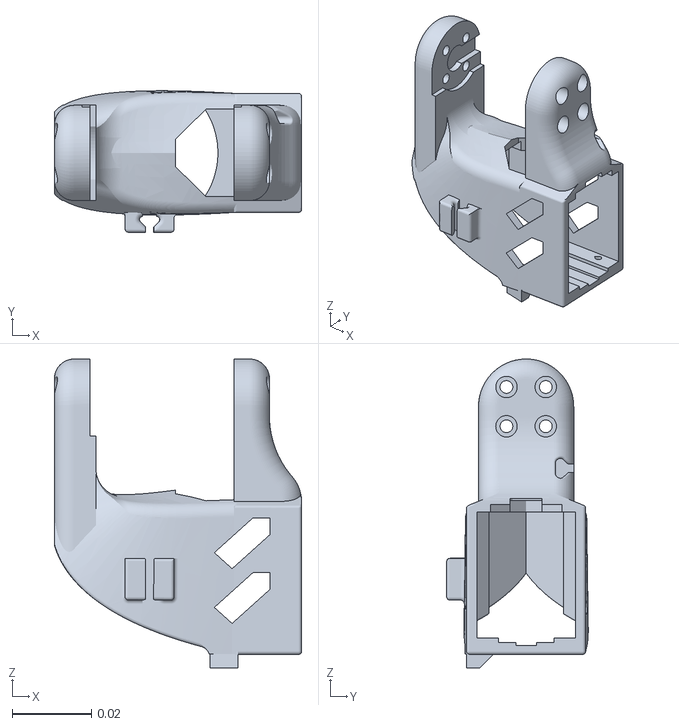
[picture p139: CAD file, 2026-11-07]
system-1/sim/assets/so101/assets/wrist_roll_pitch_so101_v2.stl
0.0623 x 0.0357 x 0.0778
