karthiksing05/robot-as-a-verifier/appliances/centrifuge/source/laser/1_single_parts_nominal/plywood_3mm/centrifuge/lid_handle_revA_middle.dxf

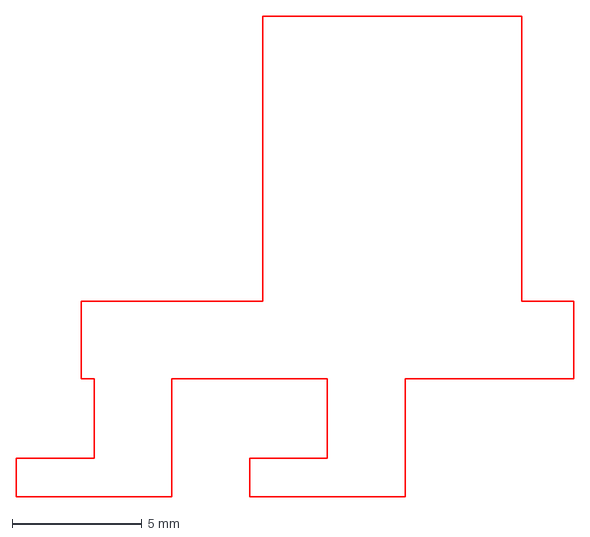
[picture p141: CAD file, 2026-11-08]
appliances/centrifuge/source/laser/1_single_parts_nominal/plywood_3mm/centrifuge/lid_handle_revA_middle.dxf
21.5 x 18.6 mm
