karthiksing05/robot-as-a-verifier/(list of files, cad)

Other CAD files:
appliances/microwave/source/step/Hinge_revB.step
appliances/centrifuge/source/print/lid_hinge_base__x1.stl
appliances/centrifuge/source/print/rack_hinge_leaf__x1.stl
appliances/centrifuge/source/print/well_insert_A_revA.stl
appliances/centrifuge/source/step/mc6_revA.step
appliances/microwave/source/print/hinge_door_leaf_revA__x2.stl
appliances/microwave/source/print/hinge_pin_revA__x2.stl
appliances/microwave/source/print/hinge_wall_leaf_revA__x2.stl
appliances/microwave/source/step/mw1_revA.step
