karthiksing05/robot-as-a-verifier/appliances/microwave/source/step/bodies.csv

body | part | material | group | volume_mm3 | mass_g_est
side_L | side_L | plywood | body | 51817.9 | 31.1
side_R | side_R | plywood | body | 50519.0 | 30.3
back | back | plywood | body | 93701.4 | 56.2
divider | divider | plywood | body | 49396.6 | 29.6
control_panel | control_panel | plywood | body | 28428.6 | 17.1
lcd_shelf | lcd_shelf | plywood | body | 6721.2 | 4.0
base | base | plywood | body | 100004.5 | 60.0
top | top | plywood | body | 100004.5 | 60.0
sensor_shelf | sensor_shelf | plywood | body | 1119.0 | 0.7
catch_shelf | catch_shelf | plywood | body | 2715.0 | 1.6
door | door | plywood | door | 31449.0 | 18.9
door_window | door_window | acrylic_clear | door | 31122.6 | 37.0
door_strike | door_strike | plywood | door | 589.4 | 0.4
hinge1_wall_leaf_revA | hinge1_wall_leaf | PLA | hinge | 1670.0 | 2.1
hinge1_door_leaf_revA | hinge1_door_leaf | PLA | door | 1773.7 | 2.2
hinge1_pin_revA | hinge1_pin | PLA | pin | 328.8 | 0.4
hinge2_wall_leaf_revA | hinge2_wall_leaf | PLA | hinge | 1670.0 | 2.1
hinge2_door_leaf_revA | hinge2_door_leaf | PLA | door | 1773.7 | 2.2
hinge2_pin_revA | hinge2_pin | PLA | pin | 328.8 | 0.4
handle | handle | PLA | door | 8743.3 | 10.8
door_catch | door_catch | PLA | body | 1314.9 | 1.6
ref_lcd_grove | lcd_grove | bought |  | 43200.0
ref_button_TIME | button_TIME | bought |  | 5679.5
ref_cap_TIME | cap_TIME | bought |  | 663.7
ref_nut_TIME | nut_TIME | bought |  | 363.2
ref_button_POWER | button_POWER | bought |  | 5679.5
ref_cap_POWER | cap_POWER | bought |  | 663.7
ref_nut_POWER | nut_POWER | bought |  | 363.2
ref_button_STOP | button_STOP | bought |  | 5679.5
ref_cap_STOP | cap_STOP | bought |  | 663.7
ref_nut_STOP | nut_STOP | bought |  | 363.2
ref_button_+30s | button_+30s | bought |  | 5679.5
ref_cap_+30s | cap_+30s | bought |  | 663.7
ref_nut_+30s | nut_+30s | bought |  | 363.2
ref_button_START | button_START | bought |  | 5679.5
ref_cap_START | cap_START | bought |  | 663.7
ref_nut_START | nut_START | bought |  | 363.2
ref_light_door | light_door | bought |  | 1049.1
ref_arduino | arduino | bought |  | 91409.5
ref_buzzer | buzzer | bought |  | 1714.4
hinge1_wall_leaf_revB | hinge1_wall_leaf | PLA | hinge | 1619.9 | 2.0
hinge1_door_leaf_revB | hinge1_door_leaf | PLA | door | 1712.3 | 2.1
hinge1_pin_revB | hinge1_pin | PLA | pin | 325.9 | 0.4
hinge2_wall_leaf_revB | hinge2_wall_leaf | PLA | hinge | 1619.9 | 2.0
hinge2_door_leaf_revB | hinge2_door_leaf | PLA | door | 1712.3 | 2.1
hinge2_pin_revB | hinge2_pin | PLA | pin | 325.9 | 0.4
