karthiksing05/robot-as-a-verifier/system-2/subjects/label-printer/preview.jpg

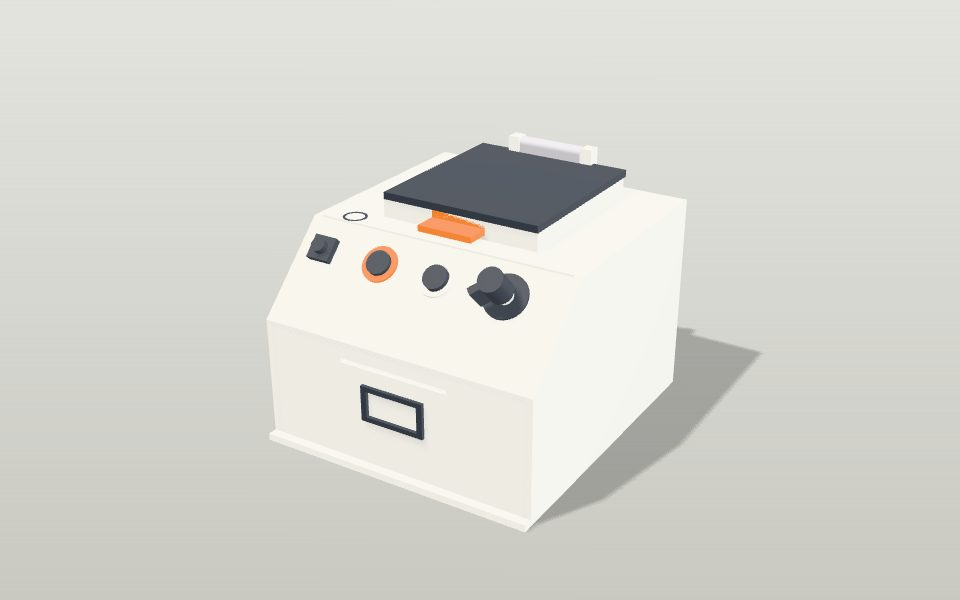
system-2/subjects/label-printer/preview.jpg
