karthiksing05/robot-as-a-verifier/system-1/hardware/real_skills.py

"""The real arm's flip, knob turns and gripper, as the hardware session ran them on the centrifuge from tools/press_part.py,
for that tool and for RealBackend: a toggle flipped in four straight moves, and a round knob gripped between the jaws and
twisted by rolling the wrist. The operator says what each did. Constants are measured on the real arm (Nov 8)."""
import numpy as np

import affordances
import skills
from rig import CONTROL_HZ

# a toggle's push came 1 cm above the POWER lever (the scan put its pivot 7 mm over the panel and its tip at 18): lowered.
# And the jaw passed the lever on its side nearer the buttons, and 5 mm further on its other side: moved this far toward +y
TOGGLE_DROP = 0.0  # 5 mm (for that scan) later caught the jaw on the lips above and below the switch
TOGGLE_Y = 0.002
# the jaw came down on the lever's top part and slid along it: it starts this much further back and pushes on further
GRIP_ABOVE = 0.025
# the jaws open to the knob's width plus GRIP_SPARE a side, its axis midway between them: a fixed 0.2 opening (about a
# 20 mm gap: 10 mm in from the fixed jaw was midway) fit the first 12 mm dial, not the 27 mm one that replaced it
# 0.15 m of gap per unit, not the model's 0.1: the tube's 0.3 opened far wider than its 18 mm collar, and centring it took
# 15 mm from the fixed jaw at 0.2 (Nov 8). At 0.1 the 27 mm dial's grip opened ~52 mm and the jaws came down beside it
GRIP_SPARE, GAP_PER_OPEN, GRIP_MAX_OPEN = 0.004, 0.15, 0.6  # m; m of jaw gap per unit of opening; the most it opens
# the jaw tips go this far over the panel (from the dial's top they stopped short), with the knob's axis this far in from
# the fixed jaw's tip: midway to the open moving jaw, about on the roll axis
# (3 mm up, on a scan whose plane read 3 mm high under SPEED, the jaws caught only the dial's top and couldn't turn it)
GRIP_FLOOR = 0.0
# the camera over the SPEED dial saw it this far uphill of the scan's position (the scan read it as a toggle's base)
# today's scans read SPEED 0.6-2.4 mm down the slope of the buttons' row it sits in (6.7, on the hardware session's,
# came in 4.3 mm high and the grip landed above the knob)
GRIP_UPHILL = 0.002
GRIP_LOOKS = 4  # looks from above the knob before going down  # a knob grip: opening, jaw tips this far down its side, start above
KNOB_GAP, KNOB_IN = 0.004, 0.001  # a knob turn comes down this far off its side, then presses this far into it
FLIP_HOVER = 0.015  # above the push's start: 30 mm along the tilted axis was out of reach
FLIP_BEHIND, FLIP_ON = 0.015, 0.003  # 6 mm back still came down on the lever tip (held 11 mm up)
# pushing up the slope (OFF to ON): 3 mm on, then 10, left the real POWER lever short of going over, and the jaw came
# down low enough to catch on the lip below the switch: the push runs FLIP_UP_LIFT higher off the panel
FLIP_ON_UP, FLIP_UP_LIFT = 0.025, 0.004  # 15 mm on still left POWER short of going over in the demo run (Nov 8)
# the push starts this high over the panel (up, down), whatever height the scan put the switch's base at: from a base
# read 14.9 mm up, 21 and 17 mm flipped 4 of 4; from one read 0.8 mm up the push ran 7 mm up and caught the lips
FLIP_PUSH_H = (0.019, 0.015)  # 2 mm lower than these runs' 21/17, further into the board (Nov 8)


def slope_swing(p):
    """A toggle's swing turned to the panel's slope: the scan read the POWER lever's 36 deg off the slope it swings
    along, and a push that far off can slide off the lever's side."""
    n, x = p.normal, p.x
    down = np.cross(n, np.cross([0.0, 0.0, -1.0], n))
    down /= np.linalg.norm(down)
    # up or down the slope only, as the manual's POWER (up = ON): a lever read leaning 3.3 mm across and 1.8 up was
    # flipped across, toward START, and refused for want of room
    snap = max((down, -down), key=lambda a: a @ x)
    p.T = p.T.copy()
    p.T[:3, :3] = np.c_[snap, np.cross(n, snap), n]
    y = np.array([0.0, 1.0, 0.0]) - n[1] * n
    move = -TOGGLE_DROP * n + TOGGLE_Y * y / np.linalg.norm(y)
    p.T[:3, 3] += move
    p.meta = {**p.meta, "tip": p.meta["tip"] + move}
    return p


def flip(arm, p, parts, snap=None, plane=None):
    """A toggle flipped in four straight moves, the gripper held as for a press (tilt and roll): to just above where the push starts, down to it, across the lever (the
    flip plan's push, past its centre), and up. No look, guarded descent or let-go moves: on the real arm those were
    ten waypoints, and contact sensing can't feel this lever anyway. The operator says whether it flipped."""
    # its neighbours left out: the plan's room check is the sim pad's, and here the push is FLIP_PUSH_H over the panel
    # (START, 30 mm across the push, refused POWER once the push went 2 mm lower, Nov 8)
    plan = affordances._flip_plan(arm, p, [p], shut_ok=True)
    if isinstance(plan, str):
        raise RuntimeError(plan)
    n, label = plan.n, f"flip {p.id}"
    a, b = plan.path(0, None)[0], plan.path(plan.length, None)[0]
    m = (b - a) / np.linalg.norm(b - a)
    up = m[2] > 0  # m rises: the push goes up the slope
    a, b = a - FLIP_BEHIND * m, b + (FLIP_ON_UP if up else FLIP_ON) * m  # down behind the lever; on far enough to go over
    if plane is not None:  # the push at FLIP_PUSH_H over the panel
        rise = FLIP_PUSH_H[0 if up else 1] - (a - plane[:3, 3]) @ n
        a, b = a + rise * n, b + rise * n
    elif up:
        a, b = a + FLIP_UP_LIFT * n, b + FLIP_UP_LIFT * n
    ax, q0 = affordances._press_axis(arm, p), plan.qs[0].copy()  # the gripper held as for a press
    q0[4] = arm.home_q[4]  # the IK keeps the roll
    _, bias = affordances._approach(arm, a + FLIP_HOVER * ax, -ax, label, q0)
    for name, to, speed in (("down", a, 0.05), ("push", b, 0.03), ("up", b + FLIP_HOVER * ax, 0.05)):
        arm.status = f"{label}: {name}"
        affordances._line(arm, to, -ax, speed, bias)
        if name == "down":  # the arm trailed the command 11 mm here and the push swept over the lever: let it arrive
            for _ in range(50):
                if np.linalg.norm(arm.tip_pose()[0] - a) < 0.0015:
                    break
                arm.send(arm.cmd)
                arm.tick()
            if snap:
                snap()  # beside the lever, about to push
    return {"verdict": "ask the operator", "stop": "done"}


def turn(arm, p, plane, angle):
    """A round knob (the SPEED dial) turned by friction: down beside its side halfway up, 1 mm into it so the grippy jaw
    presses, around its axis by angle (radians, + counter-clockwise seen from above the panel), then out and up. The
    gripper is held as for a press. The scan's knobs have no fin for affordances' turn to push."""
    n, o = plane[:3, 2], plane[:3, 3]
    c = p.pos - ((p.pos - o) @ n) * n  # the axis, on the panel
    r, h = min(p.size[:2]) / 2, p.size[2]
    down = np.cross(n, np.cross([0.0, 0.0, -1.0], n))
    down /= np.linalg.norm(down)
    side = np.cross(n, down)
    at = lambda th, rr: c + (h / 2) * n + rr * (np.cos(th) * down + np.sin(th) * side)  # from the downhill side
    ax, label = affordances._press_axis(arm, p), f"turn {p.id}"
    q0 = arm.cmd.copy()
    q0[4] = arm.home_q[4]
    start = at(0.0, r + KNOB_GAP)
    _, bias = affordances._approach(arm, start + FLIP_HOVER * ax, -ax, label, q0)
    moves = [("down", start, 0.05), ("in", at(0.0, r - KNOB_IN), 0.01)]
    k = max(2, int(abs(angle) / np.radians(10)))
    moves += [("turn", at(angle * i / k, r - KNOB_IN), 0.01) for i in range(1, k + 1)]
    moves += [("out", at(angle, r + KNOB_GAP), 0.02), ("up", at(angle, r + KNOB_GAP) + FLIP_HOVER * ax, 0.05)]
    for name, to, speed in moves:
        arm.status = f"{label}: {name}"
        affordances._line(arm, to, -ax, speed, bias)
    return {"verdict": "ask the operator", "stop": "done"}


def gripper(arm, frac, hold_s=0.6):
    """Gripper to frac of its calibrated range (0 closed, 1 open), holding the arm still while it moves. Below 0 drives
    past closed, so jaws shut on something keep squeezing it."""
    cal = arm.bus.calibration["gripper"]
    goal = max(0, int(cal.range_min + frac * (cal.range_max - cal.range_min)))
    if frac < 0:  # never past the limit the servo holds: a goal outside it was ignored and the jaws stayed open (Nov 8)
        try:
            goal = max(goal, arm.bus.read("Min_Position_Limit", "gripper", normalize=False))
        except Exception:  # noqa: BLE001
            goal = cal.range_min
    try:  # torque back on, in case an overload switched it off
        arm.bus.enable_torque(["gripper"])
    except Exception:  # noqa: BLE001
        pass
    arm.bus.sync_write("Goal_Position", {"gripper": goal},
                       normalize=False)
    for _ in range(int(hold_s * CONTROL_HZ)):
        arm.send(arm.cmd)
        arm.tick()


def grip_turn(arm, p, plane, angle, wrist=None, snap=None):
    """A round knob gripped and twisted: the gripper straight down its axis, jaws open around it, closed, the wrist
    rolled by angle (radians), opened, lifted. The jaws close on the knob about where the roll axis runs, so the roll
    turns it. The jaw tips go GRIP_FLOOR over the panel. With wrist, it first looks from above, finds the knob's round
    top (touch.locate, as a button of the knob's size) and moves over it, up to GRIP_LOOKS times."""
    import copy
    import segmodels
    import touch
    n, o = plane[:3, 2], plane[:3, 3]
    r, top = min(p.size[:2]) / 2, max((p.pos - o) @ n, p.size[2])  # the knob's radius, and its top over the panel
    shift = np.zeros(3) if arm.part_shift is None else arm.part_shift
    axis = p.pos - ((p.pos - o) @ n) * n - (shift - (shift @ n) * n)  # on the panel; a press's correction taken off
    up = np.cross(n, np.cross([0.0, 0.0, 1.0], n))
    axis += GRIP_UPHILL * up / np.linalg.norm(up)
    label, q = f"grip {p.id}", arm.cmd.copy()
    q[4] = arm.home_q[4]
    seen = copy.deepcopy(p)
    seen.kind, seen.meta = "button", {**p.meta, "radius": r}
    seen.size = np.array([2 * r, 2 * r, top])
    gap = 2 * (r + GRIP_SPARE)
    opening = min(GRIP_MAX_OPEN, gap / GAP_PER_OPEN)

    def place(axis, q):  # the tip's target so the knob's axis sits midway between the open jaws, GRIP_FLOOR up
        c = axis + GRIP_FLOOR * n
        for _ in range(3):
            arm.ik.fk(q)
            R = arm.ik.d.xmat[arm.ik.m.body("gripper").id].reshape(3, 3)
            target = c - gap / 2 * R[:, 0]
            q, ok, err, _ = arm.ik.solve(target, -n, q)
        if not ok:
            raise RuntimeError(f"{label}: out of reach ({err * 1000:.0f} mm)")
        return target, q

    gripper(arm, opening)
    for k in range(GRIP_LOOKS if wrist else 1):
        target, q = place(axis, q)
        _, bias = affordances._approach(arm, target + GRIP_ABOVE * n, -n, label, q)
        if snap:
            snap()
        if not wrist:
            break
        seen.T = seen.T.copy()
        seen.T[:3, 3] = axis + top * n
        # as tuned (hw_rig widens touch's fit for presses' last looks): with the wide fit the first look moved 9.6 mm,
        # where the tuned looks had corrected about 4 mm in all, and the grip fumbled
        tuned, touch.SHRINK, touch.RADIUS_TOL, touch.FIT_FROM_OUTLINE = (
            (touch.SHRINK, touch.RADIUS_TOL, touch.FIT_FROM_OUTLINE), 0.6, 0.0015, False)
        try:
            pos, why = touch.locate(wrist.capture(), seen, plane, segmodels.sam_boxes())
        finally:
            touch.SHRINK, touch.RADIUS_TOL, touch.FIT_FROM_OUTLINE = tuned
        if pos is None:
            print(f"  look {k}: {why}")
            break
        move = (pos - ((pos - o) @ n) * n) - axis
        print(f"  look {k}: the knob is {np.linalg.norm(move) * 1000:.1f} mm from where the grip aims")
        axis = axis + move
        if np.linalg.norm(move) < 0.001:
            break
    arm.status = f"{label}: down"
    affordances._line(arm, target, -n, 0.02, bias)
    for _ in range(50):  # the arm trails the command at the bottom; closed early, the jaws hovered over the knob
        if np.linalg.norm(arm.tip_pose()[0] - target) < 0.0015:
            break
        arm.send(arm.cmd)
        arm.tick()
    arm.bus.sync_write("Torque_Limit", {"gripper": 1000}, normalize=False)  # at LeRobot's 500 the knob slipped
    gripper(arm, 0.0)
    if snap:
        snap()  # the jaws closed on the knob, or not
    arm.status = f"{label}: turn"
    dq = np.zeros(5)
    dq[4] = angle
    skills.move_joints(arm, arm.cmd + dq)
    gripper(arm, opening, 0.4)
    arm.bus.sync_write("Torque_Limit", {"gripper": 500}, normalize=False)
    arm.status = f"{label}: up"
    affordances._line(arm, arm.tip_pose()[0] + GRIP_ABOVE * n, -n, 0.03, bias)
    gripper(arm, 0.0, 0.3)
    return {"verdict": "ask the operator", "stop": "done"}
