karthiksing05/robot-as-a-verifier/system-1/hardware/tube_find.py

"""Finding a tube in its rack with the wrist camera, for centrifuge_skills' tube_pick. The rack is its own box beside the
centrifuge, not on the panel's plane, so the panel scan never sees it. The tubes' collars are the only green and red
things there: the arm pans right from home over FIND_DQ (as the scan's survey does, further round), each photo's
collar of that colour is found by its hue, and the rays through them are triangulated with the photos' poses.

    top, why = tube_find.find(arm, wrist, "green")   # collar top in the arm's frame (m), or None and why
"""
import os
import time

import cv2
import mujoco
import numpy as np

import perceive
import rgbperceive
import skills

# joint offsets from home (pan, lift, elbow, wrist flex, roll): + pan turns the arm to its right (-y), where the rack
# stands. The survey's +0.3 had the rack at the photo's edge (Nov 8 9:33 scan, green collar at (397, -151, 65) mm); the
# wrist raised 0.25 rad looks further out, and these pans then put it low, middle and high in the photo (on the model)
# (each view's partner photo is only 15 mm over, too short a baseline for the red tube's loop: lift in and out adds 40)
# With the rack moved ~6 cm nearer (Nov 8 9:53), the raised wrist put it at the photos' bottom edge behind the jaw: the
# wrist now tips down 0.2 instead (at 0.05 the near, green tube was still at the bottom edge)
FIND_DQ = [(p, 0.0, 0.0, 0.2, 0.0) for p in (0.25, 0.4, 0.55)] + [(0.4, d, 0.0, 0.2, 0.0) for d in (-0.15, 0.15)]
# OpenCV HSV ranges (hue 0-180). The near tube's collar ring is teal-green; the far one's is red (pinkish in the
# camera). STOP's cap is red too: the blob whose ray passes nearest the others' point wins
COLOURS = {"green": [((70, 90, 50), (100, 255, 255))],
           # the red collar reads hue 170-175; the rack flap's orange tape 2-4 at lower saturation, and hue 0-8 took it
           "red": [((160, 110, 50), (180, 255, 255))]}
MIN_PX = 400               # at 1920 wide: a collar from 20 cm is 2000+
# the red collar's top on the rack read 52-57 mm up in every good search; with the rack at the photos' edge the rays met
# at a shallow angle and put it 36 mm up and 25 mm too far out (Nov 8): the rays only say where across the table
COLLAR_Z = 0.055
Z_RANGE = (0.02, 0.15)   # m above the arm's base: where a collar on a rack on the table can be
INLIER = 0.006           # m: a photo agrees with a point when its blob's ray passes this close
MAX_SPREAD = 0.006         # m: the rays must pass this close to the point they give, on average
OUT_DIR = os.path.join(os.path.dirname(os.path.abspath(__file__)), "..", "last_looks")


def blobs(frame, colour):
    """[(area px, (u, v))] of colour's blobs in frame (rig.Frame, BGR), biggest first. Closing joins a ring's halves."""
    hsv = cv2.cvtColor(frame.rgb, cv2.COLOR_BGR2HSV)
    m = np.zeros(hsv.shape[:2], np.uint8)
    for lo, hi in COLOURS[colour]:
        m |= cv2.inRange(hsv, np.array(lo), np.array(hi))
    m = cv2.morphologyEx(m, cv2.MORPH_OPEN, np.ones((5, 5), np.uint8))
    m = cv2.morphologyEx(m, cv2.MORPH_CLOSE, np.ones((25, 25), np.uint8))
    n, _, st, cen = cv2.connectedComponentsWithStats(m)
    h, w = m.shape
    whole = lambda x, y, bw, bh: x > 0 and y > 0 and x + bw < w and y + bh < h  # cut by the edge: its centre is off
    return sorted([(int(st[k, 4]), tuple(cen[k])) for k in range(1, n)
                   if st[k, 4] > MIN_PX * (w / 1920) ** 2 and whole(*st[k, :4])], reverse=True)


def ray(frame, uv):
    """The camera's centre and the unit ray through pixel uv, in the arm's frame."""
    T = frame.T_base_cam
    d = T[:3, :3] @ np.linalg.solve(frame.K, [uv[0], uv[1], 1.0])
    return T[:3, 3], d / np.linalg.norm(d)


def nearest(rays):
    """The point nearest all the rays (least squares) and its mean distance from them."""
    A, b = np.zeros((3, 3)), np.zeros(3)
    for o, d in rays:
        P = np.eye(3) - np.outer(d, d)
        A, b = A + P, b + P @ o
    x = np.linalg.solve(A, b)
    return x, float(np.mean([np.linalg.norm((np.eye(3) - np.outer(d, d)) @ (x - o)) for o, d in rays]))


def locate(frames, colour):
    """The collar's point from frames (each with T_base_cam and K), and how far the rays spread about it, or None and
    why. Every pair of blobs from photos taken at different poses proposes a point between Z_RANGE; the one that the
    most photos agree with (a blob's ray within INLIER of it) wins, refined on those. The rack's orange tape and STOP's
    cap are real objects too, so one-at-a-time pruning kept them: a vote doesn't, as the collar is in more photos."""
    seen = [(i, [(*ray(f, uv), a) for a, uv in blobs(f, colour)]) for i, f in enumerate(frames)]
    seen = [(i, rs) for i, rs in seen if rs]
    if len(seen) < 2:
        return None, None, f"{colour} collar in {len(seen)} of {len(frames)} photos: it needs two"
    off = lambda r, x: np.linalg.norm((np.eye(3) - np.outer(r[1], r[1])) @ (x - r[0]))  # noqa: E731
    best = None
    for a, (i, ra) in enumerate(seen):
        for j, rb in seen[a + 1:]:
            if i // 2 == j // 2:  # a view and its partner 15 mm over: too short a baseline to place a point
                continue
            for r1 in ra:
                for r2 in rb:
                    x, _ = nearest([r1[:2], r2[:2]])
                    if not Z_RANGE[0] < x[2] < Z_RANGE[1] or (x - r1[0]) @ r1[1] < 0 or (x - r2[0]) @ r2[1] < 0:
                        continue
                    inl = [min(rs, key=lambda r: off(r, x)) for _, rs in seen]
                    inl = [r for r in inl if off(r, x) < INLIER]
                    # by blob area, not count: the tape's folded edge (a sliver) out-voted the collar 6 to 5 (Nov 8)
                    if best is None or sum(r[2] for r in inl) > sum(r[2] for r in best):
                        best = inl
    if best is None or len(best) < 3:
        return None, None, f"no point {Z_RANGE[0] * 1000:.0f}-{Z_RANGE[1] * 1000:.0f} mm up that 3 photos' {colour} blobs agree on"
    x, spread = nearest([r[:2] for r in best])
    if COLLAR_Z is not None:  # depth along the rays is the weak part: put the point on the collar's known height
        pts = [o + (COLLAR_Z - o[2]) / d[2] * d for o, d, _ in best if abs(d[2]) > 0.2]
        if pts:
            x = np.r_[np.mean([q[:2] for q in pts], axis=0), COLLAR_Z]
    if spread > MAX_SPREAD:
        return None, None, f"the {colour} collar's rays spread {spread * 1000:.0f} mm over {len(best)} photos"
    return x, spread, ""


def find(arm, wrist, colour="green"):
    """Pan over FIND_DQ from home, photographing (the scan's views: each settled, and a partner photo beside it), then
    home. Returns the collar's top in the arm's frame, or None, and a line saying how it went. The photos with the
    blobs drawn go to OUT_DIR."""
    fk, cam = mujoco.MjData(arm.m), arm.m.camera("wrist_cam").id
    views = []
    for dq in FIND_DQ:  # as rgbperceive.survey_wrist's
        q = np.clip(arm.home_q + dq, arm.ik.lo, arm.ik.hi)
        views.append(dict(q=q, T=perceive._camera_pose(arm, fk, cam, q), ok=True, why=""))
    skills.go_home(arm)
    caps = rgbperceive.scan(arm, wrist, views, home=False)  # stays at the last view: the pick goes on from there
    frames = [c.frame for c in caps]
    x, spread, why = locate(frames, colour)
    _save(frames, colour, x)
    if x is None:
        return None, why
    return x, f"{colour} collar at {np.round(x * 1000).astype(int).tolist()} mm from {len(frames)} photos, rays within {spread * 1000:.1f} mm"


def _save(frames, colour, x):
    """Each photo with its blobs ringed and the found point (if any) as a cross, for checking by eye."""
    try:
        os.makedirs(OUT_DIR, exist_ok=True)
        stamp = time.strftime("%H%M%S")
        for i, f in enumerate(frames):
            img = f.rgb.copy()
            for _, (u, v) in blobs(f, colour):
                cv2.circle(img, (int(u), int(v)), 30, (255, 255, 255), 3)
            if x is not None:
                P = np.linalg.inv(f.T_base_cam) @ np.r_[x, 1.0]
                if P[2] > 0:
                    u, v = (f.K @ (P[:3] / P[2]))[:2]
                    cv2.drawMarker(img, (int(u), int(v)), (0, 0, 255), cv2.MARKER_CROSS, 60, 4)
            cv2.imwrite(os.path.join(OUT_DIR, f"{stamp}_tube_{colour}_{i}.jpg"), cv2.resize(img, None, fx=0.5, fy=0.5))
    except Exception as e:  # noqa: BLE001 - photos are evidence, never a reason to stop
        print(f"couldn't save the tube photos: {type(e).__name__}: {e}")
