karthiksing05/robot-as-a-verifier/system-1/hardware/http_readout.py

"""The device's readout over WiFi: the board POSTs the same snapshots the Pico prints over USB to rav-server's
/readout/<device> (the server's device_api.py), which hands each to ingest. rig.Readout, as pico_readout.PicoReadout is.

    readout = HttpReadout("mw1")                # waits for nothing: the server isn't listening yet
    rig = hw_rig.make_rig("COM5", "makecu.json", app=readout)

Before the first POST, readings and events raise SafetyStop, so no step runs blind while the board is still joining the
WiFi. After it, they behave as PicoReadout's do: events raises once nothing has come for STALE_S. The board sends a
snapshot on every change and at least every 0.5 s, as over USB.
"""
from collections import deque
import time

from safety import SafetyStop
from snapshot_readout import STALE_S, SnapshotReadout  # noqa: F401

# A board's channels under the names the scan and System 2 use, by the device name's prefix. The MC-6's others are left
# out: time counts down and state and ring follow it, and the arm's shadow can cross the lid sensor, so a verdict would
# take any of them for what the arm did.
CHANNELS = {"mc6": {"btn_start": "START", "btn_stop": "STOP", "btn_time": "TIME+", "power": "POWER", "speed": "SPEED"}}


class HttpReadout(SnapshotReadout):
    hint = ": off the WiFi, or its sketch stopped"

    def __init__(self, device, url=None, *, track_events=True):
        """device is the name in the URL. url, where the board should POST, goes in the waiting error."""
        super().__init__()
        self.device, self.source, self.closed = device, f"device '{device}' over WiFi", False
        self.url = url or f"/readout/{device}"
        self.track_events = track_events
        self.channels = CHANNELS.get(device.split("-")[0])
        self._buttons = {v for k, v in (self.channels or {}).items() if k.startswith("btn_")}  # their mapped names
        self._button_edges = deque(maxlen=32)
        self._button_seq = 0

    @property
    def started(self):
        return bool(self._readings)

    def ingest(self, new, *, replace=False):
        if self.channels and isinstance(new, dict):
            new = {self.channels.get(k, k): v for k, v in new.items() if k in self.channels or k == "LCD"}
        if not self.closed:
            super().ingest(new, track_events=self.track_events, replace=replace)

    def _record_changes(self, changes, track_events):
        super()._record_changes(changes, track_events)
        for _, channel, value in changes:
            if (channel.startswith("btn_") or channel in self._buttons) and value in (0, 1):
                self._button_seq += 1
                self._button_edges.append({"seq": self._button_seq, "channel": channel, "value": value})

    def snapshot(self):
        with self._lock:
            age = time.monotonic() - self.last if self.started else None
            return {"device_id": self.device, "readings": dict(self._readings), "lcd": self.lcd,
                    "button_edges": list(self._button_edges),
                    "age_s": round(age, 3) if age is not None else None,
                    "fresh": age is not None and age <= STALE_S and not self.closed}

    stop_when_stale = False  # the board drops off the WiFi for seconds at a time (Nov 8): warn, don't stop the arm

    def close(self):
        self.closed = True

    def _alive(self):
        super()._alive()
        if not self._readings:
            why = f"no readings yet from device '{self.device}': is it on the WiFi and posting to {self.url}?"
            if self.stop_when_stale:
                raise SafetyStop(why)
            if not getattr(self, "_warned", False):
                self._warned = True
                print(f"WARNING {why} Going on without it", flush=True)
            return
        if self.closed:
            raise SafetyStop(f"device readout closed: {self.source}")
        self._stale()
