karthiksing05/robot-as-a-verifier/(commit log)

2026-11-07 Robot as a verifier: System 1, System 2 and the Console
    [base_motor_holder_so101_v1.stl, base_so101_v2.stl, motor_holder_so101_base_v1.stl, motor_holder_so101_wrist_v1.stl, moving_jaw_so101_v1.stl, rotation_pitch_so101_v1.stl, sts3215_03a_no_horn_v1.stl, sts3215_03a_v1.stl]
2026-11-07 Put core/ on the path in real-arm.md's one-press snippet
    - Start the snippet with a sys.path line for ../core
    - Say it runs from system-1/hardware
2026-11-07 Point leftover comments and messages at core/ and hardware/
    - Send LeRobotArm's error and docstring to hardware/real_arm.py
    - Point the Skill comment and ArmBackend docstring at core/ and rig.Arm
    - Drop IK from robot.py's docstring, call frames rig.Frame, rename camera_test's SIM to CORE
    [real_cameras.py, real_wrist.py, robot.py]
2026-11-07 Show core/ and rig.Arm in the architecture page and CONTRIBUTING
    - Label the pipeline box system-1/core and its arm link rig.Arm
    - Replace the ArmBackend row with rig.Arm and name PipelineRobot in the Robot row
    - Say core/, sim/ and hardware/ stay flat modules, with core/ importing neither
2026-11-07 Correct the hand-eye note and the remaining old-layout docs
    - Say what a hand-eye calibration fixes in HANDOFF
    - Point real-arm.md's install step and integration.md at the new layout
    - Point lerobot_arm.py at rig.Arm and rig.IK
2026-11-07 Find a toggle's hinge and axis from its lever
    - Keep base cells no further out than the lever's far side when finding the hinge
    - Take the lever's axis from hinge to tip
2026-11-07 Wait until past a lever's centre before its let-go checks
    - Arm the flip's let-go checks half of FLIP_PAST beyond the scanned centre
2026-11-07 Add rav-server --robot real
    - Add RealBackend over hw_rig.make_rig, with --arm-port, --calibration and --enable-torque
    - Ask before torque goes on, and turn it off on every exit path
    - Stop the active routine on Ctrl+C before uvicorn waits on open requests
2026-11-07 Stop the real arm on Ctrl+C before the server shuts down
    - Stop RealArm taking goals in Server.handle_exit, so the routine ends at its next command
    - Turn torque off even when a second Ctrl+C cuts engine.shutdown short
    - Test that Ctrl+C mid-explore ends the routine with no further goal writes
    [main.py]
2026-11-07 Bind the server port before the real arm's torque goes on
    - Open the listening socket in main before asking about torque
    - Exit with a clear message when the port is in use
    - Pass the socket to uvicorn, and give the real backend test port 0
2026-11-07 Run the pipeline through RealArm on a simulated bus
    - Add sim_rig.make_rig(driver="real"): RealArm over fake_bus, with the sim's cameras and readout
    - Add explore.py --real-driver, with the film still drawing the sim's truth
    - Call the sim's on_tick from fake_bus so the film draws while RealArm drives
2026-11-07 Record the RealArm pipeline runs and the stiffness risk
    - Add preset C through RealArm on the simulated bus to real-arm.md, with what it does not exercise
    - Add the 18 and 72 N.m/rad runs to the servo numbers note
    - Drop the claim that SERVO_NM_PER_RAD = 36 errs safe
    [real_arm.py]
2026-11-07 Tidy the real-driver rig after review
    - Add hardware/ and its tests/ to sys.path once, after core and sim
    - Rename explore.Show's robot parameter to driver
    - Say in real-arm.md that the bus runs can't check SIGN or OFFSET_RAD
2026-11-07 Read the sim's pad through RealArm on the simulated bus
    - Add fake_bus.FakePad, the SimArm's pad reading as RealArm's pad
    - Let make_rig(driver="real") and explore.py --real-driver take --sensing tactile
    - Record the pad runs, at 36 and at 18 N.m/rad, in real-arm.md
2026-11-07 Correct the pad run numbers in real-arm.md
    - Give the servo estimate between steps at 18 N.m/rad as 0 to 9 N
    - Say RealArm read 0.7 to 1.4 N above SimArm on the first toggle flip at every seed
    - Drop the framing of the seed 0 toggle FAIL as one unlucky noise draw
2026-11-07 Add PicoReadout, a streaming device readout over USB serial
    - Add hardware/pico_readout.py, reading the Pico's JSON lines on a thread
    - Use it in hw_rig.make_rig with readout_port, and close it in RealArm.close
    - Document the line format in the firmware README, with a MicroPython main.py
2026-11-07 Stop serving a dead Pico readout and close it if torque-off fails
    - Raise on the next read of readings or events once the reader thread dies, with its error
    - Close the readout in a finally in RealArm.close()
    - Check an unplugged Pico in test_pico_readout
    [pico_readout.py, real_arm.py]
2026-11-07 Stop the step and back off when the Pico readout is lost mid-push
    - Raise rig.SafetyStop from PicoReadout's readings and events once the readout is lost
    - Skip the readout change in run_step's SafetyStop handler when the readout itself fails
    - Expect SafetyStop in test_pico_readout
    [pico_readout.py]
2026-11-07 Add which_motor.py and set P to 160 in motor_check.py
    - Add which_motor.py: find a lone motor's id at any baud rate, then nudge it out and back
    - Set the P gain to RealArm's 160 in motor_check.py before the nudge
    - List which_motor in the arm README
2026-11-07 Record the toggle fix's 16-device run on the results page
    - Add the new model's run with the toggle fix: 124 of 124 attempted tests passed
    - Replace the misses table with 1660's flakiness and what the toggle fix changed
    - Say runs aren't exactly repeatable, and add the run's raw results
2026-11-07 Add hand-eye calibration for the wrist camera
    - Add tools/hand_eye.py: torque-off board views, Park start, least-squares fit, writes hand_eye.json
    - Load T_hand_eye from hand_eye.json in real_wrist.WristCamera
    - Add a solver test and a sim check that recovers a moved camera, with joint-offset results in real-arm.md
2026-11-07 Ask before saving the hand-eye result and report its expected error
    - Raise hand_eye.py's default to 50 views and warn when the jackknife error is over 0.1 deg or 0.5 mm
    - Write hand_eye.json only after the person types yes, and have WristCamera print which file it loaded
    - Note torque-on flicker and board placement limits in real-arm.md, with the view-count study
    [real_wrist.py]
2026-11-07 Judge the hand-eye mount by where it places parts
    - Warn when the expected mount error places parts over 1 mm off at 0.2 m
    - Lower hand_eye.py's default to 30 views
    - Redo real-arm.md's view-count study as placement error
2026-11-07 Say the servo estimate crossed the cap with nothing touching
    - Give the two cap trips at 18 N.m/rad with the pad in real-arm.md
2026-11-07 Say what a lost readout does mid-push
    - Say the step stops and the arm goes home, without the cap's back-off
2026-11-07 Judge the mount at the scan's standoff, and say which parts it shifts
    - Use the 0.12 m standoff for the placement estimate
    - Say the last look re-places buttons and doors, not toggles, sliders or dials
    - Note the table was worked out at 0.2 m
2026-11-07 Say which parts a hand-eye error shifts
    - Note in HANDOFF that the last look re-places buttons and doors, not other kinds
2026-11-07 Let the analyst design new geometry in CadQuery, offline
    The analyst can now fix a product without Onshape by writing CadQuery code
    that makes a new solid for a reprintable part, in a local workspace per
    finding (rav-cad-local MCP tools). The code runs in a separate process with
    an import allowlist and a time limit; the same robot-centred checks judge
    the result, and apply writes the changed parts' STLs, the assembly and the
    code. On the centrifuge's three findings it fixed all three blind (stop
    bore, well bore, a new hook lip) for about $0.97.
    Also ported from the Onshape work since the last commit: rav analyze (the
    CAD step alone on a recorded run), the centrifuge test subject with its
    Re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
    [revA.step]
2026-11-07 Let arm_check move further and faster, and measure stiffness at P 160
    - Add --speed (up to 90 deg/s) and allow --deg up to 90; defaults stay 5 deg at 2.5 deg/s
    - Hold the arm and ask before torque-off when a move stops on a safety stop or Ctrl+C
    - Set stiffness_test.py to P 160 and stop it re-enabling torque toward a stale goal
    [stiffness_test.py]
2026-11-07 System 1: unreliable sim arm, device loader, tool-shape-aware skills, telemetry
    - 5% per-action error injection behind the MCP server (UnreliableRobot), keyed to the action
    - CAD device loader with firmware params, --device/--rev/--effector/--mount flags
    - Skills read the effector's tip shape; turn, flip, hook_pull and landing fixes; pick/place/reposition
    - Registration reports lost roots; perception accepts upright panels
    - Telemetry server for the Console (poses, scene, video feed)
    - D31 (error injection) and D32 (servo force estimate at stretched poses)
    [moving_jaw_so101_v1__c0.stl, moving_jaw_so101_v1__c1.stl, moving_jaw_so101_v1__c10.stl, moving_jaw_so101_v1__c11.stl, moving_jaw_so101_v1__c12.stl, moving_jaw_so101_v1__c13.stl, moving_jaw_so101_v1__c14.stl, moving_jaw_so101_v1__c15.stl]
2026-11-07 Appliances: track appliances/ with eleven sim devices and the device theory
    Each device has CAD, firmware, a manual written before its faults, Rev A/B and mixed revisions,
    and verify checks. Vendor centrifuge sources live in appliances/centrifuge/source/.
    Build output, the registry and held-out briefs stay ignored.
    [PARAMS.csv, PS1_centrifuge_laser_body.step, PS2_centrifuge_fixed_parts.step, PS3a_fault_inserts_revA.step, PS3b_fixed_inserts_revB.step, PS4_rack_laser.step, PS5_rack_hinge_and_tube.step, PS6_electronics_reference.step]
2026-11-07 System 2: frontier-model agent over the System 1 MCP server
    - Model clients for Snowflake Cortex (Claude, GPT-5.4, Grok), with every call on the token ledger
    - Agent loop and toolbelt: plans of skills on scanned controls, plan checks before anything moves,
    stops answered by the model, verdicts only from System 1
    - rav-agent service for the Console, evals with fair per-action error draws, rescoring, results page
    - Project records for every appliance
2026-11-07 Console: live agent view, device gallery and model results
    Start a run on any device and revision, watch reasoning, tool calls and the sim, steer or stop it.
    Wiki gains the device gallery, model rounds and the design journey.
2026-11-07 Add hand_eye's desk board as a Galaxy Tab S9 FE image
    - Add hand_eye_board_tab_s9fe.png: vision.BOARD at 245 px squares on a 2304x1440 canvas
    - Point hand_eye.py's instructions at it
2026-11-07 Show hand_eye's camera live, with the board corners and distance
    - Open a window on the real camera with detected corners and the board's distance
    - Take a view with Space and stop early with q
    - Refuse to solve from fewer than five views
2026-11-08 Stock SO-101 gripper: pick, place and hook_pull; steadier probe turns
    - Pick goes to the grip point short of the collar, ranks grips x tilts, retries blocked descents,
    squeezes torque-limited and lifts without following sag; place feels round for the bore
    - hook_pull hooks with the fixed jaw alone, follows sag, and slides back along the lip before leaving,
    so lids stay open; a lid past vertical is closed over the top
    - Toggles are modelled as base plus thin lever in the obstacle check
    - Turn releases 8 mm along the arc, so the lift no longer drags the dial
    - Stock contacts: stiff jaws, torsional friction, noslip only while holding
    Stock pick 0/5 -> 5/5, stock hook open 0/6 -> 6/6. Stock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
    [robot.py]
2026-11-08 Harness: device-theory checklist, symptom-based scoring, rounds 2c, 3 and 3b
    - record_hypothesis turns the model's description into the device-theory checklist;
    finish_run points out untested items once
    - A plan closes a routine held at a stop; refused preconditions are reported as device evidence
    - Scorer credits a finding whose failing check reads the fault's symptom, on any control;
    rounds 2, 2b and 3 rescored
    - model_rounds.json and the results page carry rounds 2c (recovery), 3 (manual-driven, Rev A),
    3b (after fixes) and a partial M1 run
2026-11-08 Add self-moving hand-eye calibration and the first joint offsets
    - Add hand_eye_auto.py: plans views around a hand-posed start and moves through them
    - Set shoulder_lift, elbow_flex and wrist_flex offsets from the hand-eye refit
2026-11-08 Harness: enforced check-back, real Snowflake prices, sturdier checklist tool
    - check-back: every change checks a device output, a look after at most five changes and at the end,
    a closing look compared with the first, and the device restored or the difference explained;
    propose_plan and amend refuse plans without it, and runs log what check-back caught
    - model_prices.json from Snowflake's consumption table (2026-11-04, Table 6b); credits and dollars
    (at an assumed $2/credit) per run and per round on the results page, backfilled
    - record_hypothesis takes the full schema and repairs near misses; only untested checklist items
    reach the model; per-run limit 600k tokens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
2026-11-08 Aim the real rig's scans with the measured camera mount
    - Add real_wrist.move_mount: moves the model's wrist_cam camera and site to hand_eye.json's mount
    - Call it in hw_rig.make_rig and build WristCamera with an identity mount
2026-11-08 Round 3c: check-back enforced, partial (3 of 5 devices); closing-look baseline fix
2026-11-08 Harness: cheaper check-back (robot takes the closing look, one-call restore), budget fix, round 4 planned
    - propose_plan(close_with_look) and propose_plan(restore); finish_run takes a missing closing look itself
    - amendments keep output checks but not the read-back rule
    - Budget splits a run label's ledger rows at gaps, so repeated labels across rounds aren't summed
    - Round 4 (Rev A, stock gripper) planned; probe rounds marked as sim references
2026-11-08 Give the real rig its desk height and standoff, and add bench checks
    - Let the arm carry table_z, workspace and standoff; RealArm sets desk 0 and a 17 cm standoff
    - Add rav-server --readout-port, arm_check --noise and tools/mount_check.py
    - Pick the camera backend without os.uname so cam_check runs on Windows
    [main.py, real_arm.py, real_cameras.py]
2026-11-08 Hold the gripper where it is whenever the arm's torque is on
2026-11-08 Set the real arm's force noise floor to the measured 0.75 N
    [real_arm.py]
2026-11-08 Move the fingertip from the probe to the fixed jaw's tip
    - Drop the probe body; put the tip site at the jaw's nub and hold the gripper closed in the sim
    - Count jaw contacts within 25 mm of the tip as fingertip, the rest as collisions
    - Size the skills' pad to the nub, clear neighbours by the jaws' width, drop the pad-based last-look and depth fixes
    - Redraw the sim's gripper mask and default the server to servo-only sensing
    [device.py, main.py, robot.py]
2026-11-08 Give the sim's RealArm driver the sim's desk and standoff
2026-11-08 Add place_check and fix the gripper hold on the fake bus
    - Add tools/place_check.py: guarded touches at five spots on a flat surface
    - Hold the gripper with sync reads and writes, which the fake bus supports
    - Keep the sim's noise floor in sim_rig.real_driver
    [real_arm.py, sim_rig.py]
2026-11-08 Keep the sim's desk, standoff and noise in the fake-bus RealArm tests
    [sim_rig.py]
2026-11-08 Stock gripper by default; pinch-turn, lever-between-jaws flip, recovery from contact
    - No probe on the real arm: --effector stock is the default in the server, harness, Console, sim_rig
    and SimBackend; a real arm refuses only --effector probe; verify.py takes --effector
    - Turn (stock): jaws pinch the knob, a first grip finds the axis, wrist roll and tip turn together
    (8/8 dials within about 10 deg, no cap trips)
    - Flip (stock): the lever sits between open jaws and an inner jaw face pushes it (20/20 on/off)
    - A contact the arm is already in may continue while it gets no deeper; go_home backs out first
    [main.py, robot.py, sim_rig.py]
2026-11-08 Put the real arm's force noise floor back to 2.5 N
    - Moving at touch speed the estimate reached 3.5 N, so 0.75 N fired contacts in mid-air
    [real_arm.py]
2026-11-08 Touch at 30 deg in place_check and refuse unreachable plans
    - Lean touches 30 deg forward: straight down is out of reach at 26 cm
    - Print every planned pose before torque goes on and refuse misses or big turns
2026-11-08 Refuse an approach the IK can't reach instead of moving to its best guess
    - Raise SafetyStop in _approach when ik.solve misses by more than 1 mm, as skills.goto does
2026-11-08 Roll the wrist so the moving jaw trails sideways pushes
    - Turn wrist_roll before planning a push so the closed moving jaw is behind the fixed jaw's end
    - Judge side_force across the push in the panel plane only; lift stays too_low's
    - Correct the docs that described the probe, its pad and the old zero-pose tip
2026-11-08 Stock hook_pull without phantom cap trips; first door-swing skill (in progress)
    - hook_pull: straight-line entry, moves ramp up over 1 s, last 8 mm slow from a fresh zero,
    swing planned from where the jaw stopped, retries higher below the lip, jaw gives along the handle
    (stock opens 18/30 -> 26-27/30, cap trips 11 -> 0; cap unchanged)
    - swing: new skill for vertical-hinge doors (gripping a D-handle), helpers prefixed _door_;
    unlatching on the microwave is still being worked on
2026-11-08 Add press_check and stop the bench tools returning into the surface
    - Add tools/press_check.py: presses stop when the tip falls 4 mm further behind its command
    - Read the lifted pose before planning and save the start pose after torque is on
    - Keep the arm holding on any error before asking to turn torque off
2026-11-08 Press straight down in press_check, gripper still leaning for reach
2026-11-08 Let press_check presses run 1 cm past the limp surface reading
2026-11-08 Add press_check --repeat to press one spot, such as a button
2026-11-08 Find the real gripper's place in the wrist image and mask it on the real rig
    - Add tools/gripper_mask.py: frames of different scenes, the region that stays still is the gripper
    - Load its gripper_px.json in hw_rig.make_rig in place of the sim's mask
2026-11-08 Load the real gripper mask from gripper_px.json in hw_rig
2026-11-08 Mark the gripper by clicking around it in gripper_mask
2026-11-08 Skills: dial direction from the furthest reading; a momentary pulse counts as a press
    _judge takes a dial's direction from its reading furthest from the start, so a regrip's back-step
    isn't read as the opposite direction. _press counts any reading that changed during the press,
    so a 0->1->0 button isn't pressed again.
2026-11-08 Detect contact by stall on the real arm's guarded moves
    - Add arm.stall_m and guard_speed; RealArm stops a push when the command's lead grows 4 mm past free motion
    - Run guarded moves at 15 mm/s there and skip checks that read the drifting force estimate
    - Start sideways pushes and touches far enough back for the stall baseline; the sim is unchanged
    [real_arm.py, sim_rig.py]
2026-11-08 Refit the real arm's shoulder, elbow and wrist offsets to the desk touches and hand-eye views
2026-11-08 Raise the real arm's hard force cap to 20 N
2026-11-08 Console: Robot As A Verifier login, academic page names, Methodology with figures
    - Login and tab title read Robot As A Verifier
    - Nav: Studies, Background, Methodology, Live Experiment, Design Analysis, Change Review,
    Revision History; every old path still resolves
    - Methodology: 14 numbered sections with figures for the architecture, the MCP server and its
    swap, planning and check-back, verdict rules, escalation, an inline 3D run replay with the
    error-injection figure, device theory, a faults-vs-cost chart per round and a design timeline
2026-11-08 Turn regrips for large angles and measures each grip itself; D33
    - _pinch_plan plans what the wrist roll allows and _pinch_turn grips again for the rest
    (up to 6 grips, to within 4 deg)
    - each grip's angle comes from the robot's own measure (the fin seen by the wrist camera, else
    the wrist's rotation while holding), never from the device's reading
    - perceive.refine records a dial fin's seen line
    - D33: the sim's contact creep is handled in the skill; impratio, cones and noslip unchanged
2026-11-08 Add scan_check: run the RGB scan on a real device and list the parts
2026-11-08 Show scan_check's camera live, tilt real-rig views up the slope, return to rest
    - Add a live wrist-camera window and a results picture of the candidates and parts
    - Let an arm set perceive.plan_views' tilts; RealArm tilts its views up the panel's slope
    - Return scan_check to the arm's limp rest pose before torque goes off
2026-11-08 Tilt the real arm's scan views up the panel's slope
2026-11-08 System 1 handoff for Joseph: stock gripper, new skills, what needs him
2026-11-08 Speed up real-rig scans: no sub-mm view re-commands, models load while it moves
    - Let an arm set rgbperceive._settle's tolerance (view_tol)
    - Skip move_joints' estimate-inertia minimum on stall arms
    - Load OWLv2 and SAM in the background at scan_check's start
2026-11-08 Console: wrist camera only; runs start on the wrist route (OWLv2 and SAM)
    The rig has no global camera, and Joseph's real System 1 perceives with
    OWLv2 and SAM, so:
    - live feeds hide the sim's phone and desk cameras; recorded runs show
    only the wrist row of cameras.mp4;
    - both start forms drop the D405 depth option and start on route rgb, and
    the rules bridge asks for the full install when PyTorch is missing;
    - the harness (launch, CLI, eval matrix) defaults to route rgb.
2026-11-08 Let the real rig scan one row of views and keep flat-reading round buttons
    - Let an arm set plan_views' looks (view_looks)
    - Classify a round, button-sized outline as a button when FLAT_BUTTONS is set; hw_rig sets it
2026-11-08 Keep real-rig extra views on the panel, call tall round parts buttons, show the panel
    - Chase extra views only for candidates on the survey's panel when FLAT_BUTTONS is set
    - Call round 12-30 mm parts under 12 mm tall buttons under that flag
    - Draw scan_check's results on the straight-on panel view
2026-11-08 Add press_part and let an arm set the survey's overview poses
2026-11-08 Centrifuge v7: Karthik's new CAD, manual and firmware, rebuilt for the sim
    Replaces the v6 sources with v7 (STEP, laser and print files, electronics,
    manual, firmware). The device file follows the firmware: faults F2 (lid
    fin with no hook lip, refused on Rev A) and F3 (well A too tight). The
    tube-seat test uses the v7 light under well A.
    In sim: lid 4/5, lid during a run 4/5, fixture workflow 4/5, 600 s cap
    OK, tube pick 2/5, place in well A 0/5 (jaws hit the top panel). Moving
    the device and the tube rack's detection still fail.
    [PARAMS.csv, PS1_centrifuge_laser_body.step, PS2_centrifuge_fixed_parts.step, PS3a_fault_inserts_revA.step, PS3b_fixed_inserts_revB.step, PS4_rack_laser.step, PS5_rack_hinge_and_tube.step, PS6_electronics_reference.step]
2026-11-08 MW-1 microwave: device, sources and a first door-swing skill
    The device on an 80 mm riser (on the bare board the wrist camera hit it),
    front to the arm. Firmware translated into device.yaml. All five buttons
    pass. swing unlatches Rev B and draws the door to 30 deg; Rev A holds at
    the force limit. Closing from 130 deg is likely beyond a 5-DOF arm, so the
    battery caps the door at about 100 deg (Karthik). Registration and the
    full battery are still to do. Registry and gallery now have 12 devices.
    [Frame.step, Hinge.step, Hinge_revB.step, acrylic_3mm_clear_sheet1_600x300.dxf, back.dxf, base.dxf, bodies.csv, catch_shelf.dxf]
2026-11-08 Handoff: wrist camera only; centrifuge v7 and microwave landed
2026-11-08 Find the real panel beside a device's flat top, and fix two scan crashes
    - Let the survey's panel fit try more planes and cap its tilt (PANEL_NZ, PANEL_PLANES, PANEL_MIN_PTS); hw_rig sets real values
    - Skip the flat-button rule for a candidate with no readings
    - Route press_part's readout question through its ask
    [hw_rig.py]
2026-11-08 Set the real arm's scan settings that pressed a real button
    - Scan from 14 cm, one row of views, camera on top (wrist roll -90 deg)
    - Take each photo after one move, without sub-mm re-commands
    - Raise the hard force cap to 30 N, above the estimate's drift on press approaches
    [real_arm.py]
2026-11-08 Shift press_part's parts by the measured camera offset and print the last look's outcome
2026-11-08 Keep #13's perceive.py on the depth route
    - Restore PROBE_CROP and the probe-shift fit that #12 removed
    - Fix the three depth-route tests that #12's 7 cm crop broke
2026-11-08 Let the real arm enable from a joint resting a little past its limit
    - Refuse enable only when a joint is more than 15 deg outside its limits
    - Update the limits test to a far-out joint and the torque test to the held gripper
2026-11-08 Fix docs and explore.py flags the merge left stale
    - Add --effector to explore.py, default stock
    - Run the README's headline commands with --sensing current
    - Drop the red-pad mount correction from touch.py's docstring and real-arm.md
    [explore.py]
2026-11-08 Run the fake-bus tests on the stock gripper
    - Give the SimArm behind RealArm effector="stock" in the fake-bus tests
    - Let the operator readout test answer each search poke
    - Limit explore.py --real-driver to --sensing current on the stock gripper
2026-11-08 Press from above, speed up free moves and perception, and film presses
    - Add press_down to tilt a press toward straight down (affordances._press_axis)
    - Run SIFT and the height sweep on threads; add tip_speed and sag_tries, real arm at 0.15 m/s and one re-command
    - press_part: photos and joints at the look and the press bottom, a film of the push, --down/--stall/--no-shift, SAM preloaded
    [real_arm.py]
2026-11-08 Turn off the real arm's hard cap on the force estimate
    - Set RealArm.hard_cap_n to infinity; the sim keeps its cap
2026-11-08 Press a quarter of the way toward straight down on the real arm
    - Set RealArm.press_down to 0.25
    - Halve press_part's camera correction to 3 mm down the panel
    [real_arm.py]
2026-11-08 Keep the sim's press direction on fake-bus arms
    - Copy sim.press_down in sim_rig and the real arm tests
2026-11-08 Run the harness, device build and camera code on Windows
    - Stop rav-server process trees with taskkill on Windows
    - Write the registry's device and manual paths with forward slashes
    - Write a soft scenario's manual into its run folder
    - Use sys.platform and forward-slash frame paths in real_cameras.py
2026-11-08 Press tilted buttons from steeper above, with a closer second look
    - Re-baseline a press's stall more than 6 mm above the part and stop on travel only past its expected top
    - Add look_close for a second last look; the real arm presses at press_down 0.4 with a look 18 mm out
    - press_part: 5.4 mm correction down the panel, --shift-scale and --close
    [real_arm.py]
2026-11-08 Press to a fixed depth, faster, several buttons per run
    - Add press_depth (real arm 9 mm, a 0.3 s hold) with a 50 mm/s push until 10 mm out
    - Drive the gripper to its closed end on enable; reuse the last look's sag bias for the press approach
    - Real arm: free moves at 0.2 m/s, no second look; press_part takes a comma-separated list of targets
    [real_arm.py, sim_rig.py]
2026-11-08 Refuse flip and turn when the gripper can't open
    - Return SHUT_WHY from the flip and turn plans on a stock arm without grip()
    - Tell the real-arm operator to shut the jaws by hand
2026-11-08 Model the stock tip's face as the nub with the jaws behind it
    - Split STOCK_TIP's face into the fixed jaw's nub and the moving jaw 1.7 mm back
    - Take touch depths and clear-spot margins from the arm's tip shape
2026-11-08 Mask the probe on probe runs and fix stale sim docs
    - Pick the wrist camera's gripper mask by effector in make_rig
    - Describe the stock gripper and wrist survey in explore.py's docstring
    - Give the servo read rate as 50 Hz in sensing.md
    [explore.py, sim_rig.py]
2026-11-08 Keep make_rig's servo stiffness out of later tests
    - Restore robot.SERVO_NM_PER_RAD after the cad-device and contact-recovery tests
2026-11-08 Close the CAD loop from a real run, and retest the fix in the sim
    The Snowflake agent's runs ended at the report. Now its findings reach the
    local CadQuery analyst, and an approved fix is retested on a patched device.
    - rav fix --run <run>, and rav eval --fix: a run's findings are matched to
    CAD controls by place (match.py recovers the device's pose from where its
    controls are), go to the local analyst, and are applied when approved
    (automatic and recorded in the sim; --approve NAME otherwise)
    - rav_cad/appliance.py: tag files for the authored appliances, generated
    from the device file and Rev A; patched_device swaps the new solids in,
    rebuilds their meshes and derives button trav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
    [appliance.py, cad_device.py]
2026-11-08 Flip the POWER toggle down in four straight moves
    - press_part flips toggles with the press orientation: above, down, across the lever, up
    - Snap the lever's swing to the panel slope, lower it 5 mm, start 15 mm behind it, settle before the push
    - Add --lean-other for a lever flipped by hand since the scan
2026-11-08 Ask at the terminal before a real arm runs a plan
    - Refuse auto-approval in run_test when System 1's robot is real
    - Have rav run and rav agent print each plan and ask for yes on a real arm
    - Add rav run --only to cut the plan to steps on given controls
2026-11-08 Add a sim-bus rehearsal server and the real-arm test plan
    - Add hardware/tools/sim_bus_server.py: rav-server --robot real on RealArm over the simulated bus
    - Write down the real path, rehearsal results, merge plan and first-session steps
2026-11-08 Keep #13's gripper mask for the wrist camera
    - Restore the mask over the jaws and the region below them
    - Drop make_rig's per-effector mask switch
2026-11-08 Record the real-arm merge decisions in the test plan
    - Set the cap, touches, press search, shift and shutdown choices
    - Update the first-session steps and safety notes to match
2026-11-08 Find START in scans and grip-turn a knob from press_part
    - Let the real-rig button rule take caps up to 14 mm tall
    - press_part --grip: look and correct over the knob, open the jaws around it, close at full torque, roll the wrist
    - press_part --knob: friction turn; film every push, down, turn and lift
2026-11-08 Track the real wrist camera's mount and gripper outline
    - Add hand_eye.json and gripper_px.json from the hardware checkout
    - Let .gitignore keep gripper_px.json
2026-11-08 Use the GPU, show the scan's progress and keep its photos
    - Install CUDA torch and torchvision on Windows
    - Load OWLv2 and SAM at startup and print each scan stage with its time
    - Save the survey review's photo, prompt and reply, and the scan's photos, in the run's folder
    - Note System 2's panel pick instead of applying it
2026-11-08 Show Haiku an upright survey with fewer surfaces, and keep each real scan
    - Turn the survey photo so the panel runs down it, and draw the three biggest surfaces and the pick
    - Give the reviewer only the surface numbers, without tilts
    - Preload SAM's automatic masks; save the real scan to last_scan.pkl and print view counts
2026-11-08 Add current MC-6 and MW-1 firmware project
2026-11-08 Draft the pitch video script and storyboard in video/
    Lead with the problem and Robot As A Verifier, then System 1 and System 2.
    Cite Lean, CompCert, seL4 and real failures in biosafety, mechanical design
    and aerospace. Robot shots are MuJoCo renders for now.
2026-11-08 Give every project a picture rendered from its CAD
2026-11-08 Calmer Console: settings panel, paged Methodology, CAD for every appliance
    - Working screens in the top bar; Background, Methodology, theme and
    operator in a settings panel behind the gear.
    - Methodology is one section per page, and Devices is a list.
    - Studies cards are quieter and show each project's picture.
    - Design Analysis shows any appliance's printed parts, Rev A or B, and lights
    up the parts each fix changes. Held-out devices only show Rev A.
    - Light mode gets its own accent fills and viewport colours.
    - Fixes overlaps and clipping at every width from 390 to 1440 px.
2026-11-08 Read the appliance over WiFi: a REST readout on rav-server, and MC-6/MW-1 POSTing to it
    The boards can now POST their readings to System 1 over WiFi as well as USB serial.
    - rav-server: POST /readout/<device> takes one flat JSON snapshot, behind RAV_DEVICE_KEY,
    which must differ from RAV_TOKEN so a board never holds the key that moves the arm.
    GET returns the latest readings for bring-up. --readout operator|serial|http picks the
    real arm's readout; serial also wires in PicoReadout, which the server never used.
    - hardware: SnapshotReadout holds the readings/events/staleness logic PicoReadout had;
    HttpReadout is the same readout fed by the endpoint, and refuses steps until the first P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
2026-11-08 Scan the real panel in one pass and show the wrist camera live
    - Plan five views across the panel and let the jaw tip come to 20 mm, with no second pass on the real rig
    - Skip SAM's automatic masks on the real rig: the same parts in 9 s instead of 43
    - Show the wrist camera, the scan's stage and the arm's status in a window
    [hw_rig.py, real_arm.py]
2026-11-08 Get to the robot sooner in the pitch script
    RAAV is named at 0:23 and footage starts at 0:26. The VLA beat covers
    VLAs at large and their few-shot limits. Formal-methods and field examples
    move to a coda before the close. Timings will be re-cut to Karthik's mp3.
2026-11-08 Go back to three scan views and the extra pass on the real arm
    - Five views in one pass put the centrifuge's buttons 10 mm high, and presses stopped short
    - Keep the 20 mm tip clearance, so the third view is reachable, and SAM's automatic masks off
    [hw_rig.py, real_arm.py]
2026-11-08 Take the real panel's extent from its plane's largest group of points
    - Add perceive.PANEL_GROUP: the extent comes from the largest group of the plane's points on a grid this fine
    - Set it to 1 cm on the real rig: two stray points stretched the centrifuge's panel to 205 mm, its middle 36 mm off
2026-11-08 Find the real SPEED knob and drop the lid latch
    - Narrow the real rig's knob rule to 10-20 mm across: SPEED reads 12 mm, the lid latch 34 mm
2026-11-08 Ask what changed on the device only after a step's test motion
    - Skip OperatorReadout's question after the approach, the last look, a wrist roll and opening the jaws
    [real_arm.py]
2026-11-08 Let the real last look accept a button's cap or bezel, and save each look
    - Widen the real rig's outline check to 40% under or 10 mm over the scanned radius; the 6 mm shift guard stays
    - Save each real look's frame with SAM's outline and the fitted circle to system-1/last_looks/
2026-11-08 Walk through the centrifuge run step by step in the pitch script
    Each step says what System 1 does and how System 2 responds, including the
    failed scan, the safety stop, the plan amendment and the refused lid. Field
    examples get real exposition, RAAV opens with a plain thesis, and the ending
    argues the method generalizes in full sentences.
2026-11-08 Tighten the pitch script's wording and explain why ETH matters
    Same facts and paths in 535 words instead of 579 (3:39). The ETH line now
    says what the hypothesis is and that many lower bounds rest on it.
2026-11-08 Flip the real POWER switch and grip-turn the SPEED knob from System 2
    - Move press_part's flip, knob turns and gripper into hardware/real_skills.py, for the tool and the server
    - RealBackend runs flips and turns with them, the operator giving the verdict; a confirmed flip records the new lean
    - rav run --angle DEG turns each knob once by that much (+ counter-clockwise from the front)
    [real_skills.py]
2026-11-08 Start the real last look's fit from SAM's outline, and keep each look to replay
    - Pick the far rim around the middle of SAM's outline on the real rig, not around the believed centre
    - Let a real look move the press 8 mm
    - Save each look's frame, part and plane next to its picture
2026-11-08 Let rav run --only POWER match a part the model named POWER_switch
2026-11-08 Stop asking to approve rav run's plans, and look for the knob as tuned
    - rav run on a real arm prints its rule plan and runs it; rav agent still asks before a model's plan
    - The knob grip's looks use touch's tuned fit, not the wider one presses' last looks now use
2026-11-08 Let the real flip plan the lever's push with the gripper shut
    - _flip_plan takes shut_ok; real_skills.flip passes it: its four straight moves flipped the real POWER switch shut
    [real_skills.py]
2026-11-08 Save the wrist camera's frame at the bottom of each real press
    - Shows where the jaw meets the cap, to tell the arm's error from the jaw sliding off STOP's domed cap
2026-11-08 Aim the real knob grip lower, and wait for the wrist camera to stop shaking
    - Cut the knob grip's uphill correction to 2 mm: today's scans read SPEED 0.6-2.4 mm low, not 6.7
    - Take a wrist photo only once two frames in a row match, then read the joints for its pose
    [real_skills.py, real_wrist.py]
2026-11-08 Refuse a real flip on a switch whose lever the scan didn't measure
2026-11-08 Flip a real switch the scan read as a knob, from its measured lever
    - real_skills.lever_from_points takes the tip from the highest measured point and the lean from the hinge to it
    - Only when that point stands 14 mm up: lower, the lever wasn't in the reading, and the flip is refused
    [real_skills.py]
2026-11-08 Let Haiku name the candidates the real scan's shape rules turned down
    - Keep rejected candidates as provisional parts (scene.rejected) on the real rig, offered at the scan review in magenta
    - Promote the ones Haiku names, as the knob or toggle build of the named kind
    - A switch read as a knob gets its lever from its measured points (perceive.lever_from_points), or is left out
2026-11-08 Never let a rejected candidate stop the scan, and print a failed scan's traceback
2026-11-08 Keep the voted panel plane when too few features lie on it
    - Skip the plane refit in _panel_plane with fewer than three features on it
    - Save the real scan's survey, views and captures to last_caps.pkl before analysis
    - Ignore last_caps.pkl
    [hw_rig.py]
2026-11-08 Scan the real panel with three views again
    - Set view_looks back to three views 50 mm apart
    - Note the tilted plane five views fitted
2026-11-08 Look at POWER from down the slope and grip SPEED lower
    - Move POWER's view 30 mm down the panel
    - Lower the knob grip's jaw tips to the scanned panel
2026-11-08 Flip the real POWER switch along the panel's slope only
    - Snap a toggle's swing to up or down the slope, never across
    [real_skills.py]
2026-11-08 Look at POWER from three views and keep the arm's own poses
    - Add views 30 mm up and down the slope over POWER, five in all
    - Never fit the real scan's camera poses from panel features
2026-11-08 Scan the real panel from six views at two steep tilts
    - Let a view look name its own tilt in plan_views
    - Photograph three columns aimed 40 deg up the slope and 10 deg down it
    - Back the camera to 160 mm and keep the jaw tip 35 mm off the panel
2026-11-08 Build the pitch video from Karthik's voiceover
    video/build renders the whole cut as one page, frame by frame: the chalk act,
    the turn, the two systems, the centrifuge walkthrough on recorded MuJoCo runs,
    and the ending, with captions timed to the recording. footage.py lays the
    footage, music.py makes a placeholder score, mix.sh mixes and muxes. Rendered
    files go to video/out/, which isn't tracked. The script gets Karthik's edits.
2026-11-08 Go back to the three-view row that scan 8 used
    - Restore view_looks, standoff and tip_clear from 5c70b6f
    - Drop the per-look tilt in plan_views
2026-11-08 Add the row up the slope to the real scan, walked as a snake
    - Scan six views: the middle row, then the row 50 mm up the slope back
2026-11-08 Swap MC-6 tube and lid sensor pins
    [MC6_firmware.ino, calibrate_mc6_sensors.py, mc6_test.cpp]
2026-11-08 Go back to the three-view row
    - Drop the second row: 50 mm up the slope looked past the panel's 40 mm top edge
2026-11-08 Print the survey's panel and the views' aim before a real scan moves
    - Print the panel centre, its extent and each view's look point
2026-11-08 Push a real flip up the slope 10 mm past the lever
    - Carry an upward flip 10 mm past the plan's end instead of 3
    [real_skills.py]
2026-11-08 Verify hotspot readout for both Arduino appliances
2026-11-08 Press real buttons 12 mm past the scanned cap top
    - Raise RealArm.press_depth from 9 to 12 mm
2026-11-08 Shift real presses 3 mm toward START
    - Add a +y term of 3 mm to RealArm.part_shift
2026-11-08 Rewrite the pitch script for a re-record: RAAV and its demo first
    Lead with what RAAV is and a demo of the centrifuge run, then the two-system
    design with VLAs as an aside, then why it matters over the Console's tools.
    Visuals carry numbers and sources, never the spoken words; the chalk arm
    points instead of writing.
2026-11-08 Let a real last look move a press 5 mm at most
    - Lower touch.SHIFT_MAX on the real rig from 8 to 5 mm
2026-11-08 Scan the real panel's row with six views 25 mm apart
    - Spread six looks evenly across the middle row, two of them covering POWER
2026-11-08 Push the real switch up from higher and further
    - Lift an upward flip's push 4 mm off the panel
    - Carry it 15 mm past the lever instead of 10
    [real_skills.py]
2026-11-08 Print the traceback of a routine's safety abort
    - Print the exception behind each safety_abort in System 1's terminal
2026-11-08 Print why a routine aborted
    - Print and log an aborted stop's reason, which a Crossing doesn't carry
2026-11-08 Bound Arduino Wi-Fi retries and prefer hostname TLS
2026-11-08 Wait up to 2 s for the real wrist camera to stop shaking
    - Raise real_wrist.STILL_S from 1 to 2 s
2026-11-08 Let the operator say which way a real flip pushes first
    - Add rav run --flip-first up|down, set on each switch's first flip step
    - Mirror the scanned lever in RealBackend when it leans against the asked push
    - Share the mirroring with the flip-back after a flip that changed the device
2026-11-08 Keep the real scan's camera 170 mm off the panel
    - Raise RealArm.standoff from 140 to 170 mm
    - Require the jaw tip 45 mm off the panel in a scan view, up from 20
2026-11-08 Drop real-scan parts off the controls' row
    - Add rgbperceive.ROW_MAX: parts and rejected candidates further along the slope from the parts' median are dropped
    - Set it to 30 mm in hw_rig for the centrifuge's one-row panel
    - Print the ids it drops
2026-11-08 Take the real survey again when its panel looks wrong
    - Add rgbperceive.survey_doubt: panel tilt, points on its plane and length against SURVEY_CHECK
    - Survey up to SURVEY_TRIES times and stop the scan if none passes
    - Set three tries and the centrifuge's bounds in hw_rig, in place of RAV_SURVEY
    [hw_rig.py]
2026-11-08 Add a step-by-step appliance sensor setup guide
    Covers keys, flashing both boards, rav-server on the hotspot (--device-host)
    or through the Vultr tunnel, and checking readings with rav readout.
2026-11-08 Build a lever from a switch's points from 10 mm up
    - Lower perceive.LEVER_MIN_H from 14 to 10 mm
2026-11-08 Stop lowering the real switch's push
    - Set real_skills.TOGGLE_DROP from 5 mm to 0
2026-11-08 Rebuild the video in Draft 9's order, previewed silent on guide timings
    RAAV and its demo lead, then the two systems with VLAs as an aside, then why it
    matters over the Console. The cold open crops to the question mark and hands
    Karthik's RAAV to the chalkboard; the chalk arm points instead of writing.
    guide_words.py times the script until the re-recorded voiceover arrives; the
    first take's build is kept as *_take1.
2026-11-08 Put the real scan's camera back at 140 mm
    - Restore RealArm.standoff 140 mm and tip_clear 20 mm
2026-11-08 Keep the real scan's camera 155 mm off the panel
    - Set RealArm.standoff to 155 mm and tip_clear to 30 mm
2026-11-08 Tell the scan review a dot on a switch's lever is the switch
    - Add the lever to the naming prompt so Haiku stops calling it a latch
2026-11-08 Keep the real scan's camera 160 mm off the panel
    - Set RealArm.standoff to 160 mm and tip_clear to 35 mm
2026-11-08 Draw what perception sees on the real rig's live window
    - Outline and name each scanned part on the undistorted wrist frame, the current target in green
    - Inset the current step's last look, cropped round the part, with a cross where the press aims
    - Move the window into live_view.py and start it from RealBackend in one line
2026-11-08 Preserve short appliance button presses and calibrate the MC-6 tube
    [MC6_firmware.ino, MW1_firmware.ino, WiFiS3.h, calibrate_mc6_sensors.py, http_readout.py, mc6_test.cpp]
2026-11-08 Revert "Turn the real knob the way --angle says"
    This reverts commit 996fc7f1c96d7c9011205a7999339796dd510bb2.
    [real_skills.py]
2026-11-08 Open the real knob grip to the scanned dial's width
    - Open the jaws to the knob's width plus 4 mm a side
    - Put the knob's axis midway between the open jaws
2026-11-08 Add a dedicated MC-6 lid calibration script
2026-11-08 Press real buttons 15 mm past the scanned cap top
    - Raise RealArm.press_depth from 12 to 15 mm
2026-11-08 Push real presses further past contact
    - Let an arm set stall_past, how far a stalled push lags before it stops
    - Set it to 6 mm on the real arm, up from 2
    [real_arm.py]
2026-11-08 Line the live window's circles up with the panel it shows
    - Add ortho_offset: warp the scan's orthophoto into the frame through the FK pose and template-match it
    - Shift the drawn parts by that offset through the principal point
    - Fall back to the plain FK pose when the panel is mostly out of view or the match hits the search edge
2026-11-08 Show the demo as a Console tour, cut hard into the chalkboard, pop up the case studies
    tour.mjs drives the Console through the Rev A run, Design Analysis and the Rev B
    run, logging each click; the video warps the recording so clicks land on their
    cues, eases the camera onto what changed and draws the cursor. Freeze frames and
    cards are gone. The case studies each get a pop-up card as they're named.
2026-11-08 Make missing appliance readout easier to diagnose
    [main.py]
2026-11-08 Let the model drive a real-arm run, from rav agent or the Console
    - Name each scan's parts from the manual inside the agent's looks, and add --reuse-scan to start from System 1's held scene
    - On a real arm, turn check-back and the closing look off and ask the model's questions at the terminal
    - Add rav up --system1 to run Console starts on an already running System 1, and say which way + turns
2026-11-08 Push the real switch at a fixed height over the panel
    - Start a flip's push 21 mm (up) or 17 mm (down) over the scanned panel
    - Pass the panel plane to real_skills.flip from RealBackend
    [real_skills.py]
2026-11-08 Centrifuge sources: Karthik's updated laser cuts, STEP, manual and photos
    [acrylic_3mm_clear_sheet1_600x300.dxf, base_plate.dxf, bodies.csv, control_face.dxf, dial_knob_ply__x4.dxf, front_panel.dxf, gusset_L.dxf, gusset_R.dxf]
2026-11-08 Look again after a missed real press instead of searching blind
    - Retry a missed press from a fresh last look, twice, on an arm with relook
    - Give the real arm relook through RealBackend's shifted refine
    - Keep the 4 mm search for arms without it
2026-11-08 Show the real arm and tonight's runs in the Console's Prod
    - List real-arm projects and runs with no sim recording in Prod, and file rav run's real-* runs under the MC-6
    - Drive Prod's Live through rav-agent only, with a model-only start form
    - Say Onshape isn't connected on Prod's CAD screen, and let a Console on 5174 reach rav-agent
2026-11-08 Centrifuge: drop the tube into well A and close the lid, both covers up
    Karthik, Nov 8: test the centrifuge with the rack cover and lid starting
    up (resting open at 105 deg), the tube dropped in, and the lid closed by
    pushing it over and down.
    - hook_pull: reaching over a lid resting past vertical, zero the force
    estimate at the entry, 40 mm above the top edge. Unzeroed, the long
    reach up read 6 N on the way in with nothing touching (D32 drift), and
    the close stopped before it started. With perfect sensing it passed.
    - verify.yaml: the workflow and F3p start with both covers up and drop
    the tube from 30 mm (lowered all the way in, the sim went unstable).
    Sim, Rev B, stock gripper,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
2026-11-08 Lower the real arm's P gain and hide sim speeds on it
    - Set the real arm's servo P gain to 130, down from 160
    - Report the real arm in System 1's telemetry
    - Hide the Console's 1x-Max speed buttons on a real arm
2026-11-08 Write run logs and traces as UTF-8
    - Open events.jsonl, report.json and model turn files with encoding=utf-8
2026-11-08 Show the real wrist camera in the Console's Prod Live
    - Publish live_view's annotated frame to telemetry as the wrist feed, encoded only while watched
    - Add Telemetry.add_feed and wire it to the real backend in main.py
    - Make the wrist feed the big panel in real Prod Live, with a fallback line and no 3D cell
2026-11-08 Add a 3D view of the real arm to the Console's Prod Live
    - Export the real arm's model with the scan's parts as discs, again after each scan
    - Stream the arm's poses from its joint readings while the 3D view is watched
    - Show the 3D view as a tile in real Prod Live that swaps with the camera on click
    [main.py]
2026-11-08 Set the real arm's D gain with its P
    - Write D 64 alongside P 160 on the five arm joints at enable
    - Give the test bus a D register
2026-11-08 Double the real arm's D gain to 128
    - Set SERVO_D from 64 to 128 with P at 160
2026-11-08 Triangulate the last look's cap from two views on the real rig
    - Take a second look frame 18 mm across the panel and triangulate the cap centre and top from both fits
    - Fall back to the single look when the rays, fitted radii or height disagree
    - Set touch.TWO_VIEW in hw_rig only; the sim's default look is unchanged
2026-11-08 Show the real scan around the arm in the Console's 3D view
    - Serve the last scan on /scan.json and /scan.bin: the height map as ~30k quantised coloured points, the panel corners and the parts
    - Draw the points, a translucent panel and named part rings in Sim3D, the step's part in amber
    - Frame the camera on the arm base and the panel when a scan arrives
2026-11-08 Lower the real arm's P gain to 120
    - Set SERVO_P from 160 to 120, keeping D at 128
2026-11-08 Set the real arm's D gain to 50
    - Set SERVO_D from 128 to 50, with P at 120
2026-11-08 Walk off, push in on RAAV and fade the real board into the drawn one
    The cold open keeps Karthik walking out of frame, follows the take's own
    push-in to an untransformed frame, then crossfades to the drawn slate under
    a cutout of his handwritten RAAV, which then rises to the top of the board.
2026-11-08 Put the real arm's gains back to P 160, D 32
    - Restore the gains tonight's landed presses ran with, to test whether P 120 / D 50 caused the misses
2026-11-08 Set the real arm's P gain to 140
    - Set SERVO_P from 160 to 140, keeping D at 32
2026-11-08 Show the scan's stages in the live window
    - Add rgbperceive.PROGRESS, fed each stage, capture, partial orthophoto, OWLv2 boxes, SAM masks, candidates and height sweeps
    - Draw the newest product in a captioned panel with a stage strip in live_view, classified parts held 20 s after the scan
    - Hide the last scan's parts while rescanning; mark a failed scan so the panel stops
2026-11-08 Take the probe out of the arm model and make the stock gripper the default
    - Remove the probe body from so101_new_calib.xml; robot.load_model(effector="probe") adds it back in the sim only
    - Default SimArm and load_model to effector="stock"
    - Point the Console's follow camera and labels at the gripper
2026-11-08 Hide the sim's wrist camera box in the real arm's 3D view
    - Add a hide list of bodies to telemetry.build_scene
    - Leave the wrist_camera body out of follow_real_arm's export
2026-11-08 Photograph the MC-6 display on the real arm and read it with Haiku
    - Add display_view: place the display from the buttons by CAD, plan a clear view, crop the photo
    - Add the display to the real scene and run observe as a photo step in RealBackend
    - Read observe photos with Haiku in System 2 and judge unmeasured lcd checks by them
2026-11-08 Aim presses with the scan offset alone
    - Drop the 3 mm toward +y from part_shift
    - Move presses 2.4 mm further down the slope
2026-11-08 Fill the two-systems frame with run data; put the case studies on one screen
    Two systems: both panels open already holding the Rev A run's controls,
    skills, peak forces, verdicts, manual lines, plan, amendment and findings,
    with the seven real tool names between them. Each part lights up as it's
    named. The model's move_joint and grade_own_step bounce off a gate, and a
    40 N press is clamped at the 15 N cap.
    Why it matters: the examples are cut to about ten seconds of script. Six
    case cards fill in on the left while the Console plays in a window on the
    right through Studies, Story, Settings and Methodology, each view labelled.
2026-11-08 Press deeper and keep the offset toward START
    - Restore the 3 mm toward +y in part_shift
    - Raise press_depth to 20 mm
2026-11-08 Set the real arm's P gain to 120
    - Lower SERVO_P from 140 to 120
    - Keep SERVO_D at the default 32
2026-11-08 Set the real arm's gains to P 160, D 16
    - Raise SERVO_P from 120 to 160
    - Halve SERVO_D to 16
2026-11-08 Add first real-arm skills for the centrifuge's lid, rack cover and tube
    - Add centrifuge_skills: lid/rack open and close, tube pick and place, aimed from STOP plus tunable offsets, every pose reach-checked first
    - Dispatch them from RealBackend.execute and offer them as actions
    - Add rav run --skill and --param, and fix sim_bus_server's missing http_readout
    [centrifuge_skills.py]
2026-11-08 Find the tube in its rack with the wrist camera
    - Add tube_find: pan right from home, find the collar by colour, triangulate its rays
    - Make tube_pick aim at the found collar instead of STOP plus the CAD offset
    - Offer tube_find and a tube param (1 green, 2 red)
2026-11-08 Aim the tube search's photos at the rack
    - Raise the wrist 0.25 rad so the rack sits mid-photo
    - Add two views lifted in and out for a 40 mm baseline
2026-11-08 Point the tube search nearer the arm
    - Tip the wrist down 0.05 rad instead of raising it 0.25 in FIND_DQ
2026-11-08 Let System 1 start from a saved scan
    - Add --load-scan PKL to rav-server
    - Make RealBackend's first explore load that scan instead of moving the arm
2026-11-08 Tip the tube search's wrist down 0.2 rad
    - Bring the near, green tube off the photos' bottom edge
2026-11-08 Keep the rack's orange tape out of the red tube search
    - Narrow the red collar's hue range to 160-180
2026-11-08 Grip the tube with a narrower, unguarded pick
    - Open the jaws to 0.2 instead of 0.3 for the tube
    - Drop the stall guard from the pick's descent
    [centrifuge_skills.py]
2026-11-08 Hand Joseph a footage list for the real arm
    What to film and screen-record (real scan and presses, Prod Live, a
    model-driven run with a person approving, close-ups, the D32 scale test,
    lid and tube, the fix loop), with commands, recording specs, safety rules,
    what the agent may and may not do, and how to hand files back.
2026-11-08 Squeeze the tube through the lift and centre it in the jaws
    - Let real_skills.gripper drive past closed with a negative fraction
    - Shut on the tube at -0.25 so the servo keeps squeezing
    - Aim the collar 15 mm from the fixed jaw
    [centrifuge_skills.py, real_skills.py]
2026-11-08 Pick the tube's point by a vote across photo pairs
    - Propose a point from each pair of blobs at different poses
    - Keep the point most photos agree with, 2-15 cm above the base
    - Refine it on the agreeing photos only
2026-11-08 Keep the arm going when the WiFi board goes quiet
    - Warn once instead of a safety stop when HttpReadout goes stale
    - Keep the stop for serial readouts
2026-11-08 Let the gripper overdrive past closed to squeeze a tube
    - Lower the gripper's Min_Position_Limit 500 ticks at enable
    - Raise its torque, current and overload limits over LeRobot's
    - Grip the tube 5 mm higher
2026-11-08 Close the gripper before overdriving it
    - Send the closed end first, so a refused overdrive still shuts
2026-11-08 Weight the tube search's vote by blob area
    - Score a proposed point by the summed area of agreeing blobs
2026-11-08 Restore the gripper's limit before the calibration check
    - Write the calibrated Min_Position_Limit back at connect, before is_calibrated
2026-11-08 Go on without the WiFi board when it never posts
    - Warn instead of a safety stop when HttpReadout has no readings yet
2026-11-08 Pull the tube pick 6 mm toward the arm
    - Move the found collar point TUBE_PULL along the line to the arm
2026-11-08 Carry the tube higher between the rack and the well
    - Lift the picked tube 120 mm instead of 70
    - Start the place 120 mm over the seat instead of 60
    - Hold the tube where the pick centres it, 15 mm from the fixed jaw
    [centrifuge_skills.py]
2026-11-08 Place the tube at the pick's tilt, 90 mm over the seat
    - Keep the pick's tilt on the arm and reuse it for the place
    - Start the place 90 mm over the seat instead of 120
2026-11-08 Add the RAAV logo, pitch slides, and a fuller README
    - docs/assets/logo.png: Karthik's chalk RAAV from the video, thickened, on transparent. logo-ink.png is the dark copy for light backgrounds.
    - README: logo header that follows GitHub's theme, the sim pipeline strip, the five-step loop with a diagram, and highlights from the Devpost write-up. The status line moves to Nov 8 to match it.
    - docs/devpost.md: the write-up the README now links to.
    - docs/pitch/slides/: five 1920x1080 slides in the Console's dark theme, with the HTML source.
2026-11-08 Aim well A 5 mm further right
    - Move WELL_A's y from -13 to -8 mm, right as seen from the arm
2026-11-08 Nudge well A and the press aim from the nearer centrifuge's runs
    - Move WELL_A 3 mm toward the arm and 3 mm right
    - Take presses 3 mm further down the slope
2026-11-08 Make the MC-6 demo order the real arm's plan
    - Add RealBackend.default_plan: tube in, lid shut, POWER on, TIME+, SPEED, START, STOP
    - Find each control by System 2's name, else by kind and place
    - Default the tube skills to the red tube
2026-11-08 Ready the lid close and the demo plan for the real run
    - Go 10 mm deeper and 6 mm further behind the lid's edge, from a start clear of the open lid
    - Lift out of the well and back toward the arm after a place
    - Drop the real dial's guessed travel, and say in the instruction that the tube and lid skills target STOP
2026-11-08 Speed up the demo skills and fix the tube grip, lid and POWER
    - Double the tube and lid skills' speeds and halve the lid's fall wait
    - Draw the lid back to 50 deg and push POWER up 10 mm further
    - Shut the gripper within the servo's limit, torque back on first
    - Stay at the tube search's last view instead of going home
    [centrifuge_skills.py, real_skills.py, tube_find.py]
2026-11-08 Offer the real arm's own skills before its first routine
    - Keep the built RealBackend on make_robot as built
    - Read extra_actions from it while the engine has no robot yet
2026-11-08 Draft 10: split the take around the video, bring the script up to date, pan out to a globe
    - The take opens on the erasing, freezes as the chalk touches the board and
    pushes in on its tip; the drawn board opens out of that point and Bayan's
    logo writes RAAV. It returns at the end: pulling out while Karthik writes
    RAAV over the closing line, then the walk-off and a fade to black.
    - Script Draft 10 follows the software as it is now: pins down (real touches
    are off), force-limited (the real cap isn't 15 N), fixed rules turn
    measurements into verdicts, the CAD fix said as done (D36), a small tool
    set with no motor command so either side can be swapped.
    - A pan-out before the close: t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
2026-11-08 Put the found collar at its known height, and let the place change tilt
    - Fix the collar's top at 55 mm and take only its position across the table from the rays
    - Try the place at other tilts when the pick's is out of reach
    - Start the place 80 mm over the seat
    [centrifuge_skills.py, tube_find.py]
2026-11-08 Bring the tube in higher and draw the lid nearly shut
    - Start the place 100 mm over the seat, from a waypoint nearer the arm and higher
    - Draw the lid down to 5 deg before letting go
2026-11-08 Make Dyson's 5,127 prototypes the centrepiece of the hardware line
    The script quotes Dyson to Fast Company (May 2007) word for word, then says
    biosafety labs and spacecraft tell the same story. On screen the software
    cards shrink, and a large Dyson card fills 5,127 cells in red during the
    quote, the last one green; Pirbright and JWST follow, smaller. Captions and
    the outro cue now treat a closing quote mark as a sentence end.
2026-11-08 Move well A 3 mm forward and 1.5 mm left
    - Set WELL_A to (-61, -6.5, -14.7)
2026-11-08 Move well A forward, away from the arm
    - Set WELL_A's x to -70: the last two nudges went toward the arm by mistake
    [centrifuge_skills.py]
2026-11-08 Drop the tube 15 mm over the seat and report the gripper's grip
    - Let go 15 mm over well A's seat instead of lowering all the way
    - Squeeze the tube 450 ticks past closed
    - Add the gripper's position and limit to the pick's result
2026-11-08 Drop the tube 10 mm higher and 3 mm further from the arm
    - Let go 25 mm over the seat
    - Move WELL_A's x to -73
2026-11-08 Drop the tube 8 mm further from the arm
    - Move WELL_A's x from -70 to -78, not -73
2026-11-08 Drop the tube 10 mm further from the arm
    - Move WELL_A's x to -80
2026-11-08 Quicker lid close and tube pick, deeper POWER push
    - Close the lid with the jaw's tip, to 30 deg, at 7-10 cm/s
    - Open the gripper as the pick starts moving, and aim 4 mm further out
    - Push POWER 2 mm lower, further into the board
2026-11-08 Script Draft 11 around the real run, and the plan for its cut
    - §3 is the real SO-101 run (agent-centrifuge-111834) in the order it ran:
    tube, lid, POWER, TIME, SPEED, START, STOP, and what it found.
    - A new §4 on fixing the design: the CAD agent's tube-adapter fix (sim) and
    the microwave's Rev A/Rev B hinges, labelled as the team's.
    - draft-plan.md: split screen, extra arm views, sync, the snap zoom.
    - The uploaded clips stay out of git.
2026-11-08 Add MW-1 microwave skills: level press, door pull and door close
    - Add hardware/microwave_skills.py with mw_press, door_open, door_close and a microwave rules plan
    - Offer them only for the microwave: SimBackend from the device file, RealBackend with --appliance microwave
    - Add the three skill names and their ActionSpecs
2026-11-08 Add a contains check for display text
    - Accept contains as a check op, and read shows, displays and similar as it
    - Evaluate it as a case-blind substring of the reading in System 1 and the soft robot
    - List it in the model's check schema
2026-11-08 Check the gripper's limit restore took before the calibration check
    - Unlock, write, read back, and retry the restore up to 3 times
    - Fail with a message naming the gripper's limit if it won't take
    [real_arm.py]
2026-11-08 Clamp the gripper shut before each step and at home
    - Shut the jaws 75 ticks past the calibrated close at each step's start and on going home
    - Skip it while a picked tube is held
    [centrifuge_skills.py]
2026-11-08 Quicker tube-to-well and lid close, and let POWER flip beside START
    - Go straight from the pick to the well and from the well to the lid, without going home
    - Flick the lid to 60 deg at 15 cm/s, wait 0.2 s, and exit the well 6 cm up, 3 cm back
    - Leave POWER's neighbours out of the real flip's plan: the sim pad's room check refused it
    [centrifuge_skills.py, real_skills.py]
2026-11-08 Use the real gripper's gap per opening for the dial grip
    - Set GAP_PER_OPEN to 0.15 m per unit, from the tube's measured openings
2026-11-08 Search for the tube further round and lower
    - Pan the tube search to 0.4, 0.55 and 0.7 rad, and its closer and farther views to 0.55
    - Tip the wrist down 0.31 rad, the most its limit allows
2026-11-08 Revert "Search for the tube further round and lower"
    This reverts commit b7da33797a54e242241f68e1cb1457695aeba80c.
    [tube_find.py]
2026-11-08 Have Haiku check the tube is in the jaws after a pick, and pick again if not
    - Ask Haiku about a wrist photo after each pick, through System 2's model client
    - Pick again, up to twice, when Haiku sees no tube and the jaws shut right up
    - Keep the tube when the jaws stopped short of shut, whatever Haiku says
    [centrifuge_skills.py]
2026-11-08 Revert "Have Haiku check the tube is in the jaws after a pick, and pick again if not"
    This reverts commit aef69ea3cc2b7017efc3f180a0db8f4e4971b74a.
    [centrifuge_skills.py]
2026-11-08 Have the demo's model check the tube is held before going on
    - Run the tube pick alone, look at its photo with get_evidence, and pick again if the jaws are empty (two more tries)
    - Then plan the remaining seven steps
2026-11-08 Spell out how the demo's model reaches the pick's photo
    - get_evidence on the step's trace_ref, then on the frame it lists
2026-11-08 Pick the tube again within the plan when Haiku sees empty jaws
    - Ask the default model about the photo after each tube_pick (survey.tube_held)
    - Put the pick back at the head of the remaining steps at the next checkpoint, up to 3 picks in all
    - Have the demo instruction propose all eight steps as one plan again
2026-11-08 Revert "Pick the tube again within the plan when Haiku sees empty jaws"
    This reverts commit 9fa77b798395b86b65db5a0804d4f62ca33f76eb.
2026-11-08 Revert "Have the demo's model check the tube is held before going on"
    This reverts commit f55ab3ba5f9ce24ac38f9eb0b17faada41b3da79.
2026-11-08 List the microwave study in the Console's real-arm environment
    - Give subjects/microwave/project.json a real entry
2026-11-08 Give the microwave study its demo instruction
    - Survey with look_up_deg=15, press with mw_press only
    - Open the door to 45 deg and close it, between the button steps
2026-11-08 Accept a 115 mm panel in the survey check
    - Lower the shortest accepted panel from 130 to 115 mm: the microwave's reads 121-124
    [hw_rig.py]
2026-11-08 Let the door skills' aim be nudged, and stop guessing the microwave's display
    - Add dx/dy/dz_mm nudges to door_open and door_close
    - Guess the display from the buttons only on the centrifuge, whose layout it uses
    - Have the microwave instruction aim the door 30 mm further from the arm
2026-11-08 Stop the real door pull past 20 N
    - Add a force_max to the microwave's _go, tared at the start
    - Give the real door pull a 20 N limit, so a held door doesn't drag the box
    [microwave_skills.py]
2026-11-08 Stop the real microwave press past 20 N
    - Give mw_press on the real arm a 20 N force stop, short of its 12 mm depth
    [microwave_skills.py]
2026-11-08 Overdrive the gripper on the microwave's handle
    - Shut the door skills' jaws 450 ticks past the calibrated close, as on the tube
2026-11-08 Press the microwave faster on the real arm, without going home between presses
    - Push at 30 mm/s, 12 mm/s over the last 6 mm, and hold 0.15 s on the real arm (the sim keeps its speeds)
    - Go straight from one mw_press to the next instead of home
2026-11-08 Fewer pauses on microwave presses, and a firmer real door pull
    - Reuse the last press's sag correction for a press right after it, and skip the clamp after a press
    - Raise the real door pull's force stop to 40 N
    - Go in round the bar at 20 mm/s on the real arm, allowing 20 mm of lag
    [microwave_skills.py]
